niektb/sluisbrinkie-eurorack-published/Sluisbrinkie Toepler+/Hardware/toepler_plus_frontpanel/toepler_plus_frontpanel.png

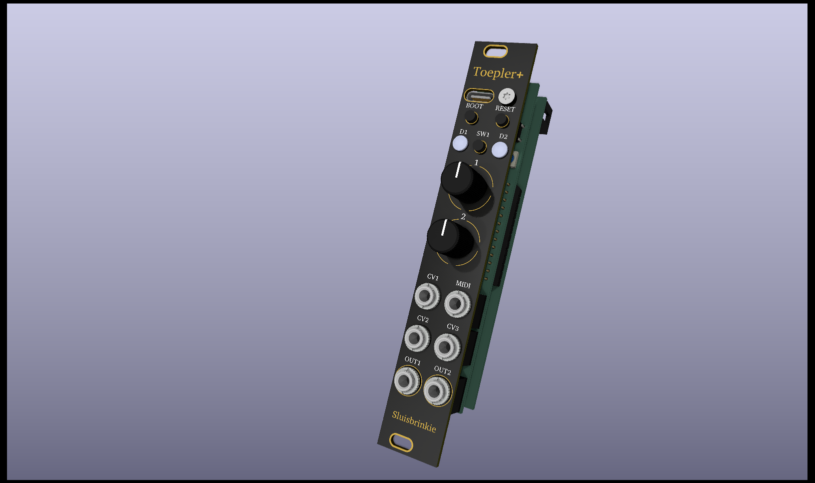
Sluisbrinkie Toepler+/Hardware/toepler_plus_frontpanel/toepler_plus_frontpanel.png
