niektb/sluisbrinkie-eurorack-published/Sluisbrinkie Toepler+/Hardware/toepler_plus_frontpanel/toepler_pro_frontpanel_backside.png

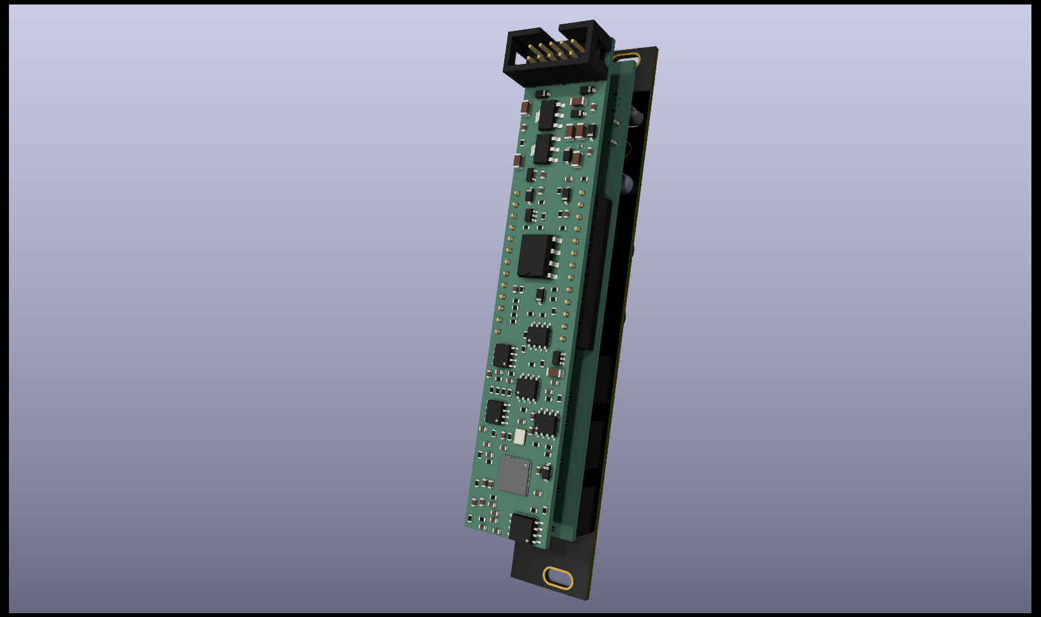
Sluisbrinkie Toepler+/Hardware/toepler_plus_frontpanel/toepler_pro_frontpanel_backside.png
