niektb/sluisbrinkie-eurorack-published/Mutable Meta Module/README.md

# Sluisbrinkie x Poetaster MMM (Mutable Meta Module)
This page (and module) is work-in-progress. Don't build it yet, it may contain mistakes :)




Hardware-platform to work in tandem with the software in this repository: https://github.com/poetaster/arduinoMI
