niektb/sluisbrinkie-eurorack-published/Sluisbrinkie Jacquard/README.md

# Jacquard
The Jacquard is a custom frontpanel for the Mutable Instruments Plaits. This directory contains the KiCad design.
