niektb/sluisbrinkie-eurorack-published/Sluisbrinkie Toepler+/README.md

# Sluisbrinkie Toepler+
The Toepler+ is the streamlined successor to the Toepler. It is one-third of the size (some features have been removed to make this possible) and has a much faster processor (RP2040 instead of Atmega32u4). The size is 4 HP. 
The upgraded processor allows for complex synthesis algorithms. MIDI support also allows the module to be truly polyphonic. The uni-color LEDs have been replaced by 2 Addressable RGB LEDs. It is compatible with both Arduino and CircuitPython, offering a friendly programming environment.
All the interfaces are located at the front of the module, meaning that nothing has to be unscrewed and removed from the rack when you want to do some programming. In fact, it can also be programmed when the rack is still powered (although pops and clicks are to be expected if the outputs are connected).
The USB connector can also be used for USB MIDI. The flash size is 128Mbit, meaning there is ample space for storing wavetables or short samples.







In case you bought a PCB (with assembled SMD components) and panel from me, there are a number of things you need to finish the build:
- 5x Thonkiconn mono jacks
- 1x Thonkiconn stereo jack
- 3x pushbuttons with at least 13mm shaft
- 2x 10kOhm Type B potentiometer (Bourns PVT09 series are used in my builds)
- 2x potentiometer knobs (see note below)
- 2x WS2812B RGB LEDs
- 1x USB-C UJ20-C-V-C-2-SMT-TR
- 1x 2x5 pinheader (for eurorack power supply)
- 2x 13p pinheader single row (for connecting back PCB to front PCB)
- 2x 13p pinsocket single row (for connecting back PCB to front PCB)
- M2.5 spacer and bolt to fixate frontpanel to front PCB (recommended to avoid stressing the PCB when plugging cables into the USB connector)

## Things that are useful to know
- To unleash the module's potential, it is recommended that you have some programming experience and enjoy programming :)
- The USB-C and ARGB LEDs need to be soldered with care. I would not recommend this project for the absolute beginners!
- This is the orientation for soldering the ARGBs:



- The jack MIDI port is receiving only, transmitting MIDI is not possible.
- The USB-C port is not capable of powering external devices.
- The voltage levels of the microcontroller are 0-3.3V. The Audio Output is DC-Coupled and ranges between 0V and 10V. The CV inputs are -5V to 5V and are mapped to the microcontroller range using attenuation and offset. 

## Software (CircuitPython)
### Flashing the firmware
Adafruit has an excellent guide on how to get started with CircuitPython and how to flash it to your board. But instead of downloading the firmware from the Adafruit website, use the firmware.uf2 from the CircuitPython\Firmware\Build folder. The config files are located in the other folder, in case you want to build from scratch (for example, to update to a newer CircuitPython version).

### Writing software
you can use the dir('board') commando to see which pins are available. Also refer to the schematic to get exact details of the implementation. I've created some examples in the CircuitPython, which are based on the synthio examples (see the Adafruit website for a good tutorial on synthio).

## Software (Arduino)
The board can be used with Arduino but needs a bit more work setting up as it's a custom board. Line 1114 - 1367 from boards.txt contain the information that you need to add to your own boards.txt file. pins_arduino.h is what you need to complete the definition of your custom board. Mozzi examples work straight out of the box. Refer to pins_arduino and the schematic to learn the pin mapping (and which pins are pre-mapped).
