niektb/sluisbrinkie-eurorack-published/Sluisbrinkie Kirchhoff/README.md

# Simple Bus Board Project
Published for Synthux Academy

58293091-4d07-4cf6-a1f3-881745db2266
Dimensions: 6cm x 10cm
