niektb/sluisbrinkie-eurorack-published/Sluisbrinkie Kepler/Schematic PDF/README.md

# Kepler Schematic
This folder contains my version of the Kastle Arp schematic. It's similar to the original schematic but made compatible with the Eurorack standard.
