niektb/sluisbrinkie-eurorack-published/Sluisbrinkie Kepler/Software/kastleSynth_1_5/README.md

This folder contains binaries for the Kastle Synth, as the official Arduino projects don't seem to work properly for the Synth. Should be flashed with AVRDUDE (or a GUI for AVRDUDE)
