niektb/sluisbrinkie-eurorack-published/Sluisbrinkie Kepler/Photo's/20240104_133646.jpg

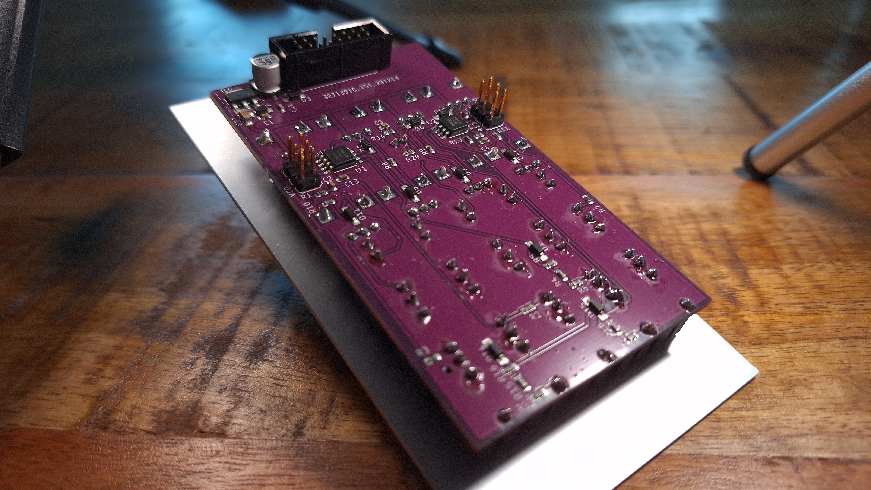
Sluisbrinkie Kepler/Photo's/20240104_133646.jpg
