niektb/sluisbrinkie-eurorack-published/Sluisbrinkie Kepler/Photo's/20240104_133847.jpg

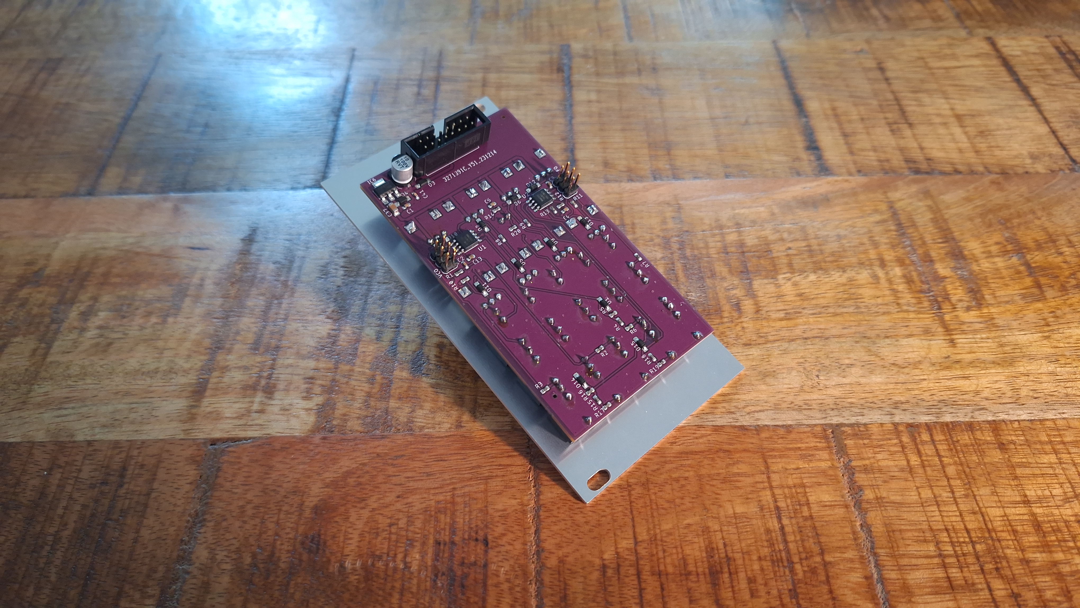
Sluisbrinkie Kepler/Photo's/20240104_133847.jpg
