niektb/sluisbrinkie-eurorack-published/Sluisbrinkie Shannon/kicad/fv1_front_module/production/bom.csv

Designator | Footprint | Quantity | Value | LCSC Part #
_26, _25, _24, _23, _22, _21, _20, _19, _18, _17, _16, _15, _14, _13, _12, _11, _10, _9, _8, _7, _6, _5, _4, _3, _2, |  | 26
