niektb/sluisbrinkie-eurorack-published/Mutable Meta Module/Hardware/kicad/mmm_frontpanel/production/bom.csv

Designator | Footprint | Quantity | Value | LCSC Part #
_18, _17, _16, _15, _14, _13, _12, _11, _10, _9, _8, _7, _6, _5, _4, _3, _2, |  | 18
