niektb/sluisbrinkie-eurorack-published/Andes/Hardware/andes_8hp/front_pcb/front_pcb.step

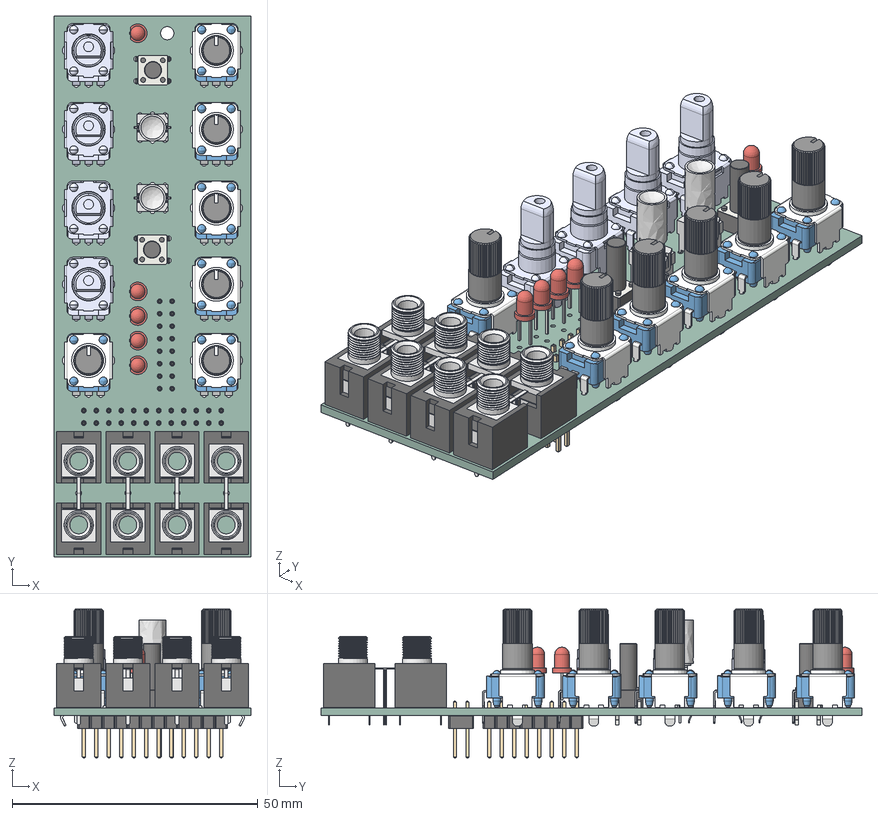
[picture p7: CAD file, 2024-09-19]
Andes/Hardware/andes_8hp/front_pcb/front_pcb.step
40.0 x 110.0 x 30.3 mm
RK09D1130-F20 x 4
P:\E-Switch Secure\3D_MODELS_STP_FORMAT\LP4xx1PBCxx.stp x 2
Thonkiconn - PJ398SM v10 x 8
SW_PUSH_6mm_h13mm x 2
R0904N-L-20KQ_Scket x 6
LED_D3.0mm x 5
PinHeader_2x12_P254mm_Vertical
PinHeader_2x08_P254mm_Vertical
_autosave-front_pcb_PCB
