niektb/sluisbrinkie-eurorack-published/Andes/Hardware/andes_8hp/frontpanel/frontpanel.step

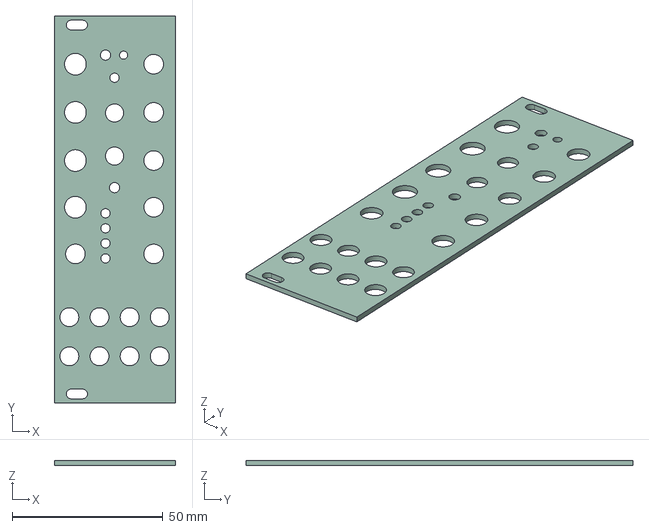
[picture p8: CAD file, 2024-09-18]
Andes/Hardware/andes_8hp/frontpanel/frontpanel.step
40.3 x 128.5 x 1.60 mm
