niektb/sluisbrinkie-eurorack-published/Eurorack Case/tiny-rack-2x44hp_locrius_mod.stl

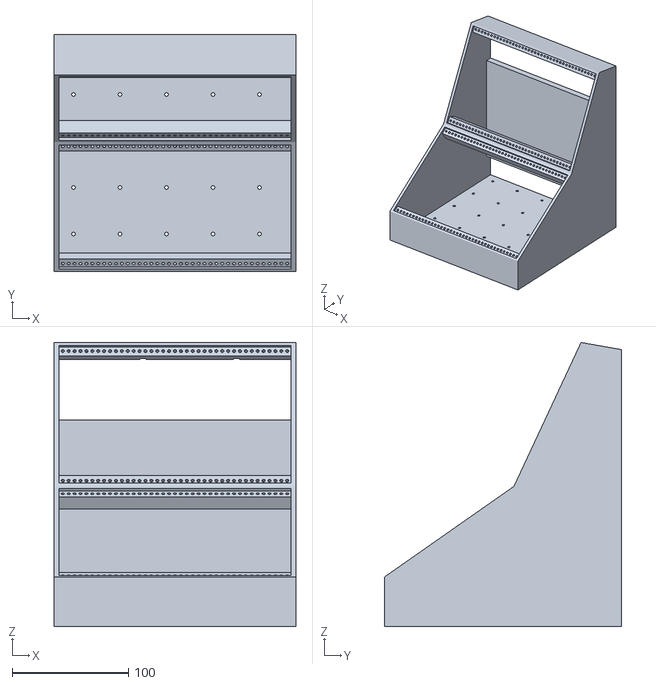
[picture p9: CAD file, 2024-06-02]
Eurorack Case/tiny-rack-2x44hp_locrius_mod.stl
207.9 x 204.0 x 244.3
