niektb/sluisbrinkie-eurorack-published/Sluisbrinkie Braun/Hardware/PI_SCOPE/TFT_320x240_touch_r0.step

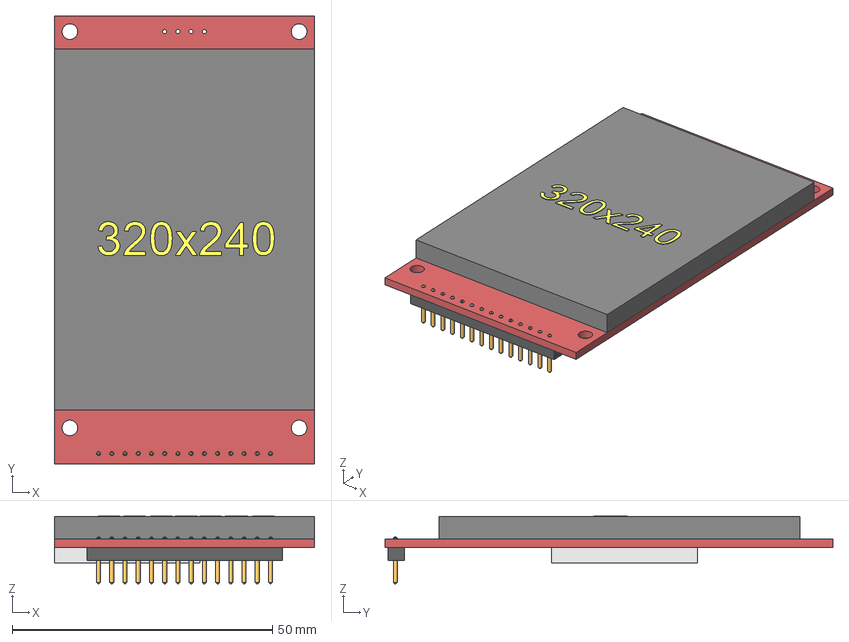
[picture p10: CAD file, 2025-04-17]
Sluisbrinkie Braun/Hardware/PI_SCOPE/TFT_320x240_touch_r0.step
50.0 x 86.0 x 13.1 mm
Body-header
Body-pins
Body-display
Body-sdcard
Body-board
