niektb/sluisbrinkie-eurorack-published/Sluisbrinkie Herford/kicad/herford/herford.step

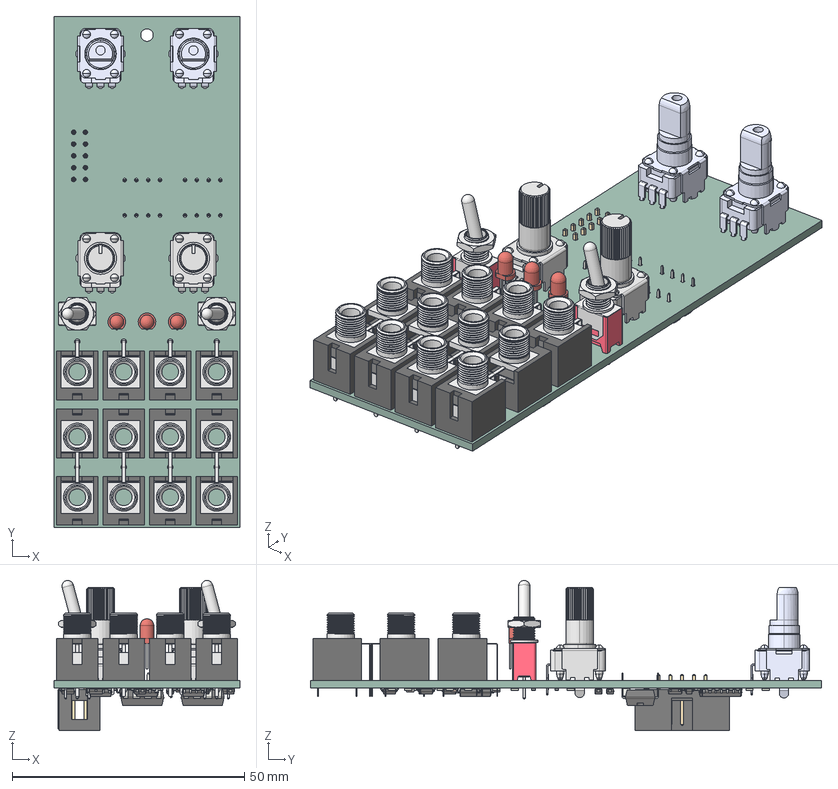
[picture p11: CAD file, 2025-04-24]
Sluisbrinkie Herford/kicad/herford/herford.step
40.0 x 110.0 x 32.3 mm
Thonkiconn - PJ398SM v10 x 12
RK09D1130-F20 x 2
Taiway sub miniature switch spdt v3 x 2
LED_D3.0mm x 3
RK09K1130-20 x 2
SOT_23 x 4
D_SOD_123 x 10
C_0603_1608Metric x 7
DIP-8_W7.62mm x 2
R_0603_1608Metric x 55
SOIC_8_39x49mm_P127mm x 3
SOIC_14_39x87mm_P127mm x 2
C_1206_3216Metric x 2
IDC_Header_2x05_P254mm_Vertical
ssg_PCB
