niektb/sluisbrinkie-eurorack-published/Sluisbrinkie Shannon/kicad/fv1_module/STEP/Thonkicon.obj

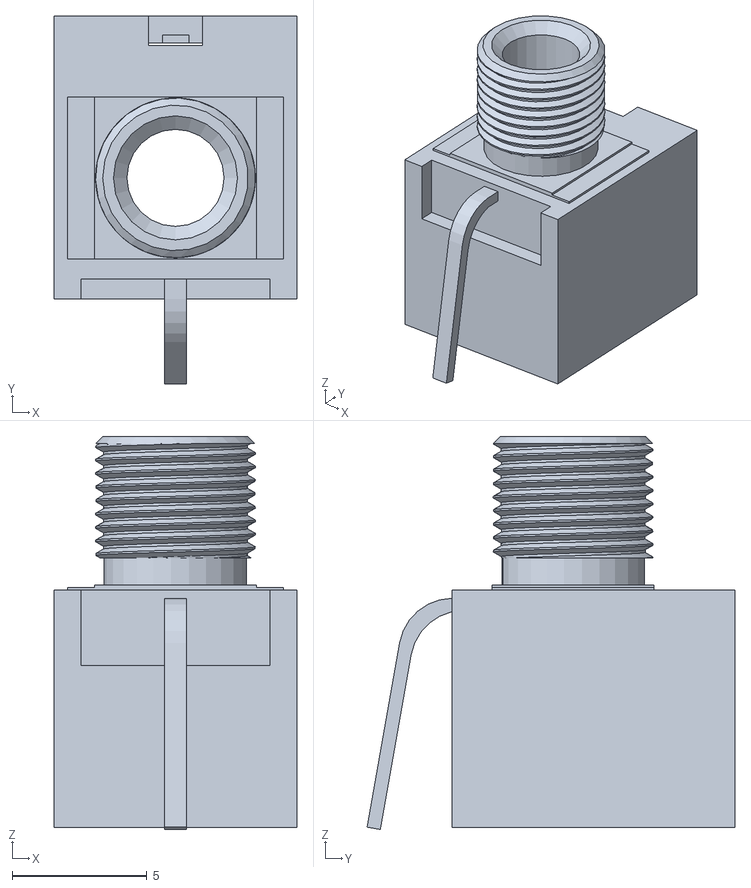
[picture p12: CAD file, 2025-11-06]
Sluisbrinkie Shannon/kicad/fv1_module/STEP/Thonkicon.obj
9.00 x 13.6 x 14.6
