niektb/sluisbrinkie-eurorack-published/Sluisbrinkie Toepler+/Hardware/toepler_plus/toepler_plus.step

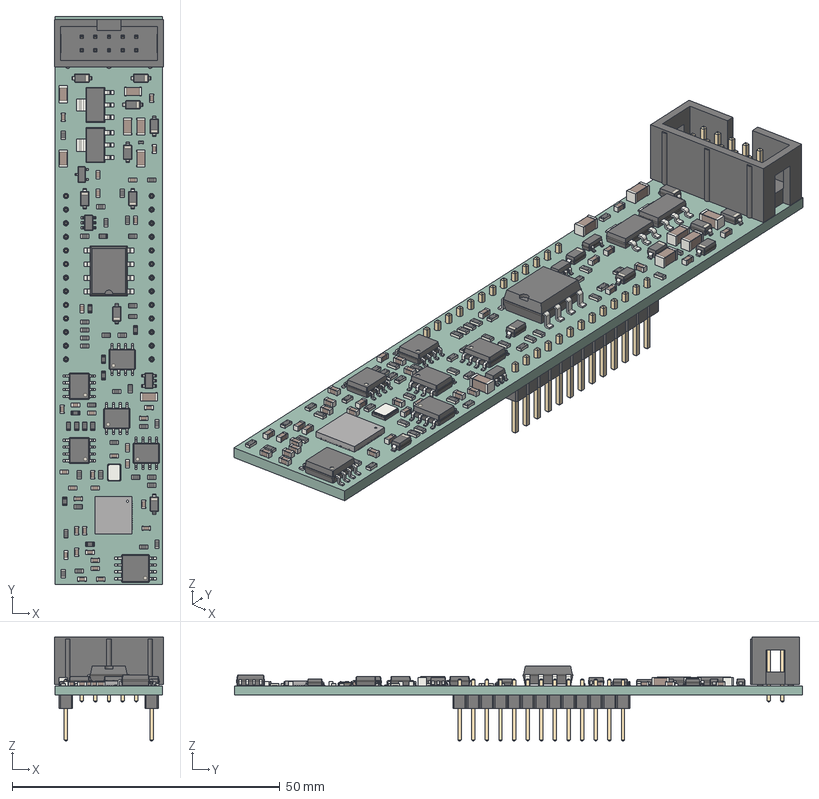
[picture p13: CAD file, 2025-04-03]
Sluisbrinkie Toepler+/Hardware/toepler_plus/toepler_plus.step
20.4 x 106.0 x 19.3 mm
R_0603_1608Metric x 45
C_0603_1608Metric x 32
D_SOD_123 x 9
C_1206_3216Metric x 7
SOT_223 x 2
SOIC_8_39x49mm_P127mm x 5
SOT_23_6
SOIC_8_5275x5275mm_P127mm
SMDIP_8_W953mm
QFN_56_1EP_7x7mm_P04mm_EP32x32mm
SOT_23_5
SOT_23
L_0402_1005Metric
IDC_Header_2x05_P254mm_Vertical
Crystal_SMD_3225-4Pin_3.2x2.5mm
PinHeader_1x13_P254mm_Vertical x 2
toepler_pro_PCB
