niektb/sluisbrinkie-eurorack-published/Sluisbrinkie Toepler+/Hardware/toepler_plus_frontpanel/files_SMC.STEP

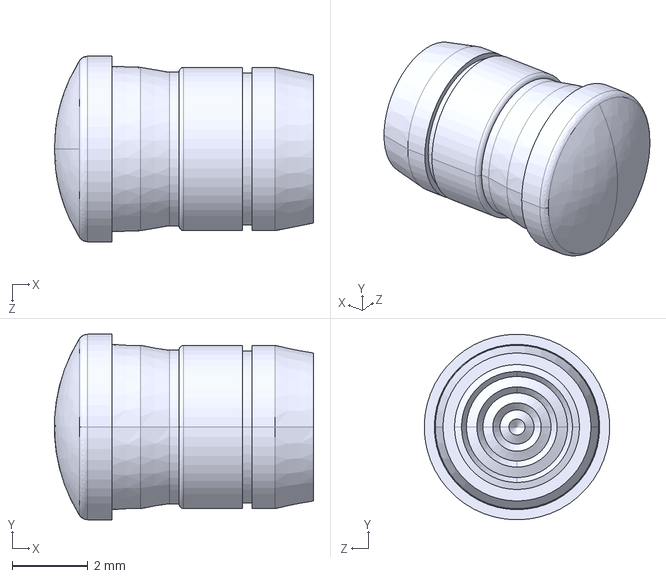
[picture p14: CAD file, 2025-04-03]
Sluisbrinkie Toepler+/Hardware/toepler_plus_frontpanel/files_SMC.STEP
6.84 x 4.90 x 4.90 mm
