niektb/sluisbrinkie-eurorack-published/Sluisbrinkie Shannon/kicad/fv1_module/STEP/cross_recessed_phillips_pan_head_M2.5x08.step

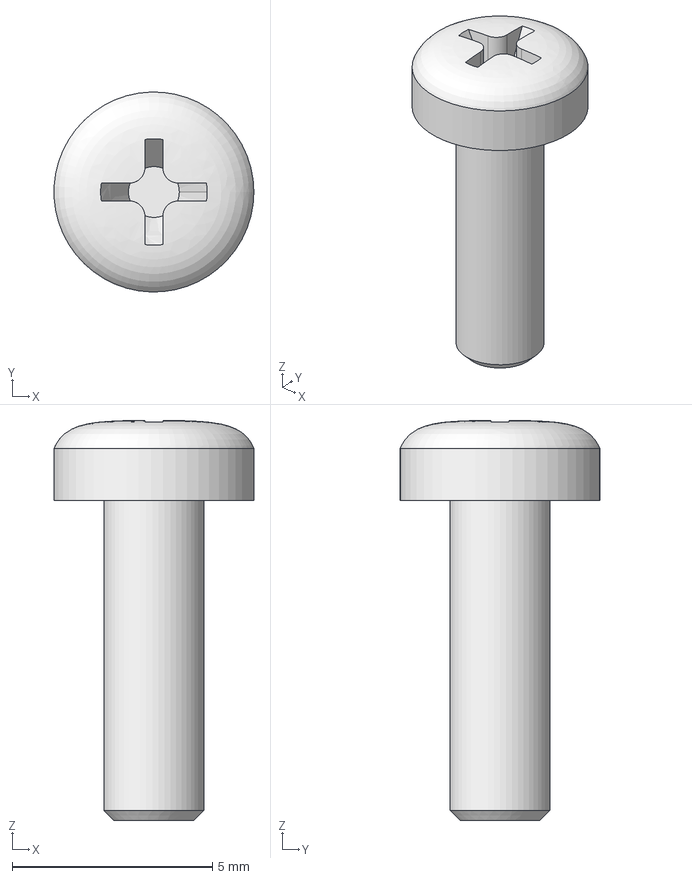
[picture p16: CAD file, 2025-11-06]
Sluisbrinkie Shannon/kicad/fv1_module/STEP/cross_recessed_phillips_pan_head_M2.5x08.step
5.00 x 5.00 x 10.00 mm
