niektb/sluisbrinkie-eurorack-published/Sluisbrinkie Shannon/kicad/fv1_module/STEP/200-MSP-1-T3-B1-M2-PE-rev2.step

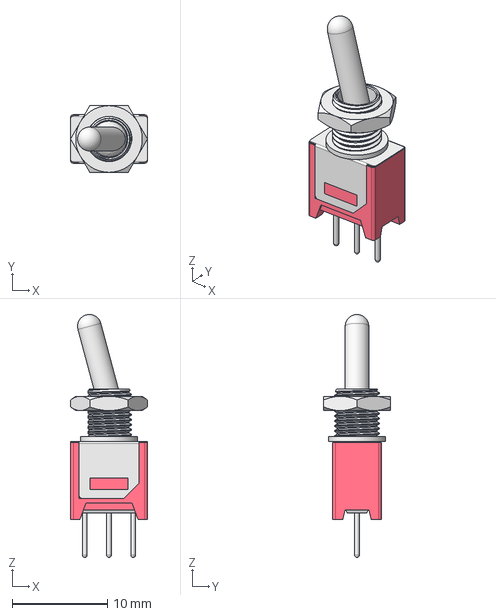
[picture p19: CAD file, 2025-04-24]
Sluisbrinkie Shannon/kicad/fv1_module/STEP/200-MSP-1-T3-B1-M2-PE-rev2.step
8.10 x 7.00 x 25.5 mm
