niektb/sluisbrinkie-eurorack-published/Sluisbrinkie Braun/Hardware/PI_SCOPE/STEP/SW-PEC11L-4220F-S0015.stp

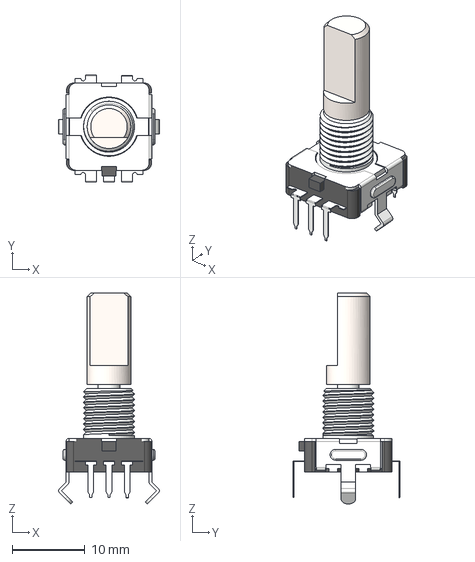
[picture p20: CAD file, 2025-04-17]
Sluisbrinkie Braun/Hardware/PI_SCOPE/STEP/SW-PEC11L-4220F-S0015.stp
13.8 x 14.7 x 29.0 mm
