niektb/sluisbrinkie-eurorack-published/Sluisbrinkie Shannon/kicad/fv1_module/STEP/Black - With Line (D-Shaft).stp

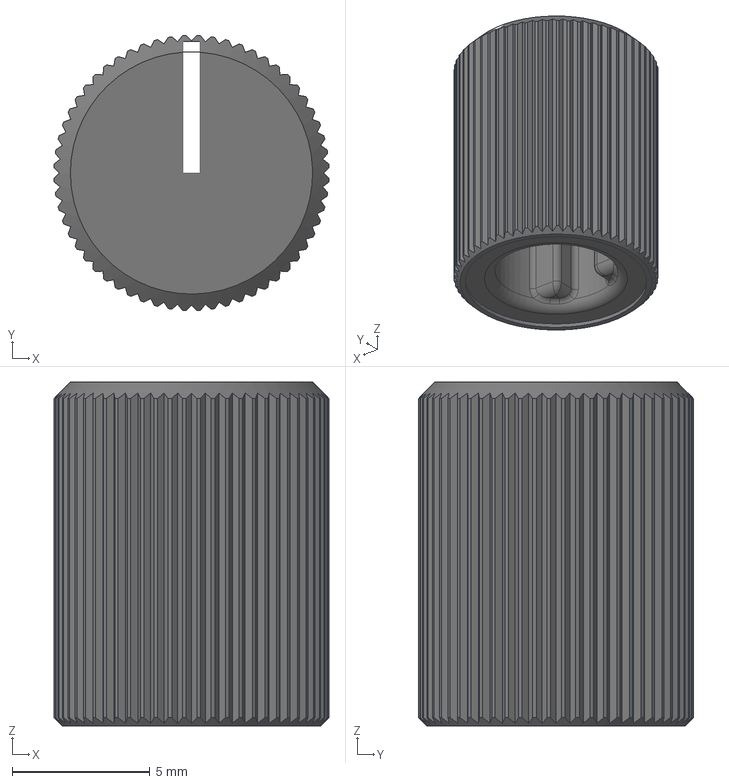
[picture p21: CAD file, 2025-04-17]
Sluisbrinkie Shannon/kicad/fv1_module/STEP/Black - With Line (D-Shaft).stp
9.99 x 9.99 x 12.5 mm
