niektb/sluisbrinkie-eurorack-published/Sluisbrinkie Braun/Hardware/PI_SCOPE/STEP/SW-PEC11R-4215F-N0024.stp

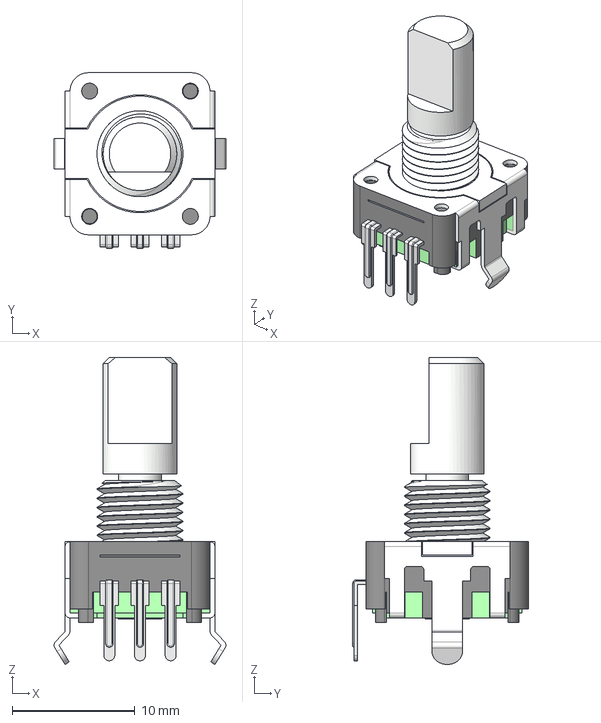
[picture p22: CAD file, 2025-04-17]
Sluisbrinkie Braun/Hardware/PI_SCOPE/STEP/SW-PEC11R-4215F-N0024.stp
14.0 x 14.3 x 25.0 mm
