niektb/sluisbrinkie-eurorack-published/Sluisbrinkie Shannon/kicad/fv1_module/STEP/RK09D1130-F20.STEP

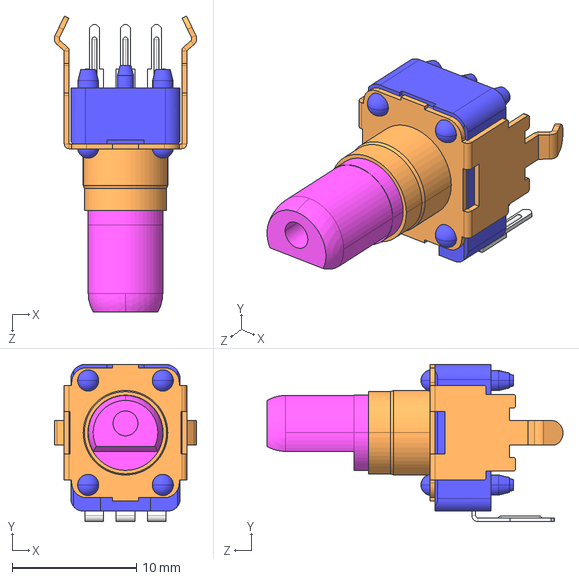
[picture p23: CAD file, 2025-04-17]
Sluisbrinkie Shannon/kicad/fv1_module/STEP/RK09D1130-F20.STEP
11.4 x 12.7 x 23.8 mm
