niektb/sluisbrinkie-eurorack-published/Sluisbrinkie Braun/Hardware/PI_SCOPE/STEP/GMT020-02 TFT SPI 240x320.STEP

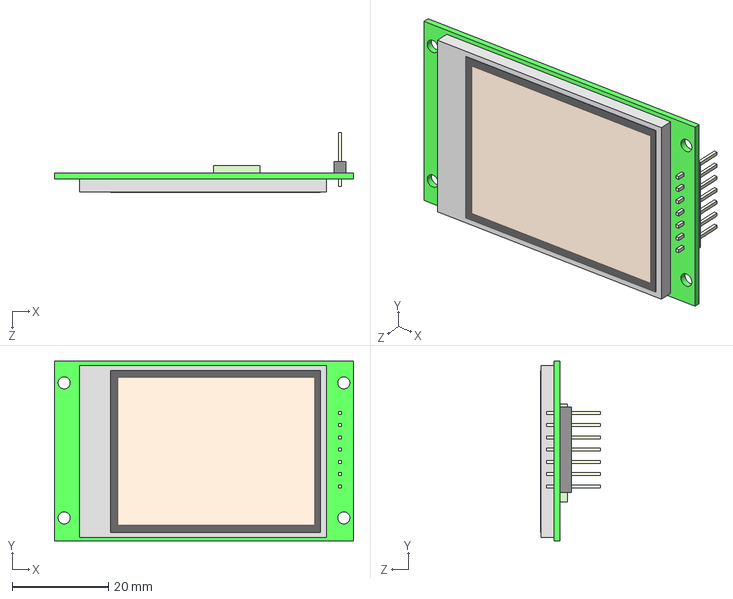
[picture p24: CAD file, 2025-04-17]
Sluisbrinkie Braun/Hardware/PI_SCOPE/STEP/GMT020-02 TFT SPI 240x320.STEP
62.0 x 37.3 x 12.4 mm
