niektb/sluisbrinkie-eurorack-published/Sluisbrinkie Shannon/kicad/fv1_module/STEP/1900h-bk-T-D.stp

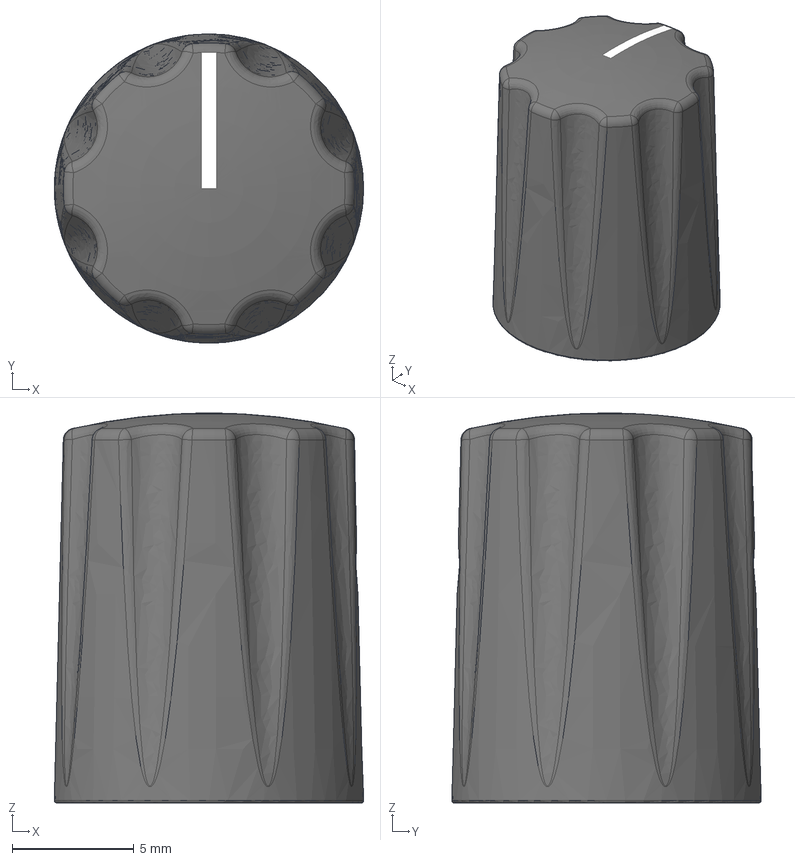
[picture p25: CAD file, 2025-04-17]
Sluisbrinkie Shannon/kicad/fv1_module/STEP/1900h-bk-T-D.stp
12.7 x 12.7 x 16.0 mm
