niektb/sluisbrinkie-eurorack-published/Sluisbrinkie Shannon/kicad/fv1_module/STEP/LP4xx1PxCxx.stp

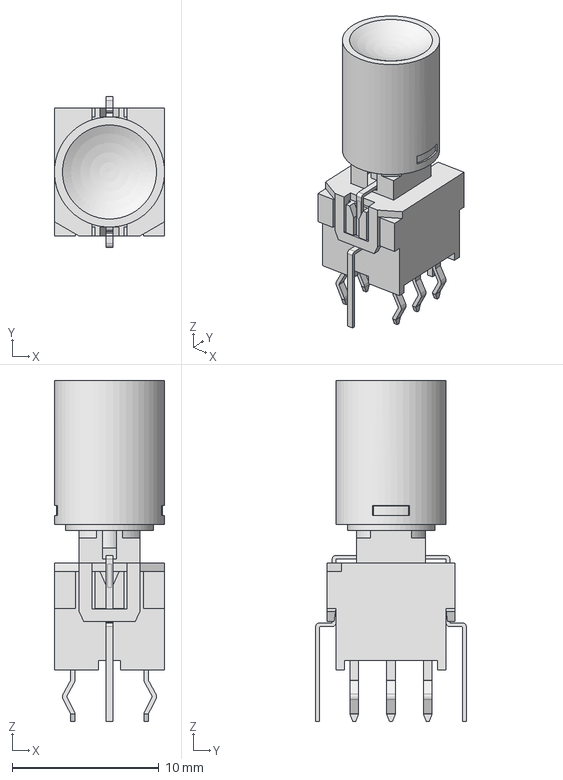
[picture p27: CAD file, 2025-04-17]
Sluisbrinkie Shannon/kicad/fv1_module/STEP/LP4xx1PxCxx.stp
7.50 x 10.2 x 23.2 mm
