niektb/sluisbrinkie-eurorack-published/Sluisbrinkie Shannon/kicad/fv1_module/STEP/R0904N-L-20KQ.stp

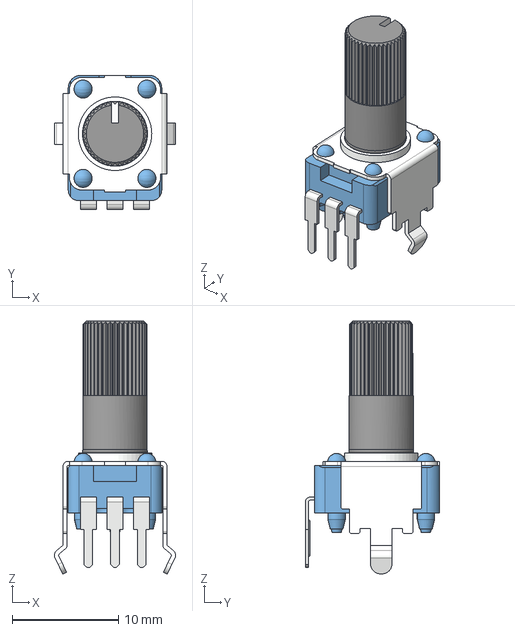
[picture p29: CAD file, 2025-04-17]
Sluisbrinkie Shannon/kicad/fv1_module/STEP/R0904N-L-20KQ.stp
11.4 x 12.7 x 23.8 mm
