niektb/sluisbrinkie-eurorack-published/Sluisbrinkie Braun/Hardware/PI_SCOPE/STEP/USB-C PCB vertical.stp

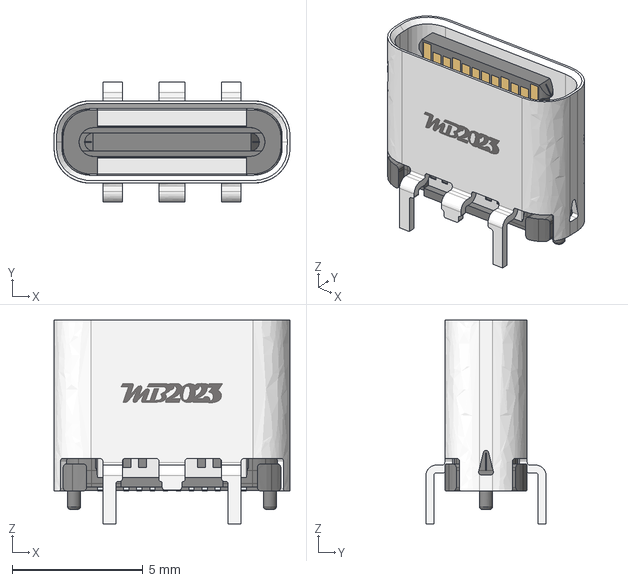
[picture p30: CAD file, 2025-04-03]
Sluisbrinkie Braun/Hardware/PI_SCOPE/STEP/USB-C PCB vertical.stp
9.04 x 4.60 x 7.80 mm
