niektb/sluisbrinkie-eurorack-published/Sluisbrinkie Shannon/kicad/fv1_module/STEP/KNUT-PJ398SM.stp

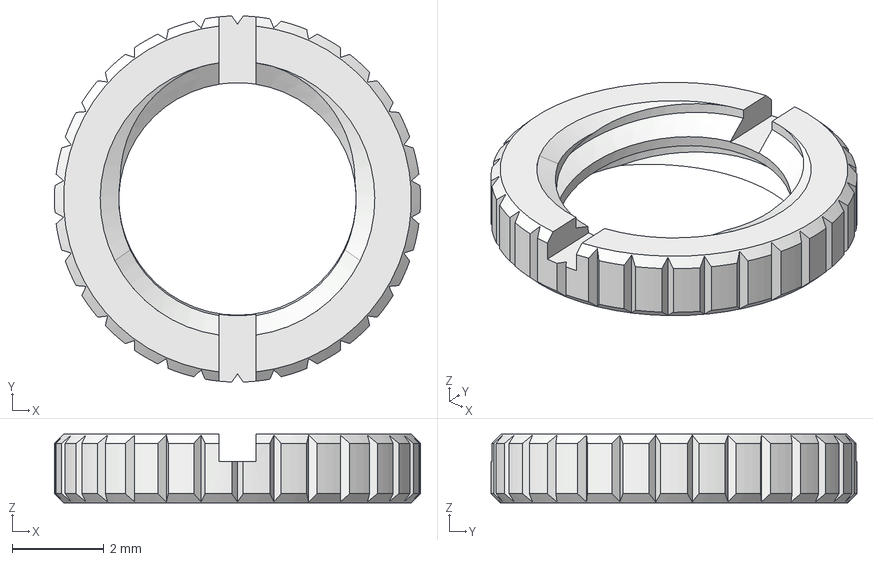
[picture p32: CAD file, 2025-04-17]
Sluisbrinkie Shannon/kicad/fv1_module/STEP/KNUT-PJ398SM.stp
8.00 x 8.00 x 1.50 mm
