niektb/sluisbrinkie-eurorack-published/Sluisbrinkie Shannon/kicad/fv1_module/STEP/torx_socket_countersunk_flat_head_M2.5x06.step

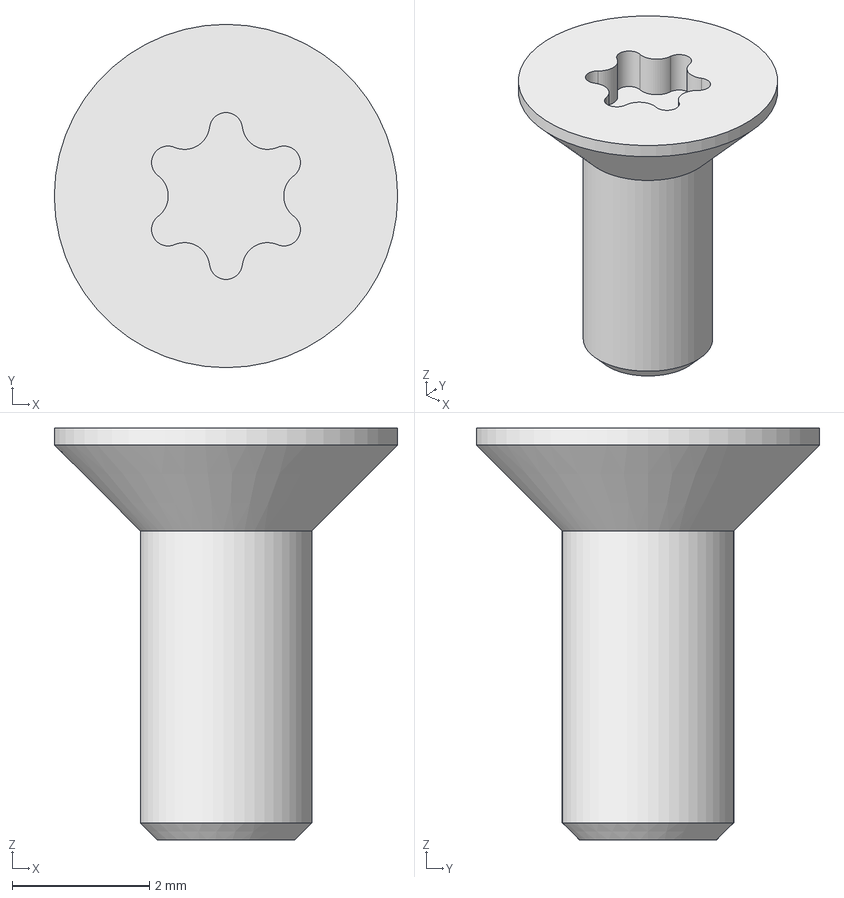
[picture p33: CAD file, 2025-04-17]
Sluisbrinkie Shannon/kicad/fv1_module/STEP/torx_socket_countersunk_flat_head_M2.5x06.step
5.00 x 5.00 x 6.00 mm
