niektb/sluisbrinkie-eurorack-published/Sluisbrinkie Shannon/kicad/fv1_module/STEP/RK09K1130-20.STEP

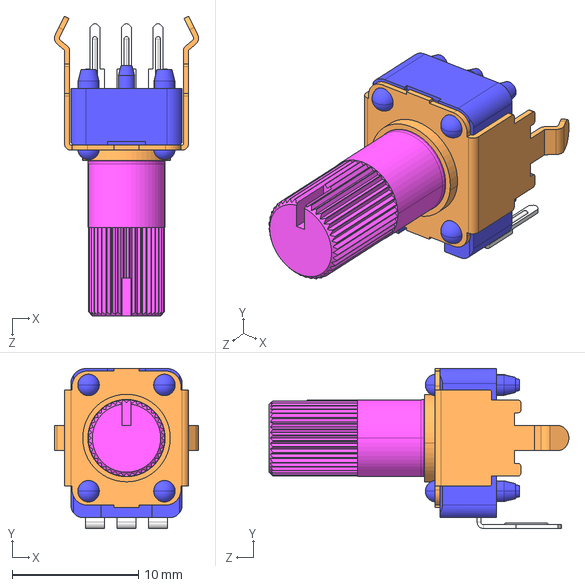
[picture p34: CAD file, 2025-04-17]
Sluisbrinkie Shannon/kicad/fv1_module/STEP/RK09K1130-20.STEP
11.4 x 12.7 x 23.7 mm
