niektb/sluisbrinkie-eurorack-published/Sluisbrinkie Shannon/kicad/fv1_module/STEP/Thonkiconn - PJ398SM.step

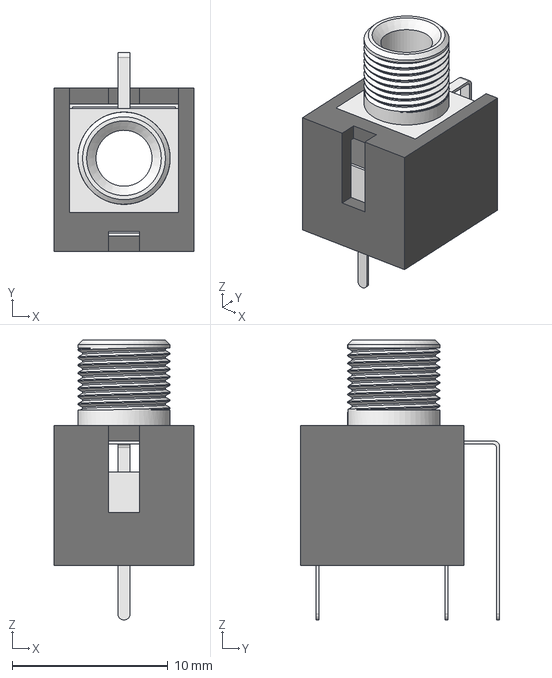
[picture p35: CAD file, 2024-09-14]
Sluisbrinkie Shannon/kicad/fv1_module/STEP/Thonkiconn - PJ398SM.step
9.00 x 12.8 x 18.0 mm
