niektb/sluisbrinkie-eurorack-published/(list of files, cad)

Other CAD files:
Andes/Hardware/andes_12hp/STEP/LP4xx1PxCxx.stp
Andes/Hardware/andes_12hp/STEP/RK09D1130-F20.STEP
Andes/Hardware/andes_12hp/STEP/RK09K1130-20.STEP
Andes/Hardware/andes_12hp/STEP/STM32F103C8T6_Blue_Pill v6.step
Andes/Hardware/andes_12hp/STEP/Thonkicon.obj
Andes/Hardware/andes_8hp/STEP/1900h-bk-T-D.stp
Andes/Hardware/andes_8hp/STEP/Black - With Line (D-Shaft).stp
Andes/Hardware/andes_8hp/STEP/KNUT-PJ398SM.stp
Andes/Hardware/andes_8hp/STEP/LP4xx1PxCxx.stp
Andes/Hardware/andes_8hp/STEP/R0904N-L-20KQ.stp
Andes/Hardware/andes_8hp/STEP/RK09D1130-F20.STEP
Andes/Hardware/andes_8hp/STEP/RK09K1130-20.STEP
Andes/Hardware/andes_8hp/STEP/STM32F103C8T6_Blue_Pill v6.step
Andes/Hardware/andes_8hp/STEP/Thonkicon.obj
Andes/Hardware/andes_8hp/STEP/torx_socket_countersunk_flat_head_M2.5x06.step
Andes/Hardware/andes_8hp/front_pcb/STEP/LP4xx1PxCxx.stp
Andes/Hardware/andes_8hp/front_pcb/STEP/RK09D1130-F20.STEP
Andes/Hardware/andes_8hp/front_pcb/STEP/RK09K1130-20.STEP
Andes/Hardware/andes_8hp/front_pcb/STEP/STM32F103C8T6_Blue_Pill v6.step
Andes/Hardware/andes_8hp/front_pcb/STEP/Thonkicon.obj
Sluisbrinkie Braun/Hardware/PI_SCOPE/STEP/Nut M7x075.stp
Sluisbrinkie Braun/Hardware/PI_SCOPE/STEP/Washer 11x7x0.5.stp
