niektb/sluisbrinkie-eurorack-published/(threads)

Thread 1 (2024-04-16):

Just some links for more tried and tested bytebeats ..

poetaster, 2024-04-16:
Hi, I just saw your module on tindie and started looking at it more carefully. It looks really well designed! I have a number of projects and have gathered a lot of formulas, running on 328p like devices:

https://github.com/poetaster/rampart/tree/master/rampart3-bytebeats

some of them are from Zack Schollz nyblycore, some from the glitchstorm and some my own ... and of course, from the boards :)  The ones referenced in bytebeats.h are all usable. The last 15 or so I haven't adjusted values for input C/3 yet. Maybe they're of interest to you :)

I hope to find some money to buy a kit from you. Or maybe we can do a trade?

niektb, 2024-04-20:
Hi poetaster! Thank you for your interest and compliment! Is there any way I can contact you directly? Kind regards, Niek

poetaster, 2024-04-20:
> Hi poetaster! Thank you for your interest and compliment! Is there any way I can contact you directly? Kind regards, Niek

I can be reached via email blueprint at poetaster.de ...
