niektb/sluisbrinkie-eurorack-published/Andes/Schematic PDF/andes.pdf

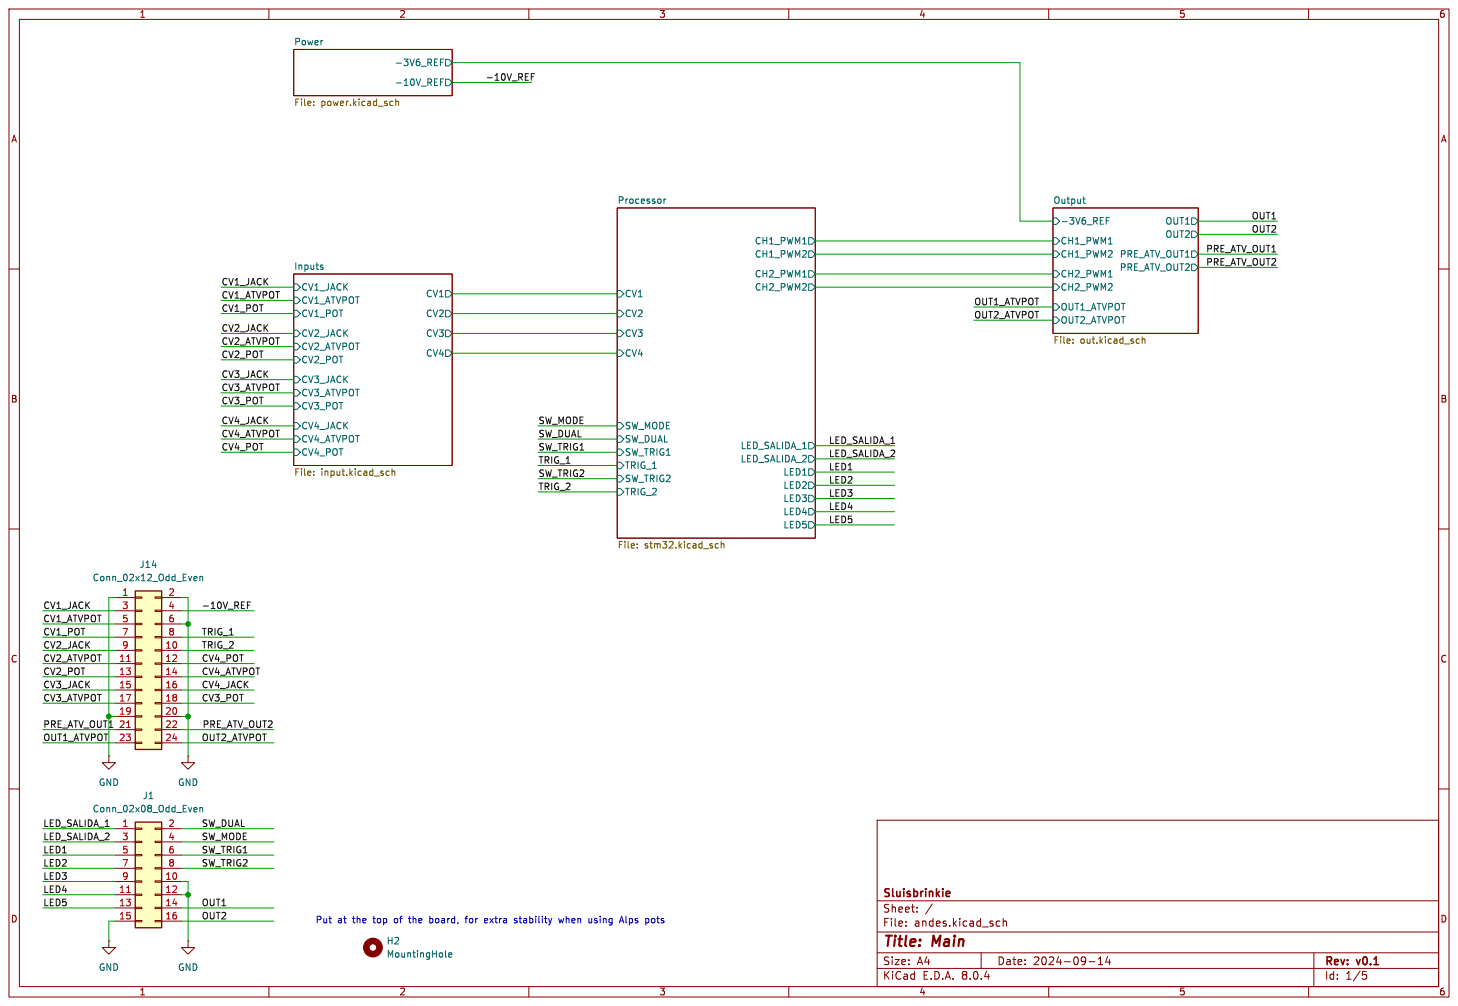
[picture p36: page 1]

File: andes.kicad_sch Sheet: / Sluisbrinkie

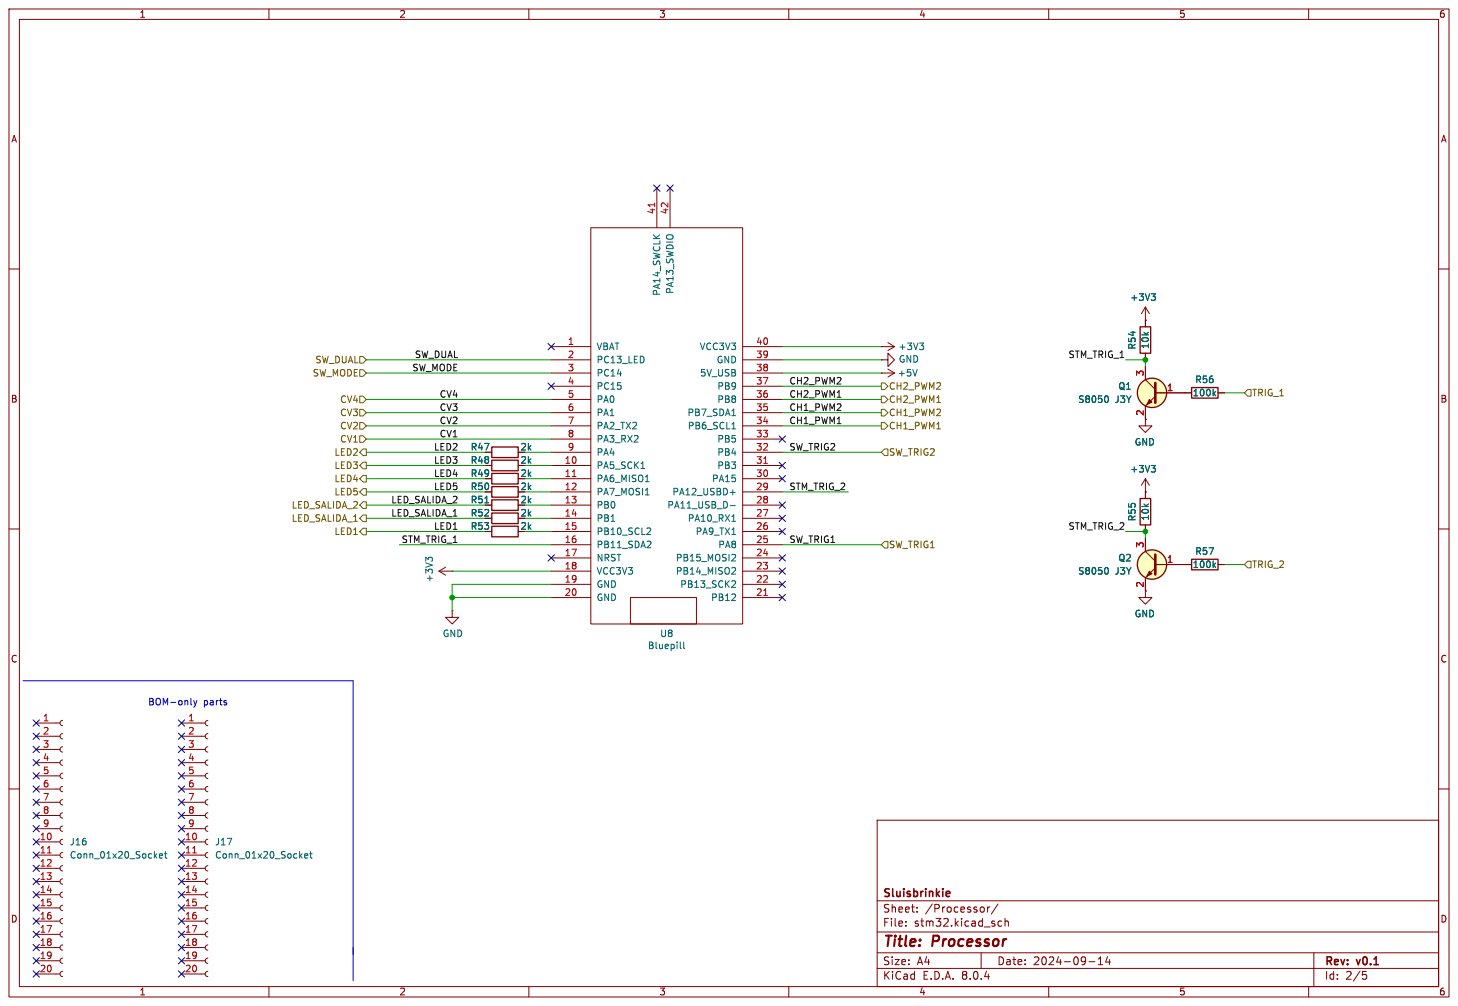
[picture p37: page 2]

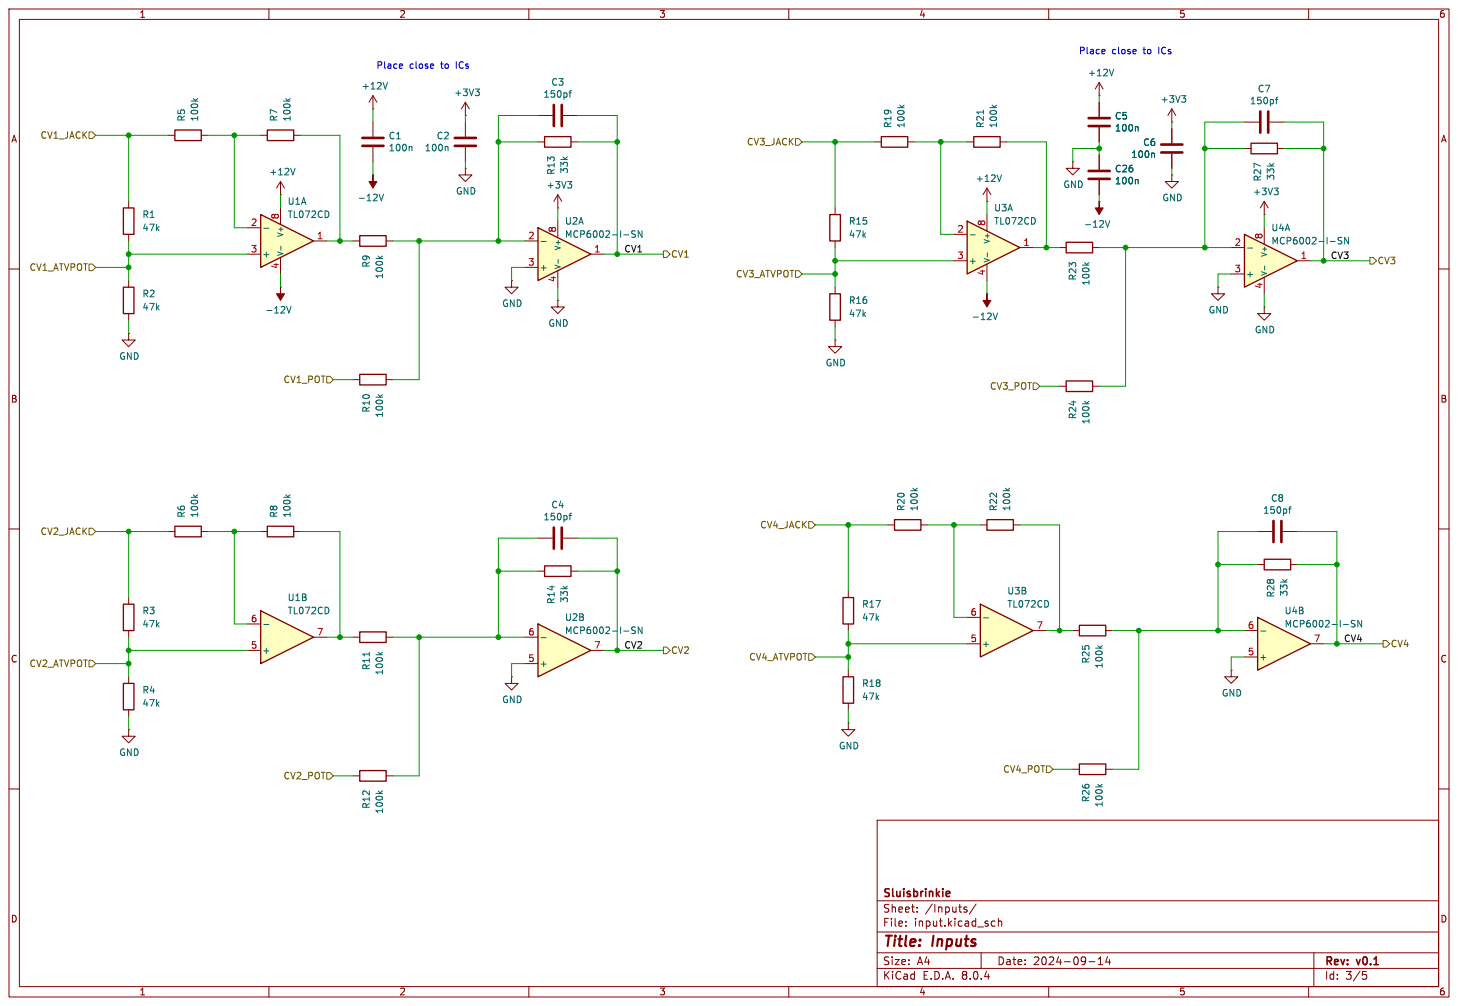
[picture p38: page 3]

File: input.kicad_sch Sheet: /Inputs/ Sluisbrinkie

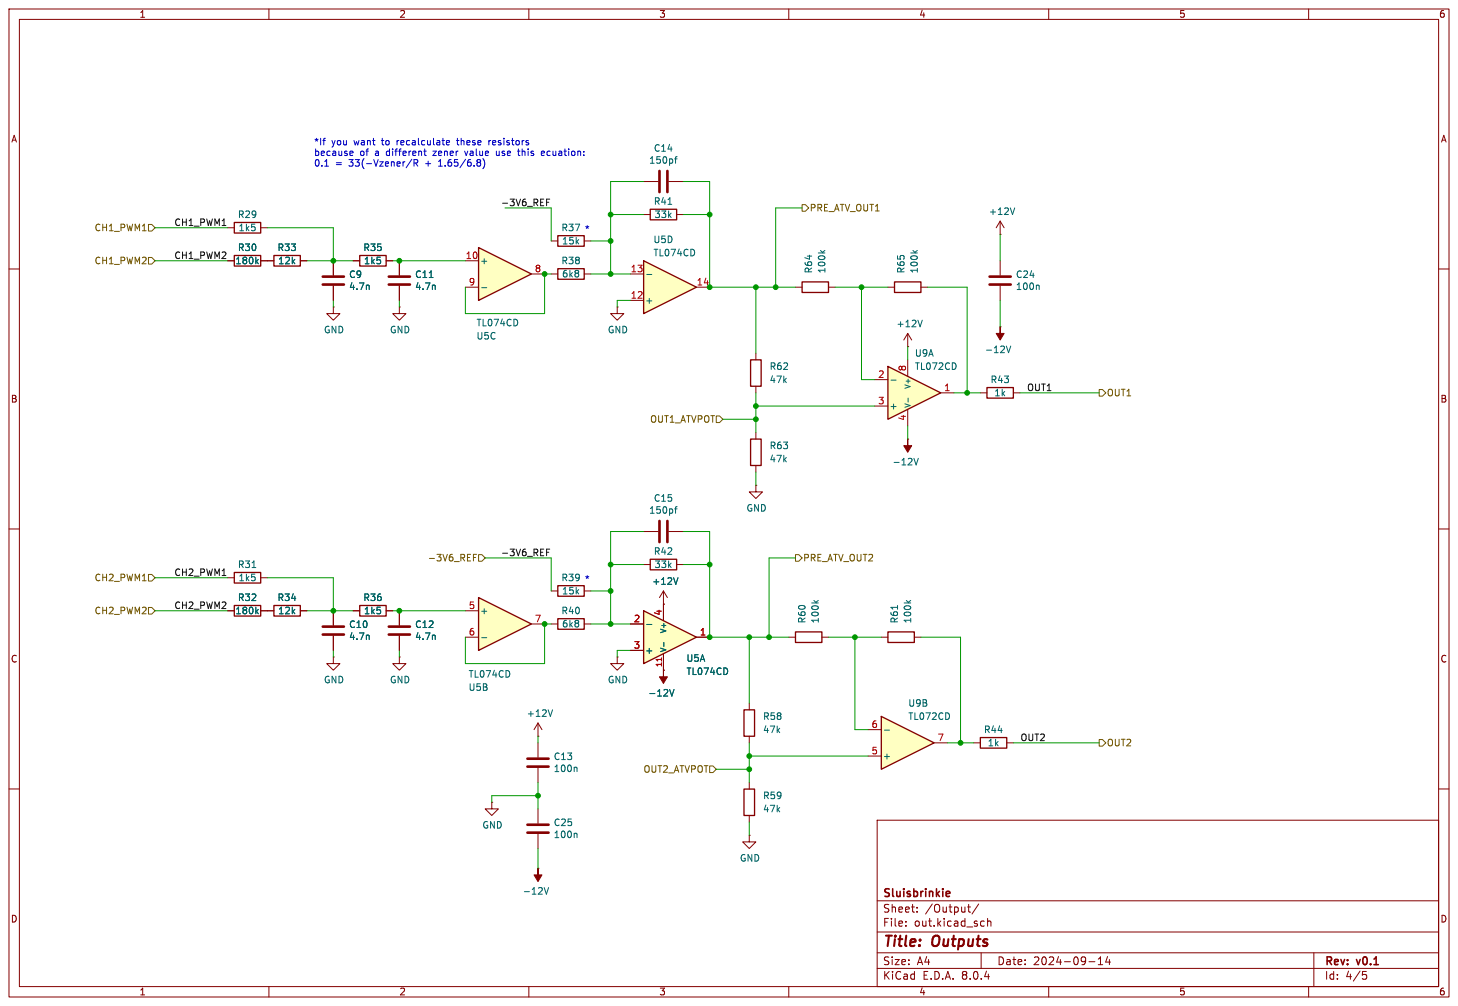
[picture p39: page 4]

File: out.kicad_sch Sheet: /Output/ Sluisbrinkie GND

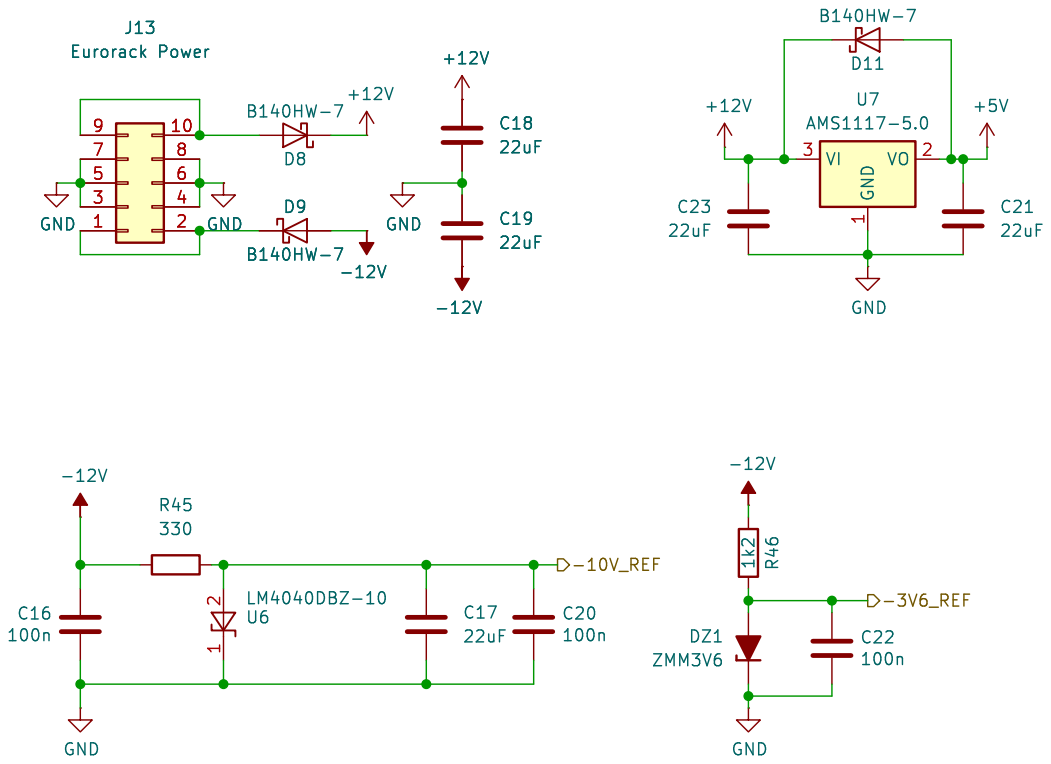
[picture p40: page 5]

Id: 5/5 Title: Power File: power.kicad_sch Sheet: /Power/ Sluisbrinkie
