niektb/sluisbrinkie-eurorack-published/Andes/Schematic PDF/8hp_back_pcb.pdf

File: andes.kicad_sch Sheet: / Sluisbrinkie



File: input.kicad_sch Sheet: /Inputs/ Sluisbrinkie


File: out.kicad_sch Sheet: /Output/ Sluisbrinkie GND

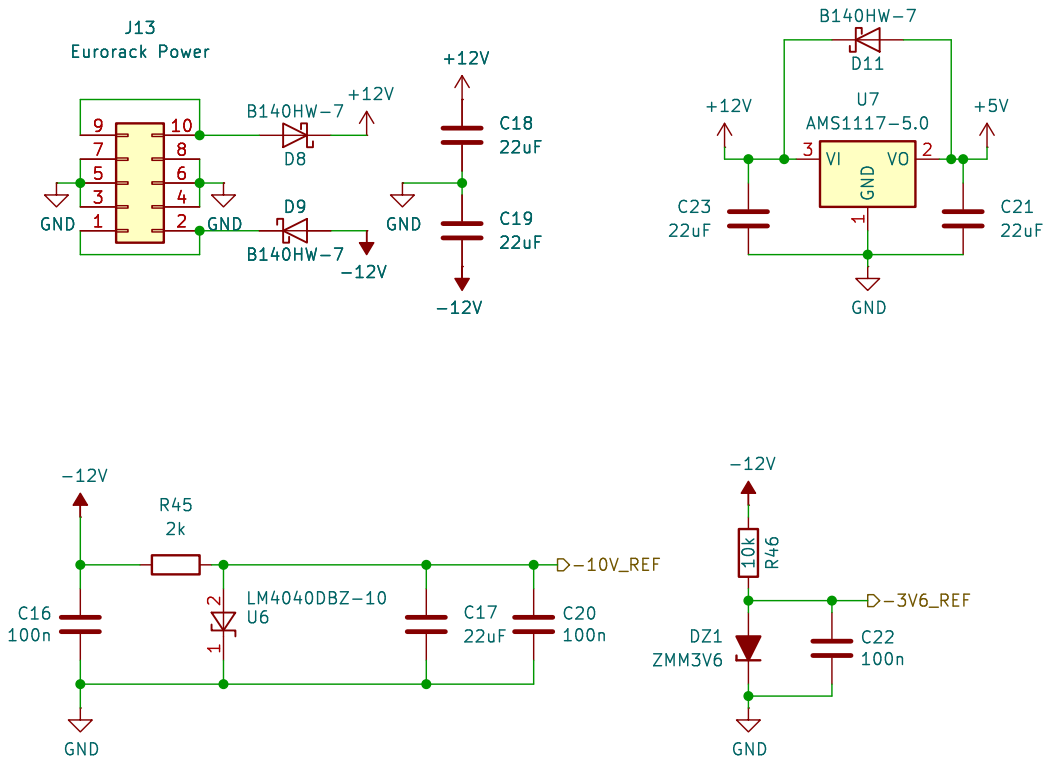
[picture p41: page 5]

Id: 5/5 Title: Power File: power.kicad_sch Sheet: /Power/ Sluisbrinkie
