niektb/sluisbrinkie-eurorack-published/Andes/Schematic PDF/8hp_front_pcb.pdf

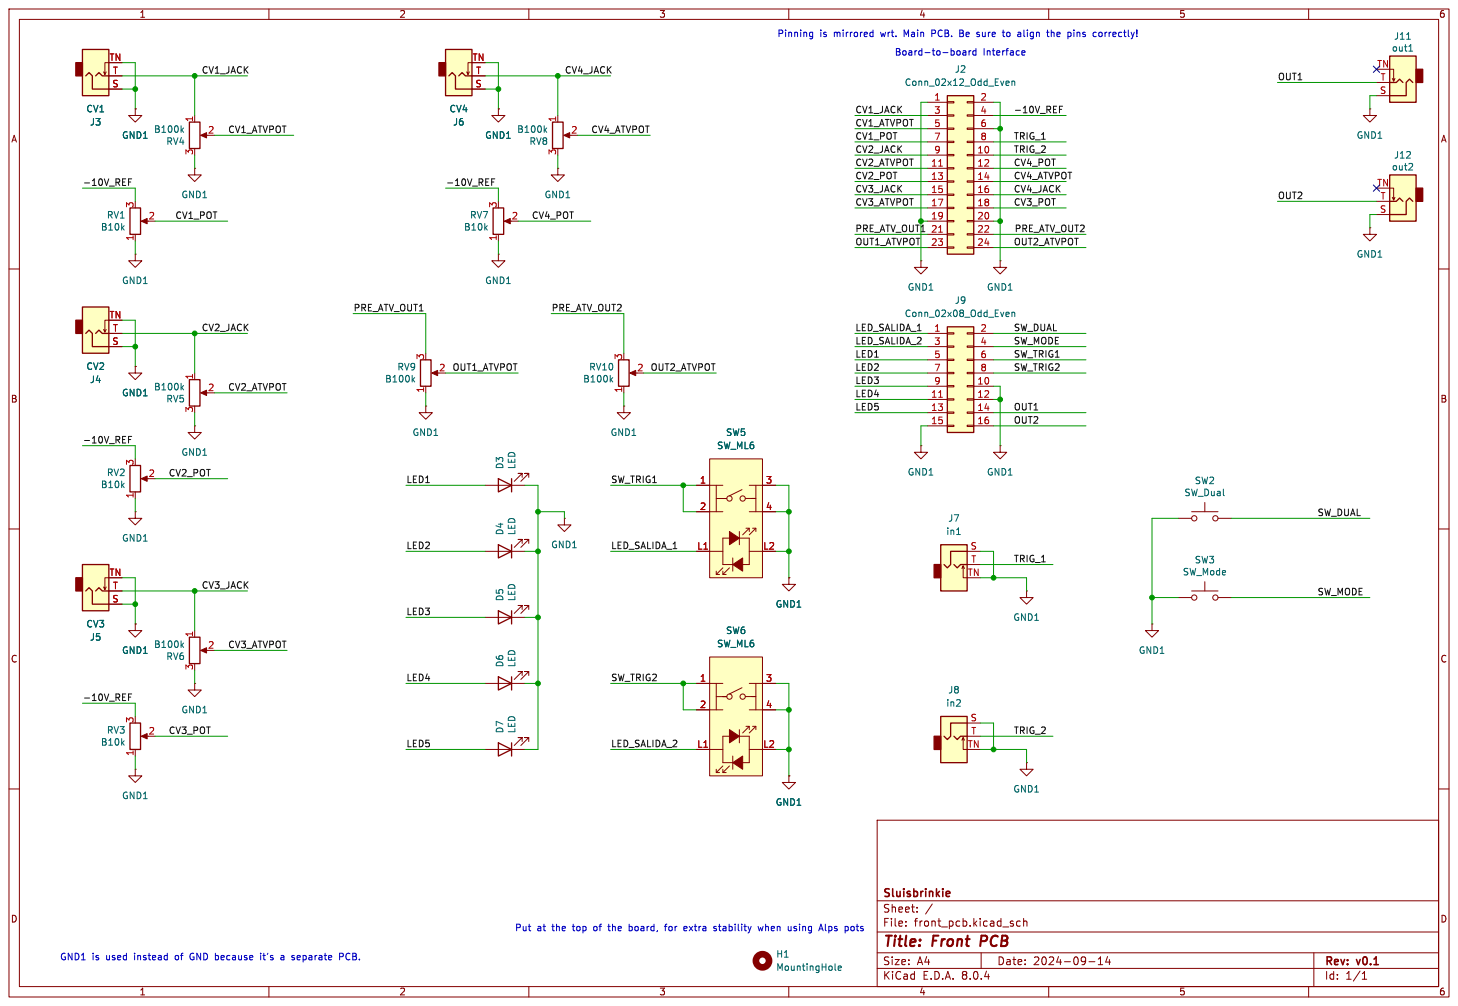
[picture p42: page 1]

3 RV1 B10k D5 LED D4 LED GND1 D3 LED D6 LED D7 LED

Id: 1/1 Title: Front PCB

GND1 is used instead of GND because it's a separate PCB.
