niektb/sluisbrinkie-eurorack-published/Sluisbrinkie Gauss/Schematic PDF/Gauss.pdf

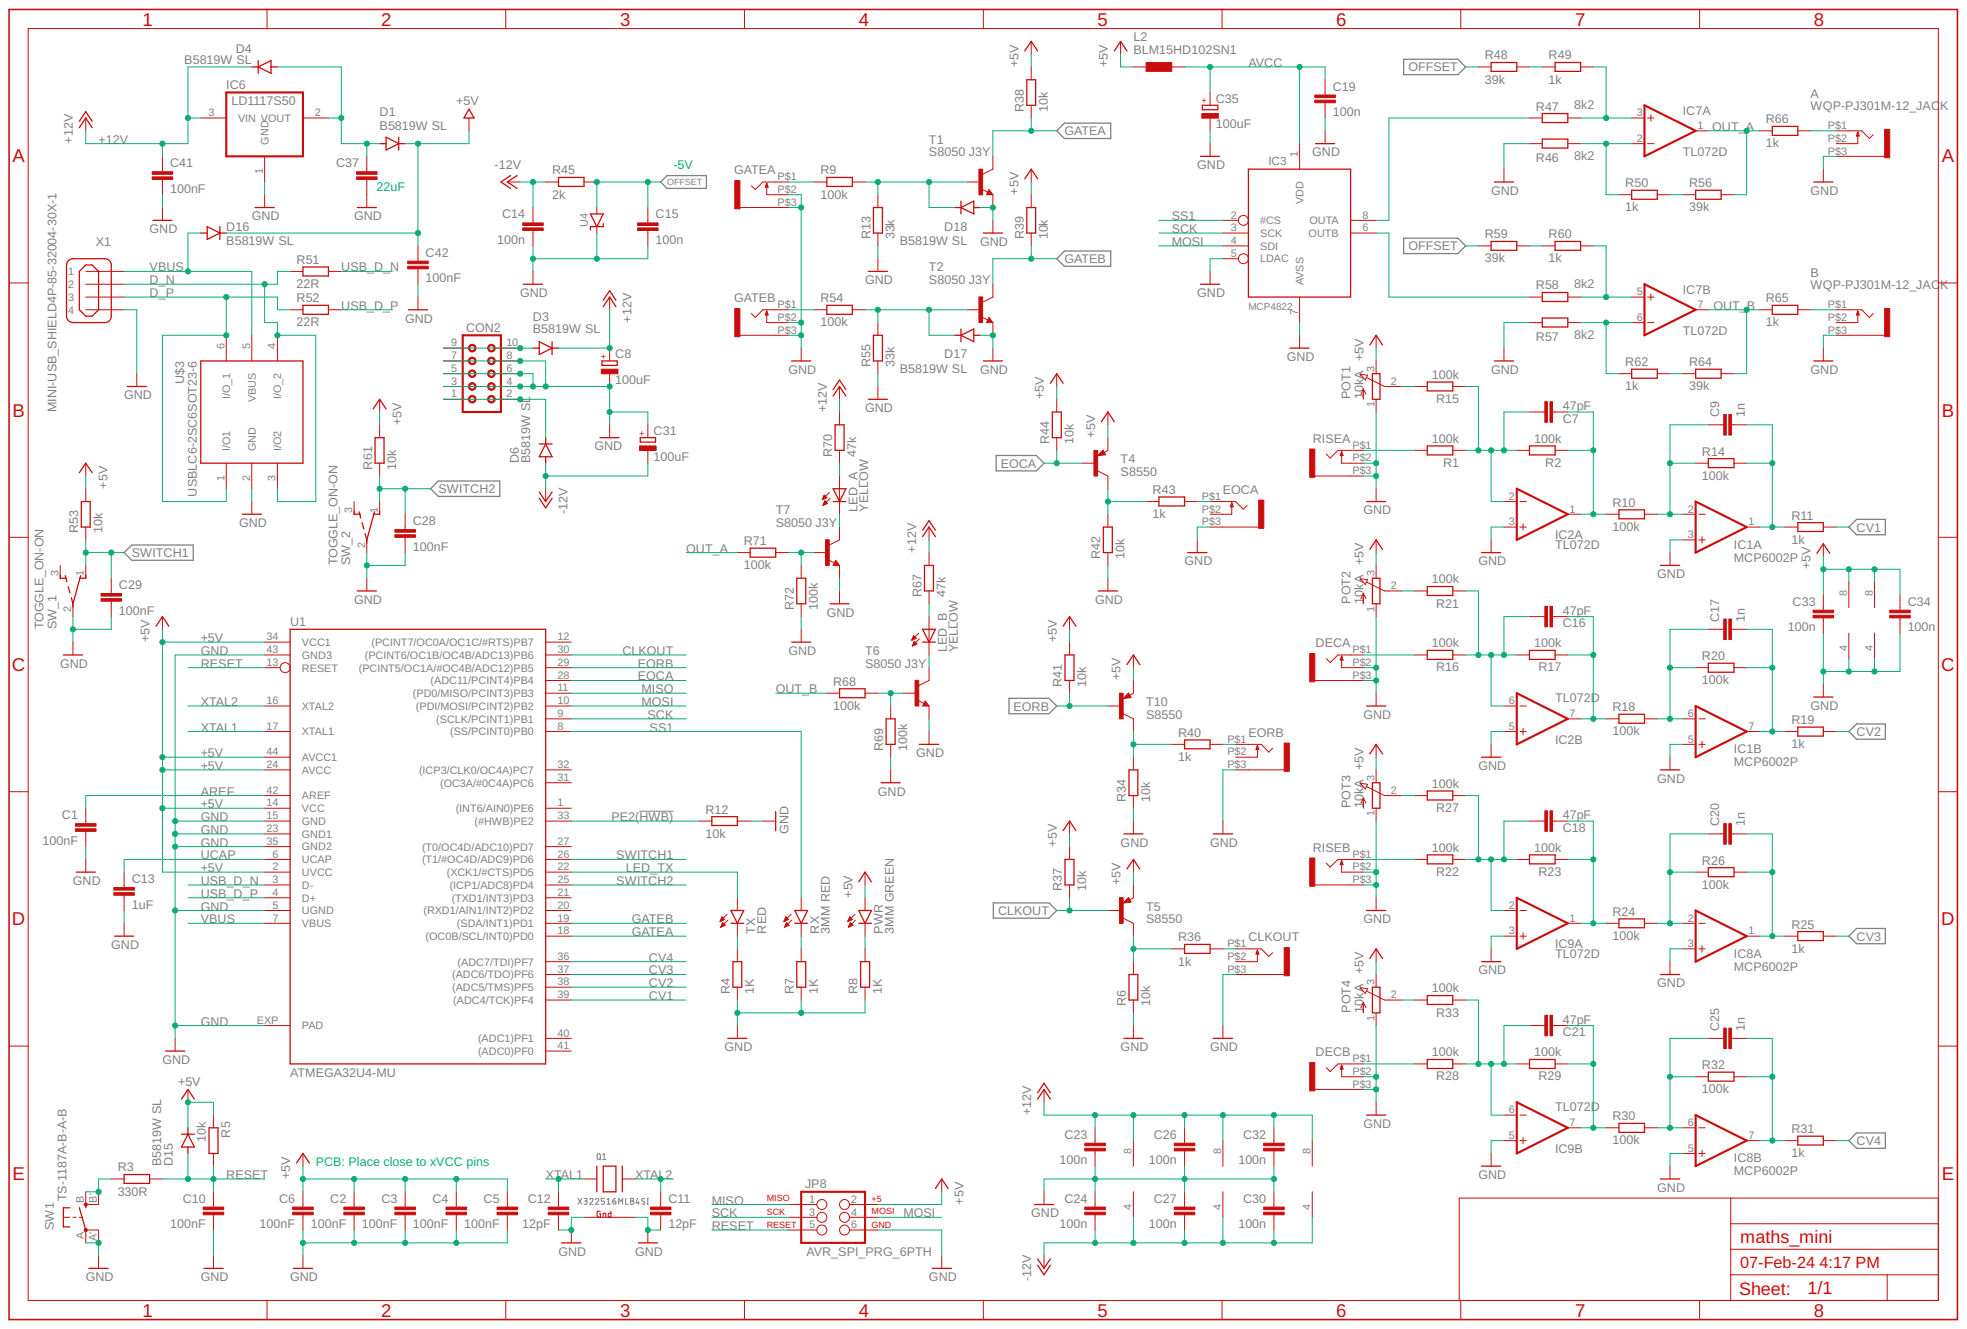
[picture p43: page 1]

+5V
AREF | 31

GND GND

USB_D_N | 25 21

PCB: Place close to xVCC pins
