niektb/sluisbrinkie-eurorack-published/Sluisbrinkie Toepler/Schematic PDF/toepler_v3.pdf

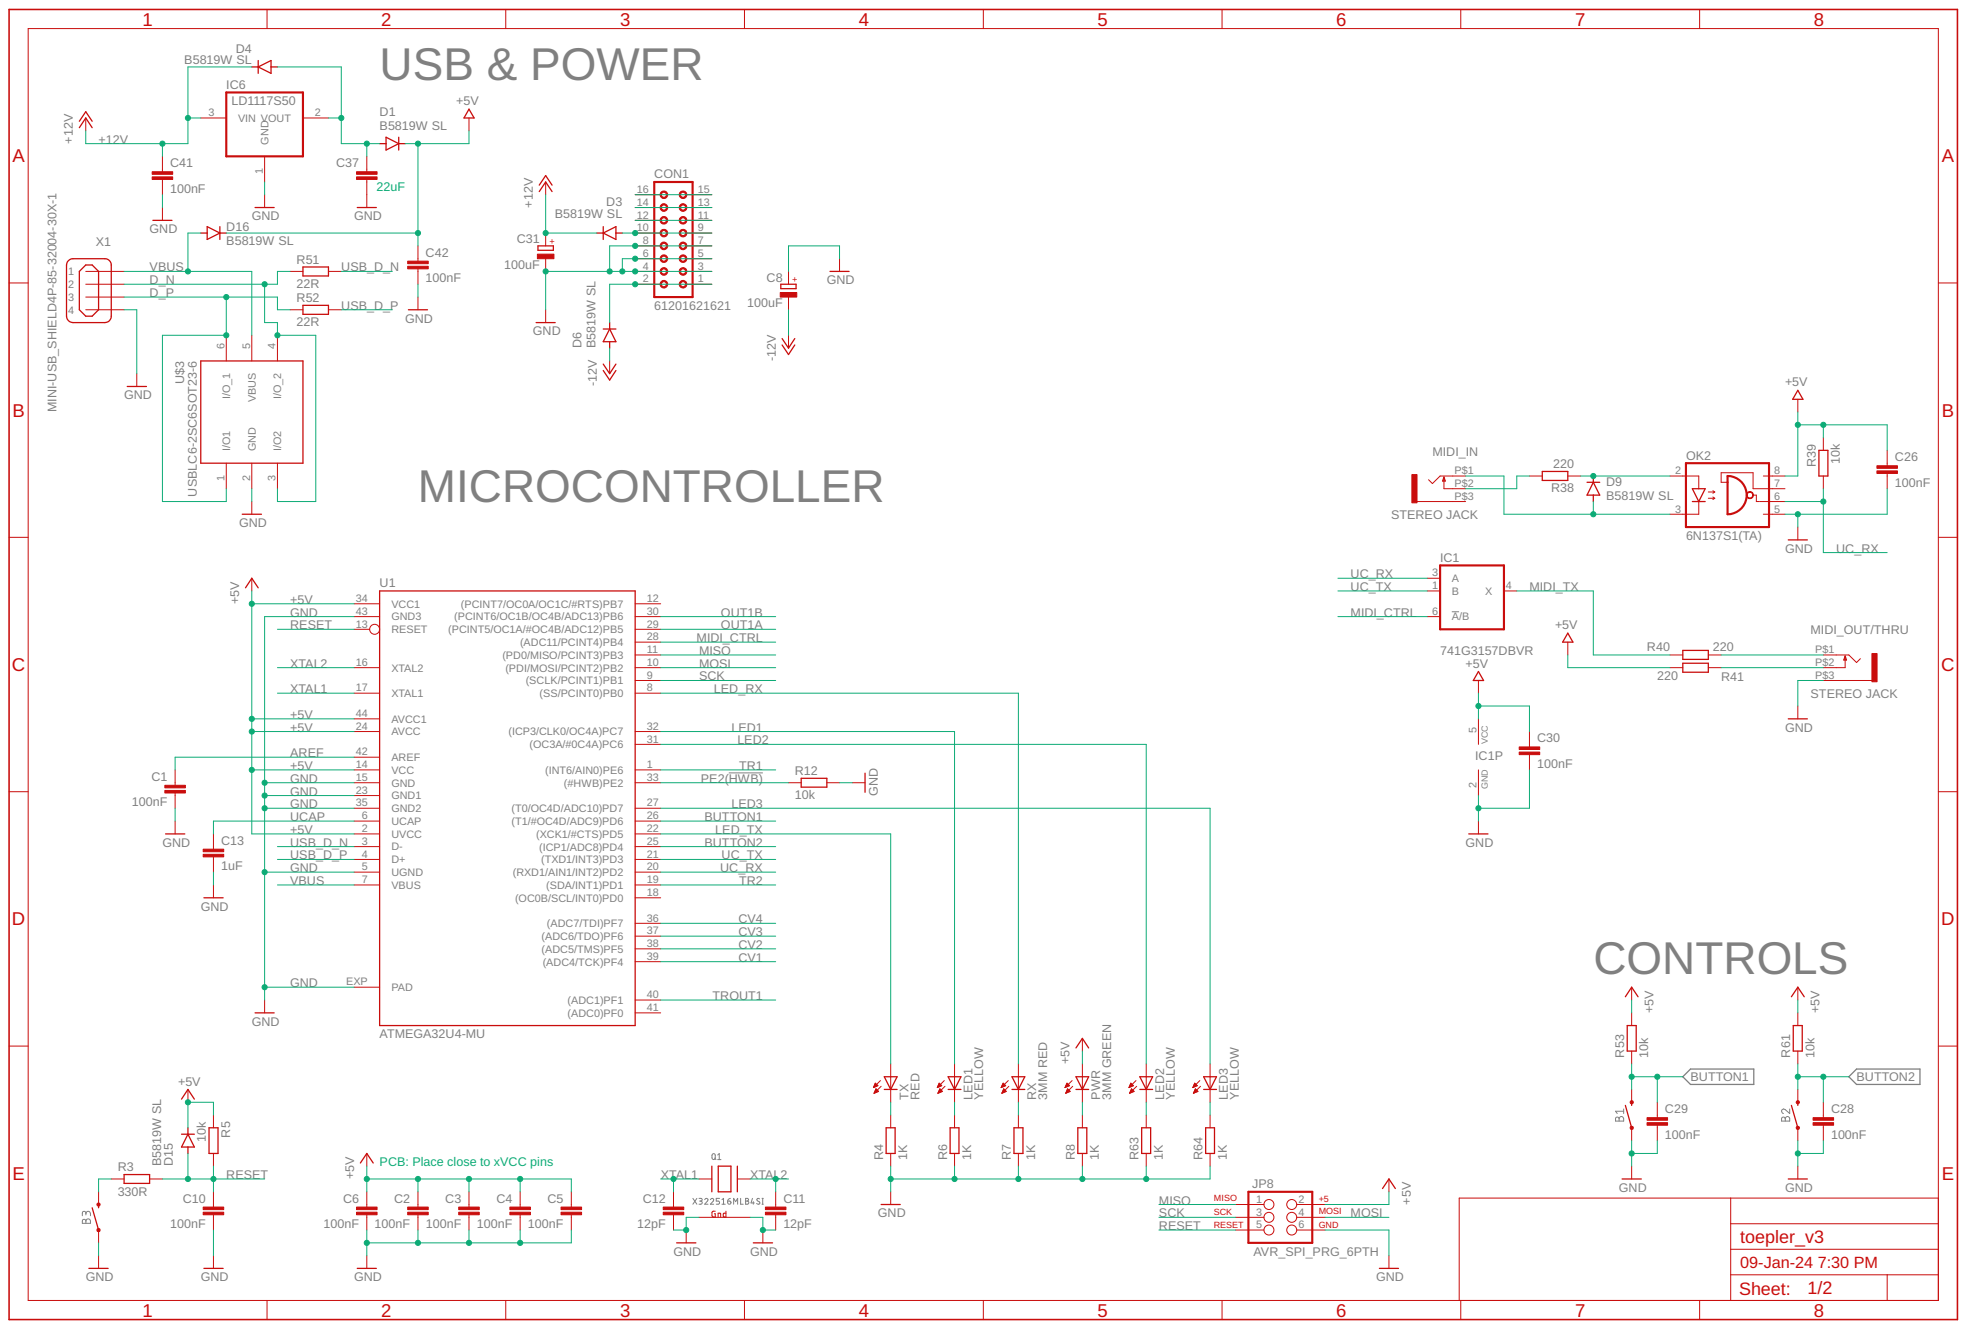
[picture p44: page 1]

GND 43 | 30
RESET 13 | 29

+5V
AREF | 31 LED2

GND GND

26 BUTTON1

+5V | 22 LED_TX
USB_D_N | 25 BUTTON2

PCB: Place close to xVCC pins

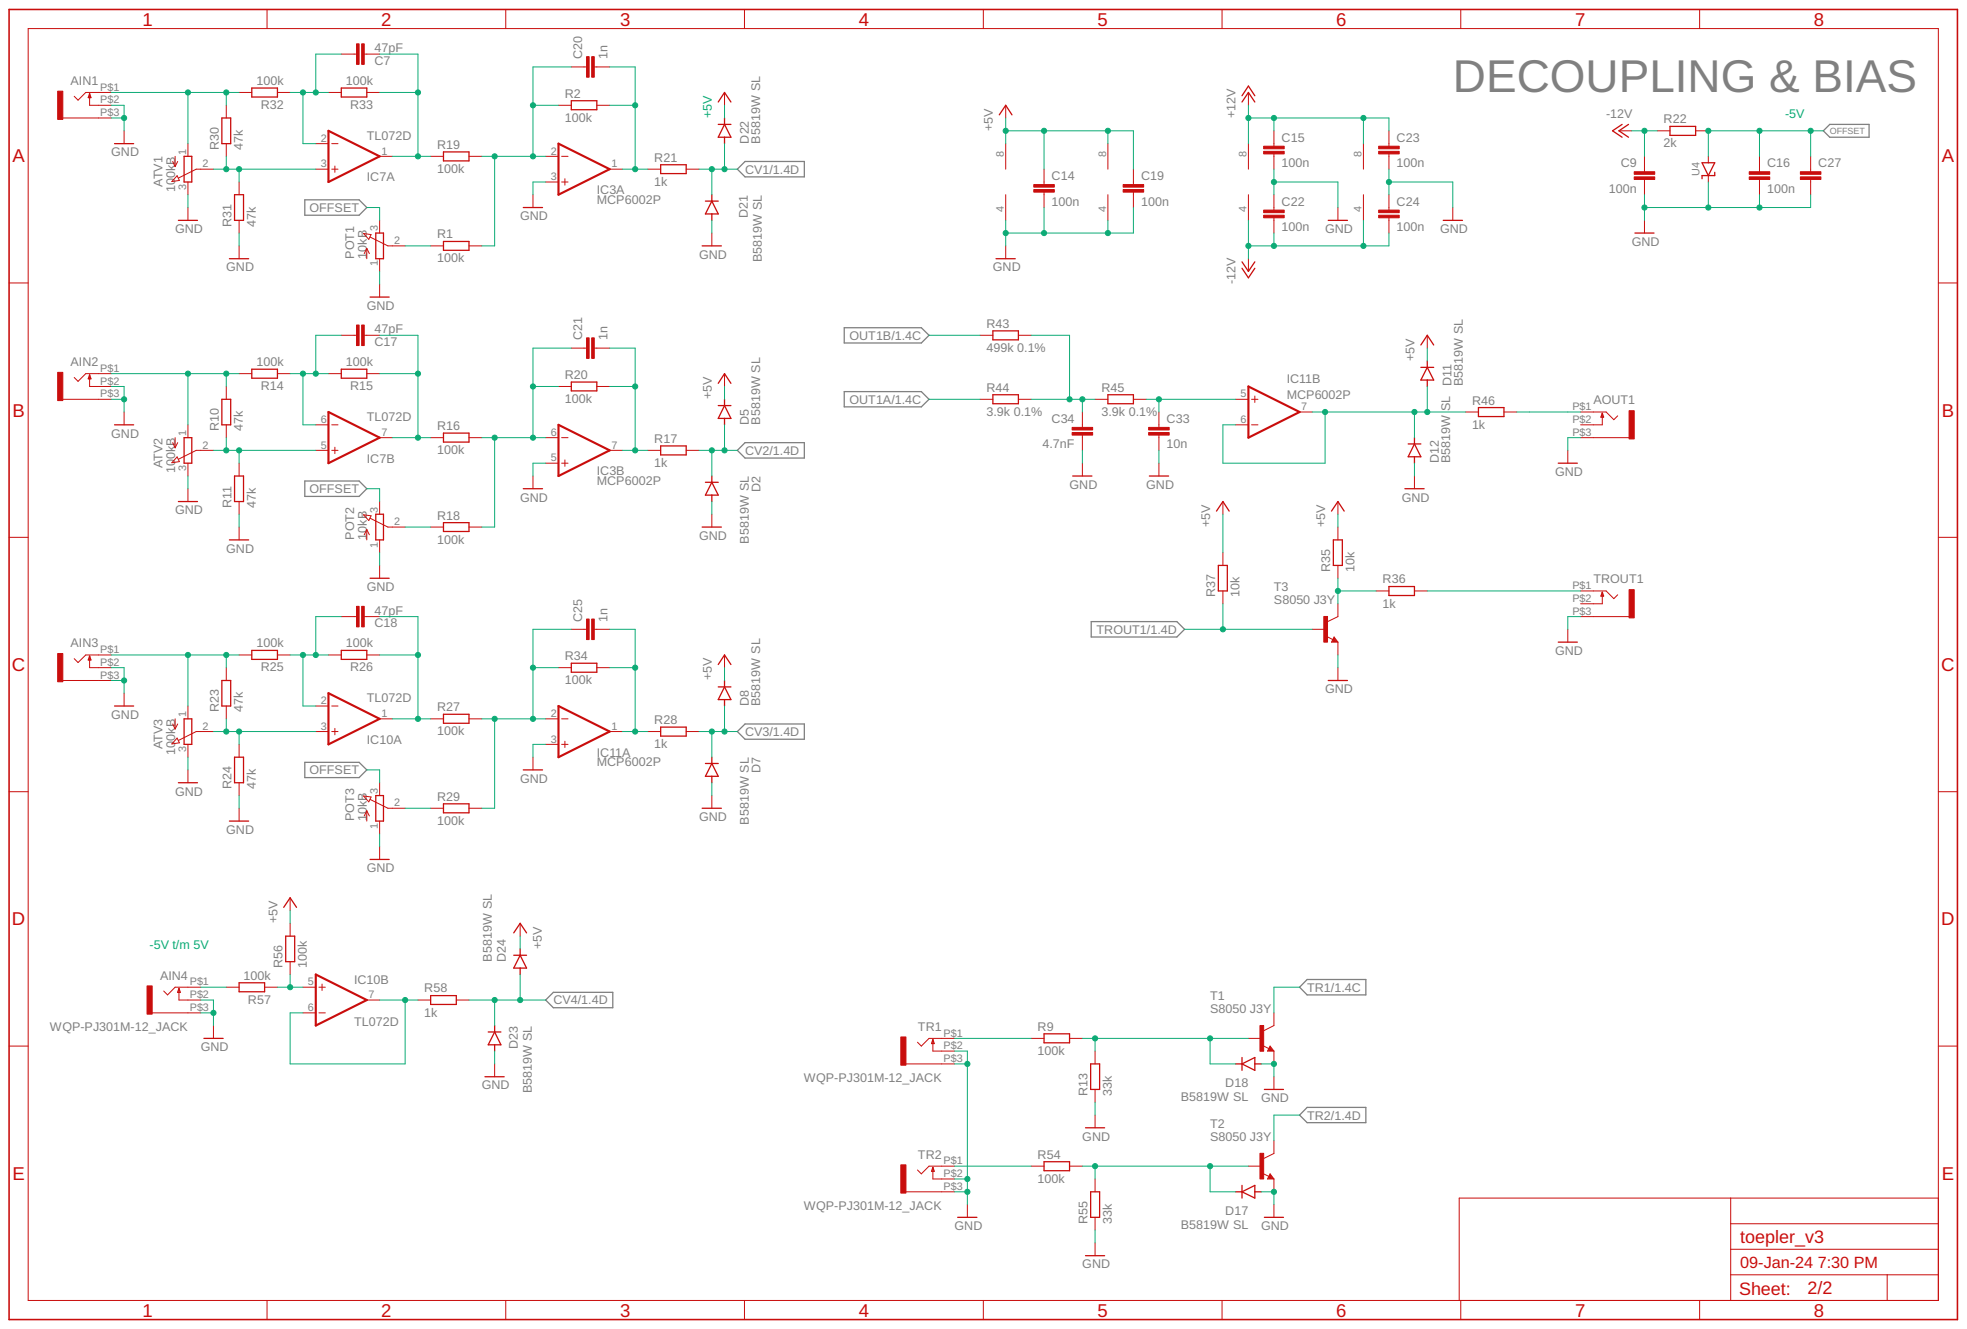
[picture p45: page 2]
