niektb/sluisbrinkie-eurorack-published/Sluisbrinkie DIVN/divn/divn.pdf

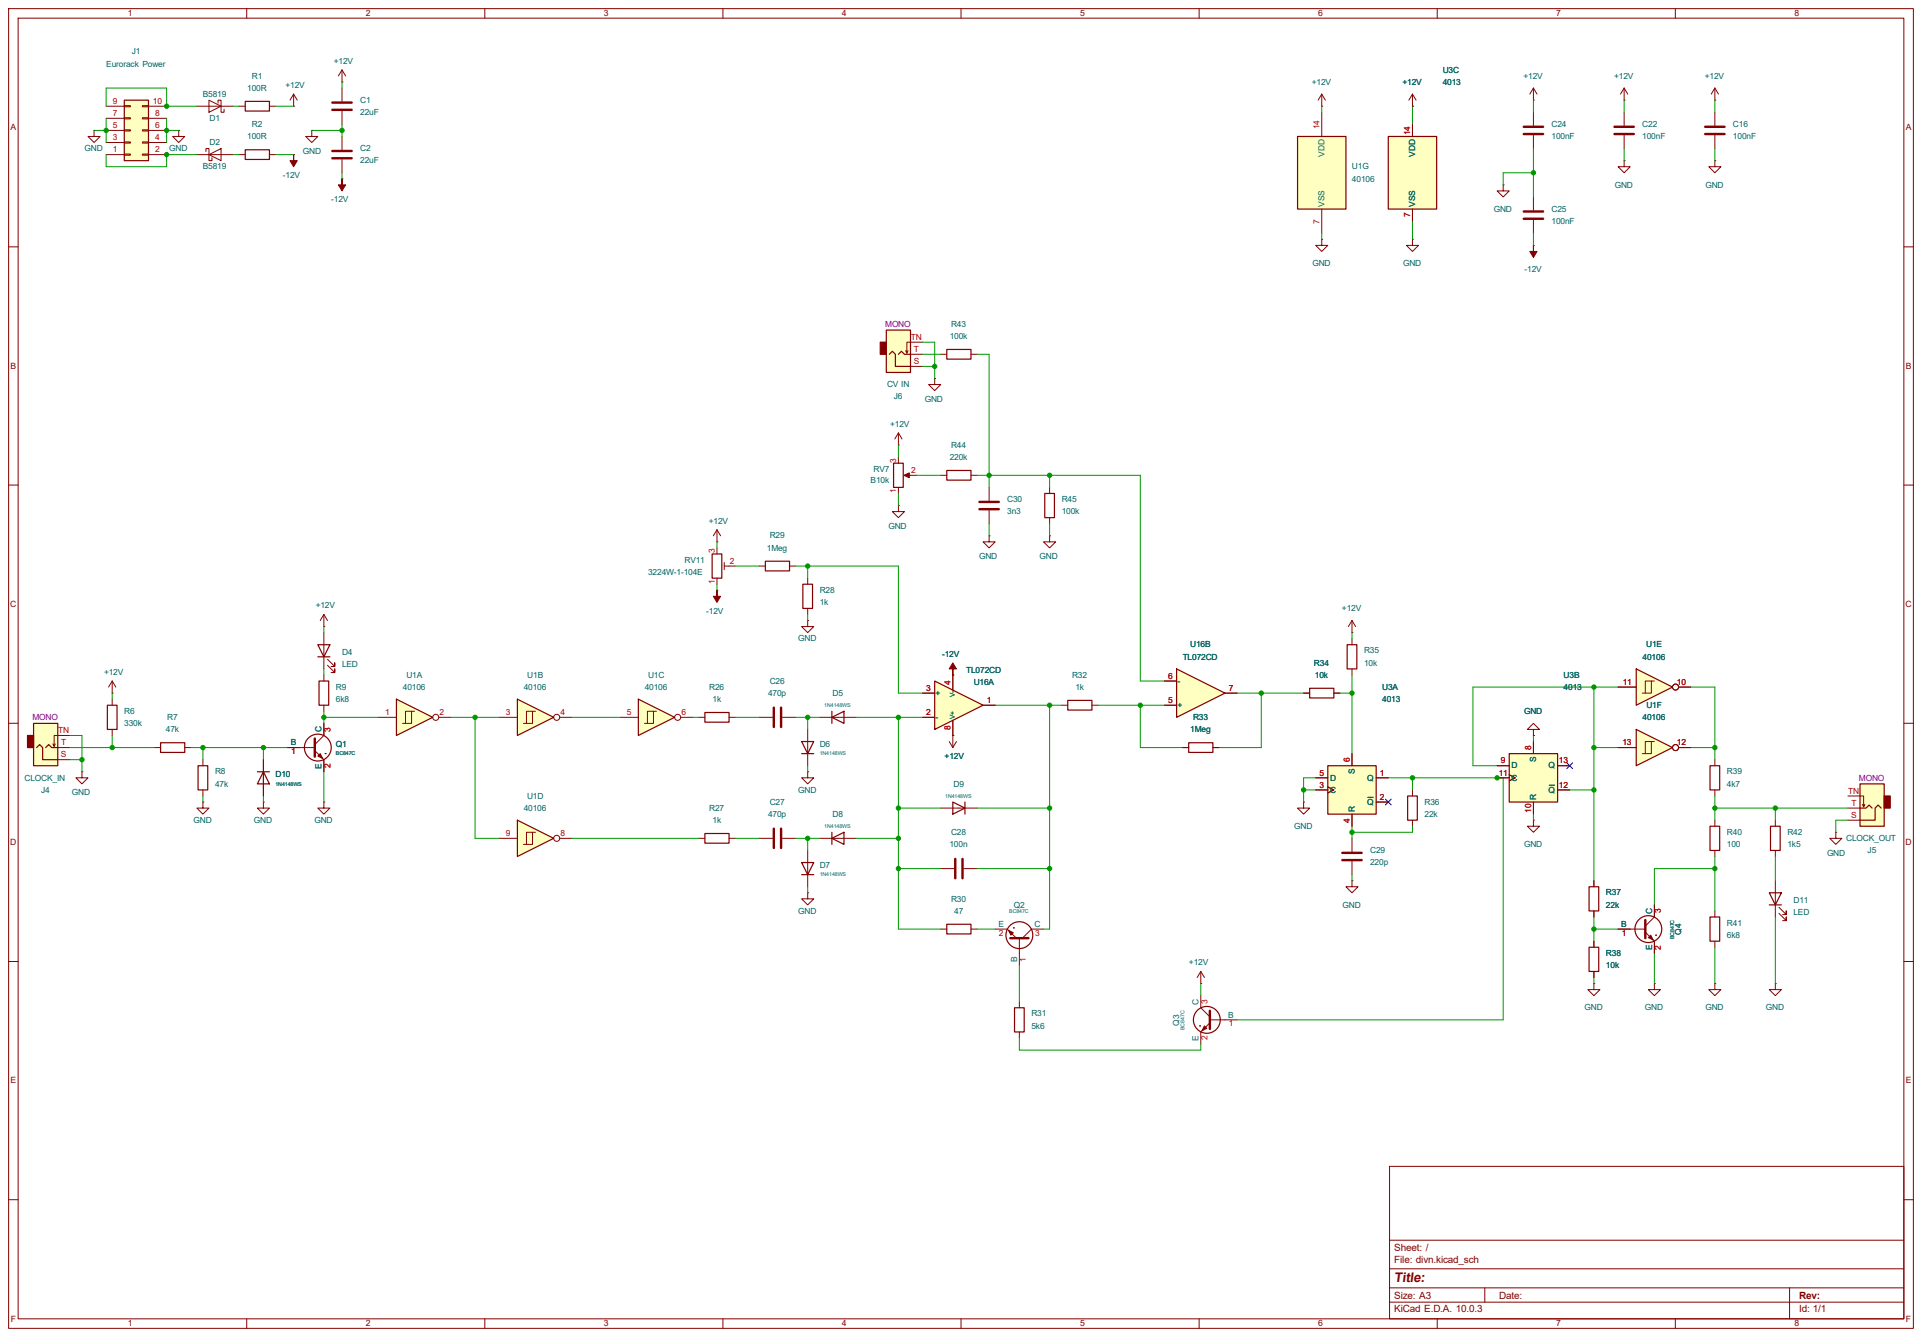
[picture p46: page 1]

Id: 1/1 Title: File: divn.kicad_sch Sheet: /
