niektb/sluisbrinkie-eurorack-published/Sluisbrinkie Müller/kicad/muller/muller.pdf

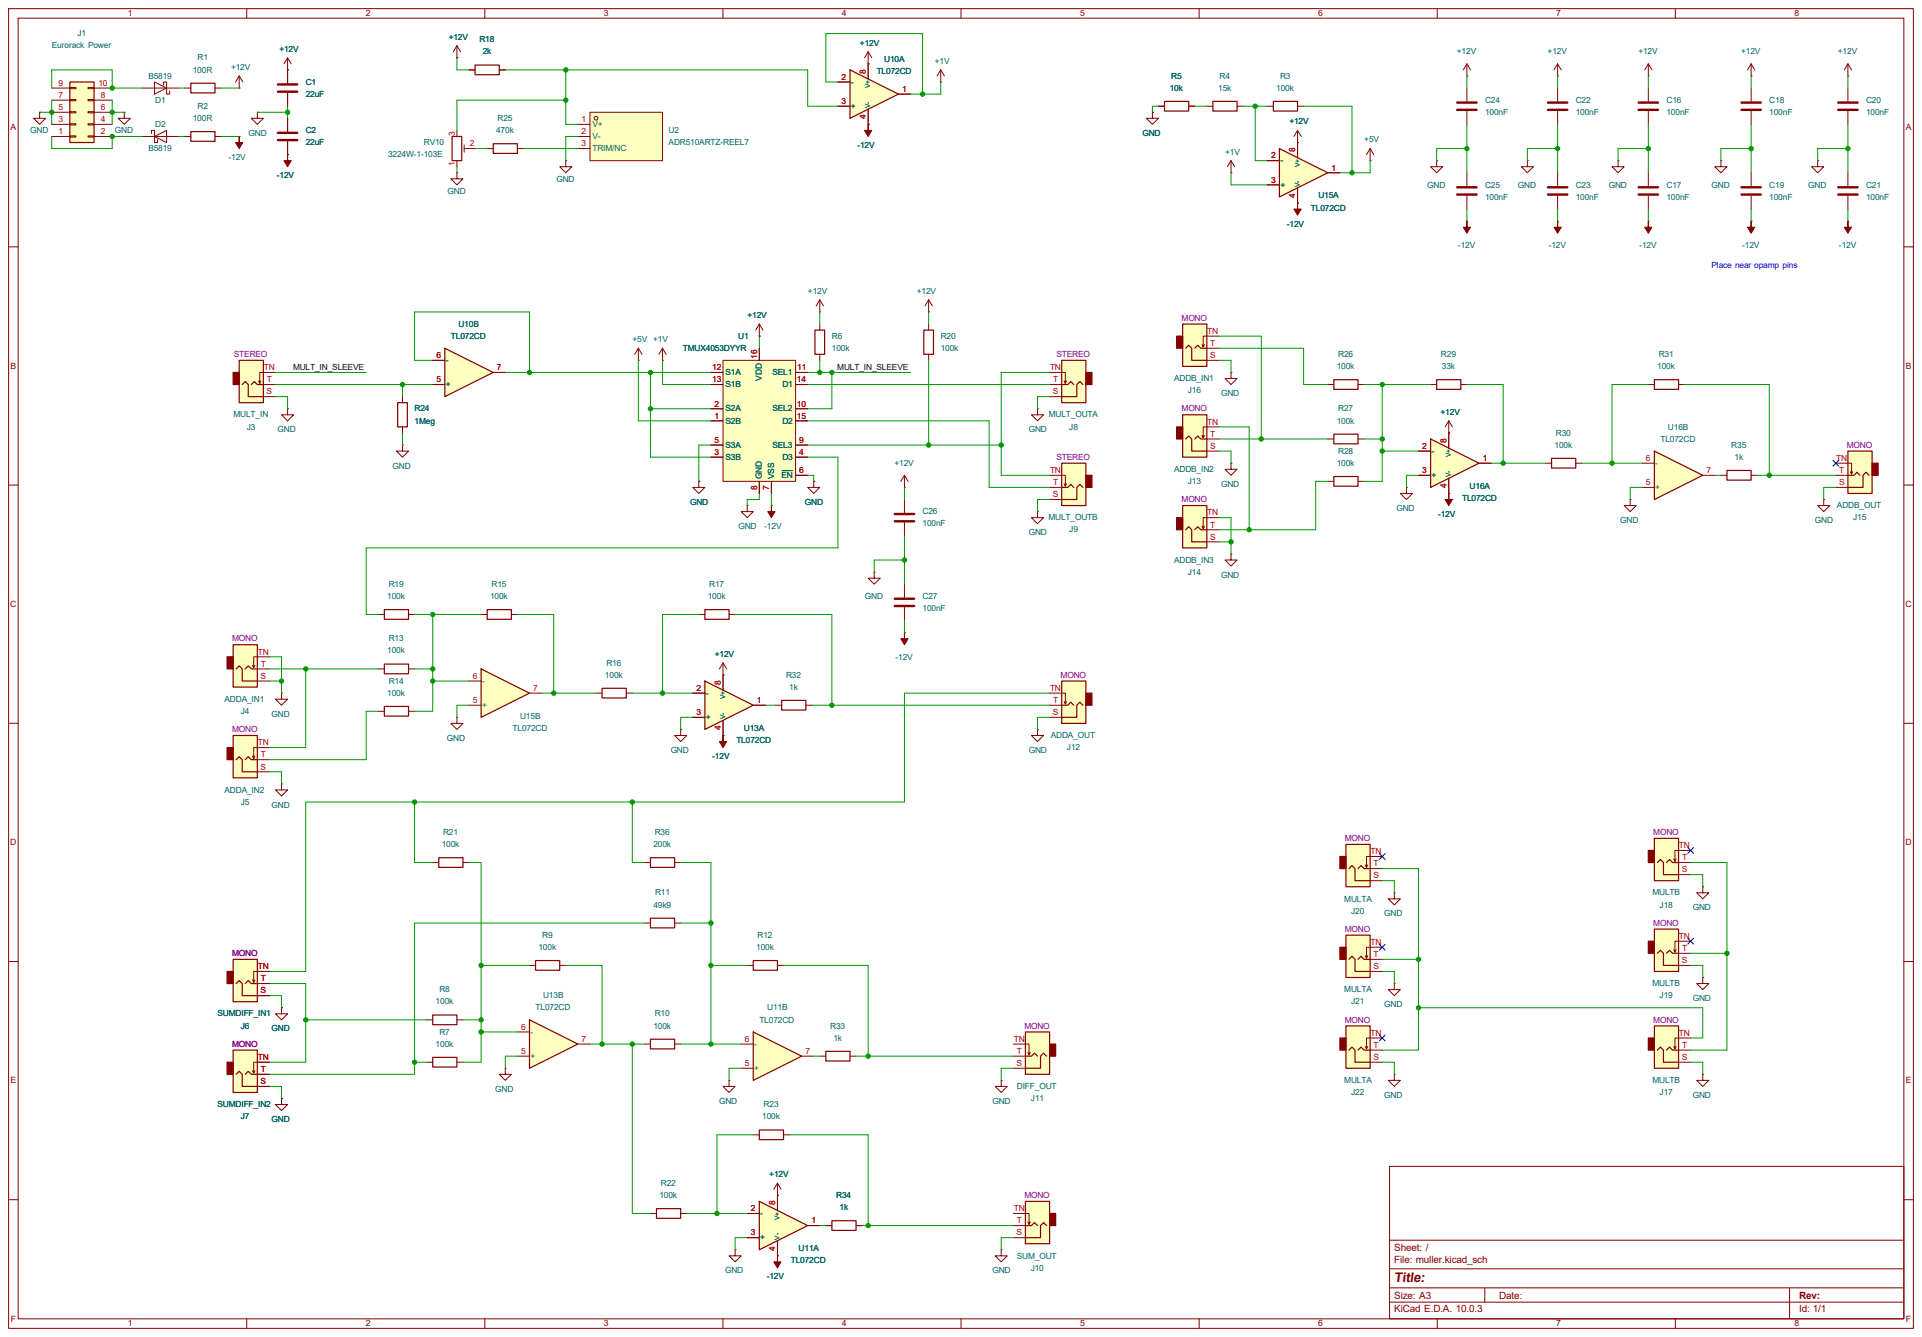
[picture p47: page 1]

Id: 1/1 Title: File: muller.kicad_sch Sheet: /
