niektb/sluisbrinkie-eurorack-published/Eurorack USB-C PD PSU/schematic.pdf

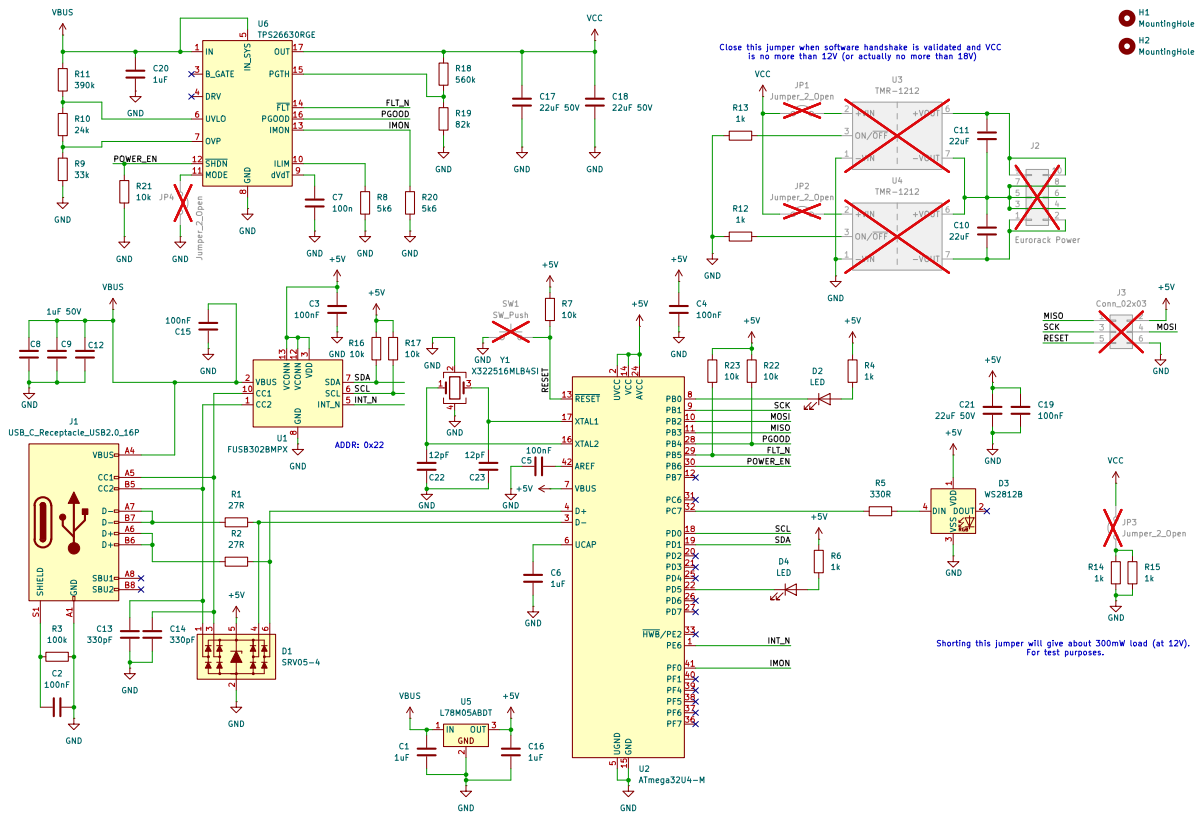
[picture p48: page 1]
