niektb/sluisbrinkie-eurorack-published/Sluisbrinkie Herford/Schematic PDF/herford.pdf

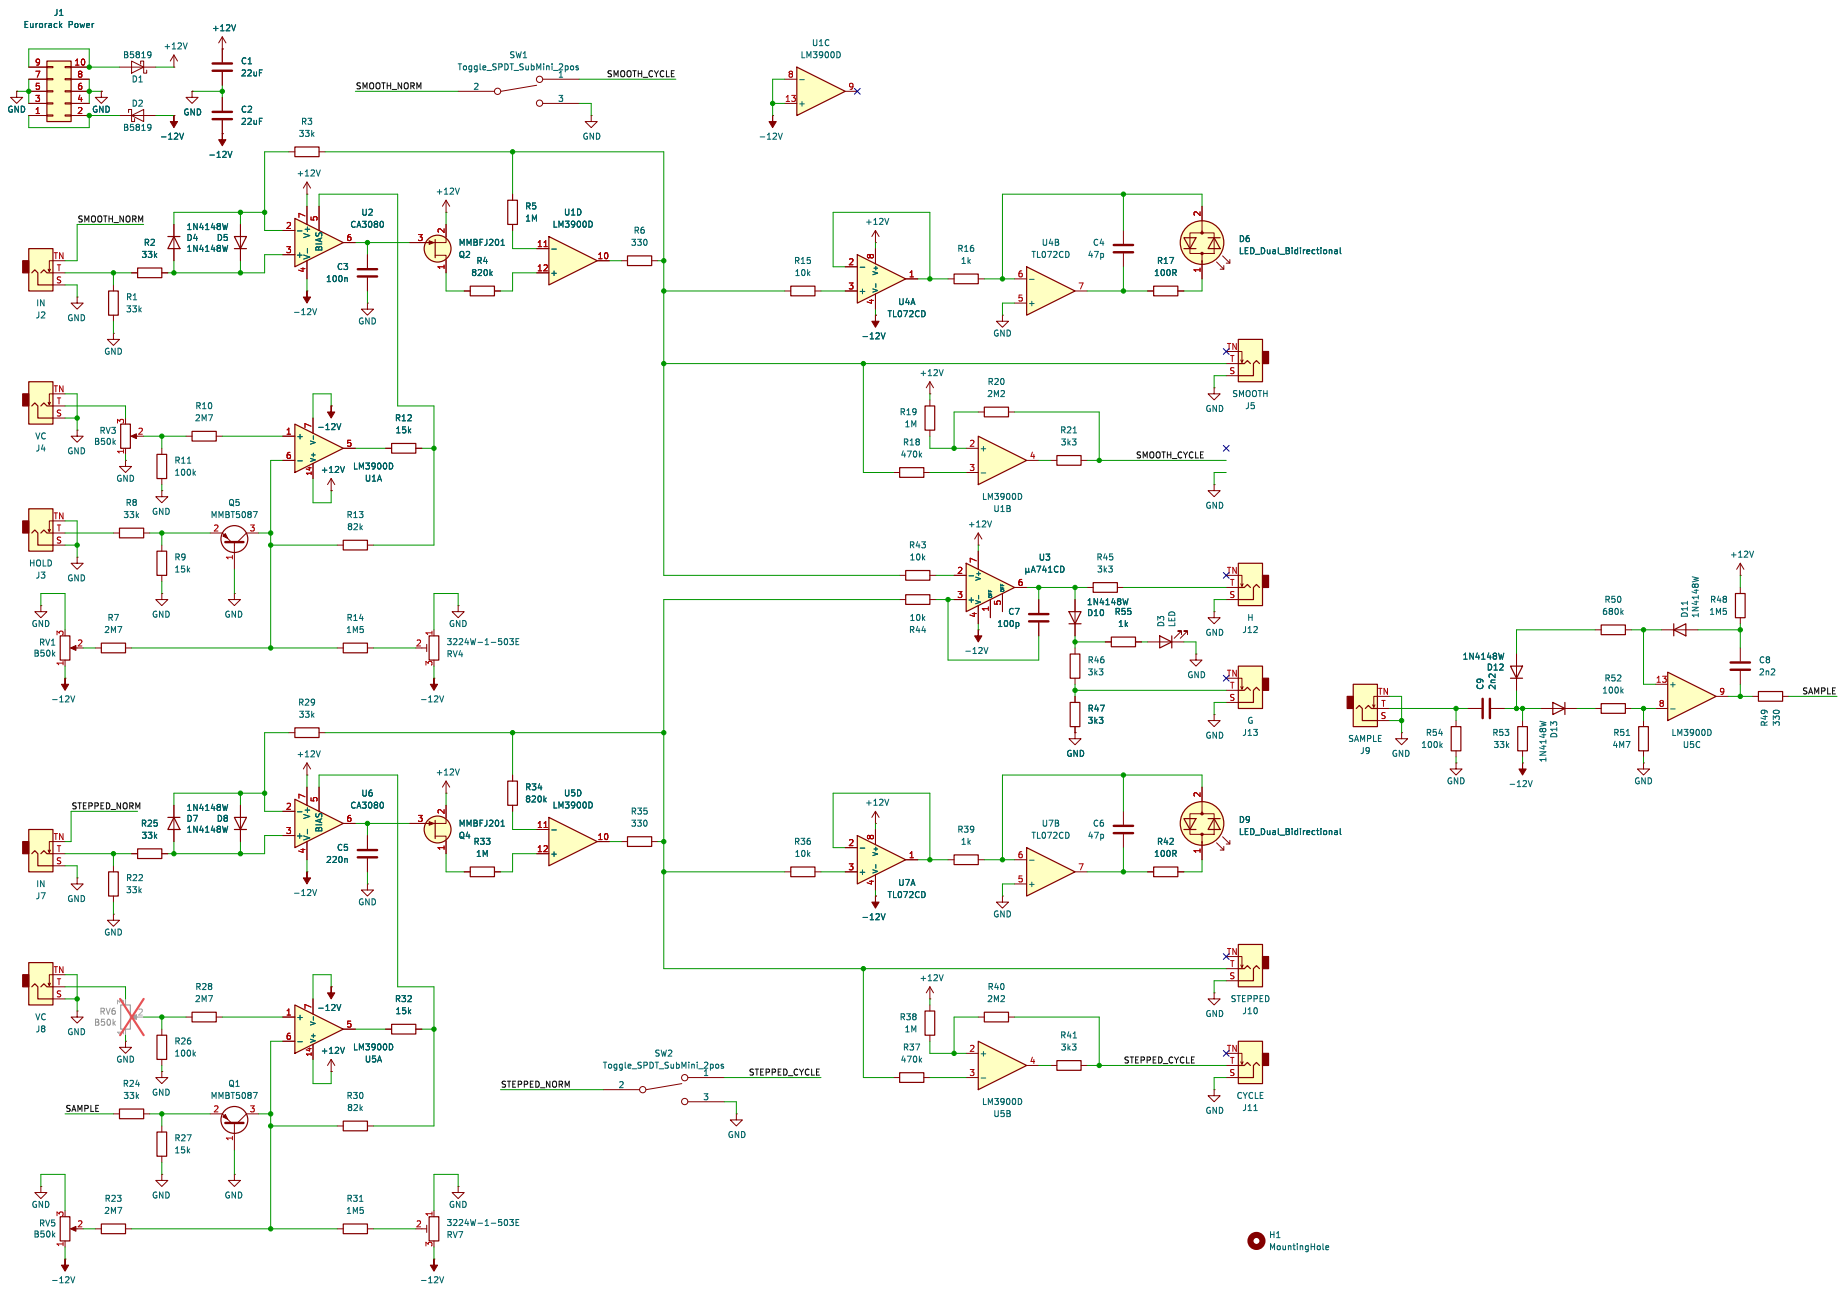
[picture p49: page 1]
