niektb/sluisbrinkie-eurorack-published/Sluisbrinkie Toepler+/Schematic PDF/toepler_plus.pdf

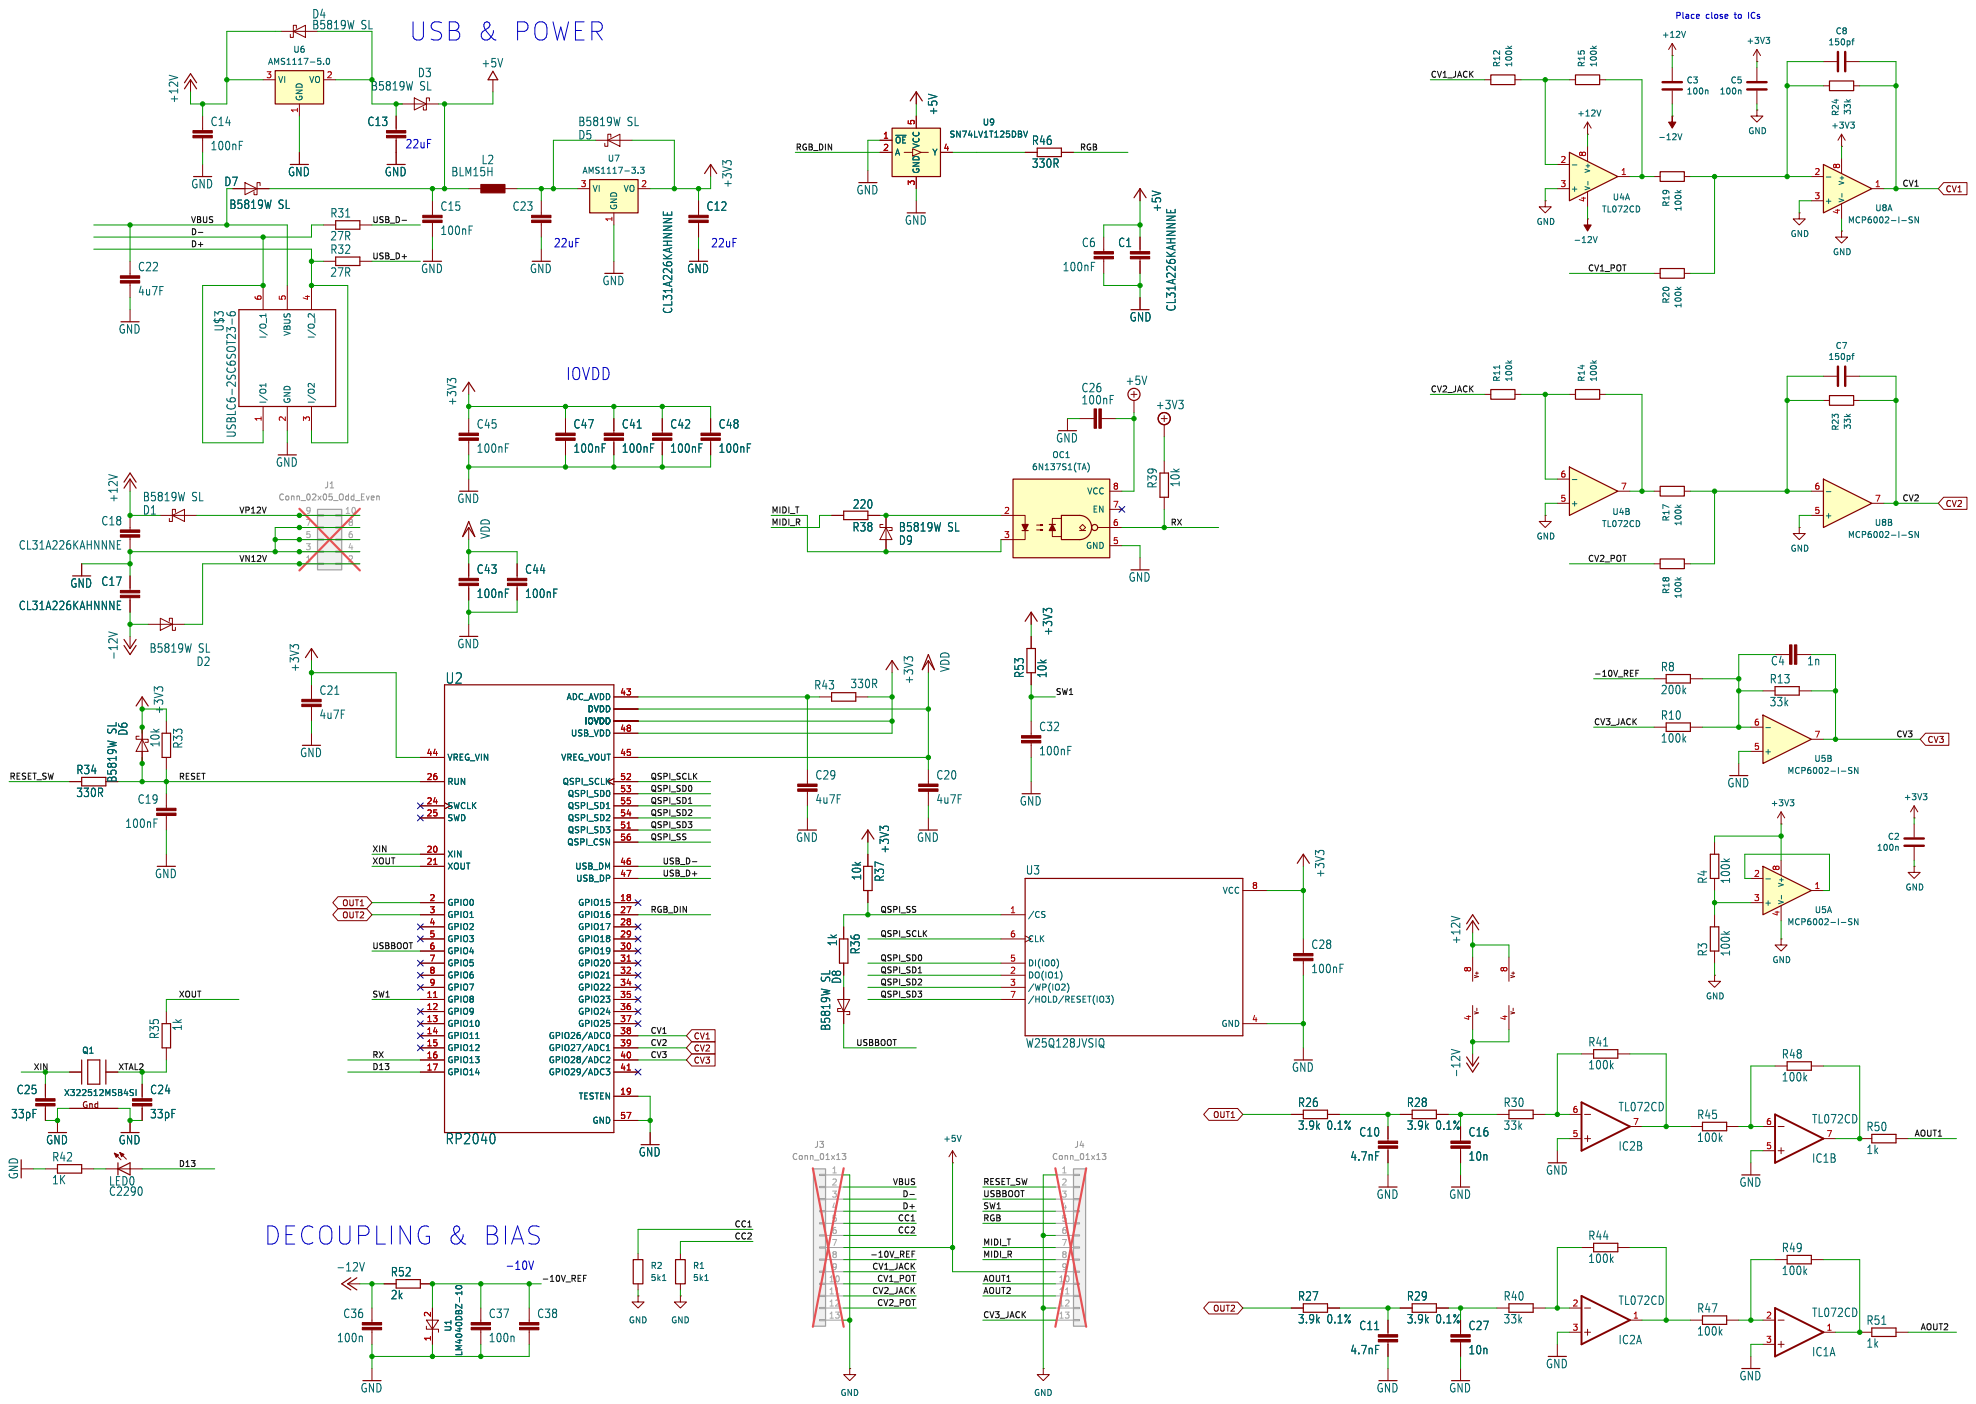
[picture p50: page 1]

Place close to ICs 22uF
