niektb/sluisbrinkie-eurorack-published/Sluisbrinkie Toepler+/Schematic PDF/toepler_plus_frontpcb.pdf

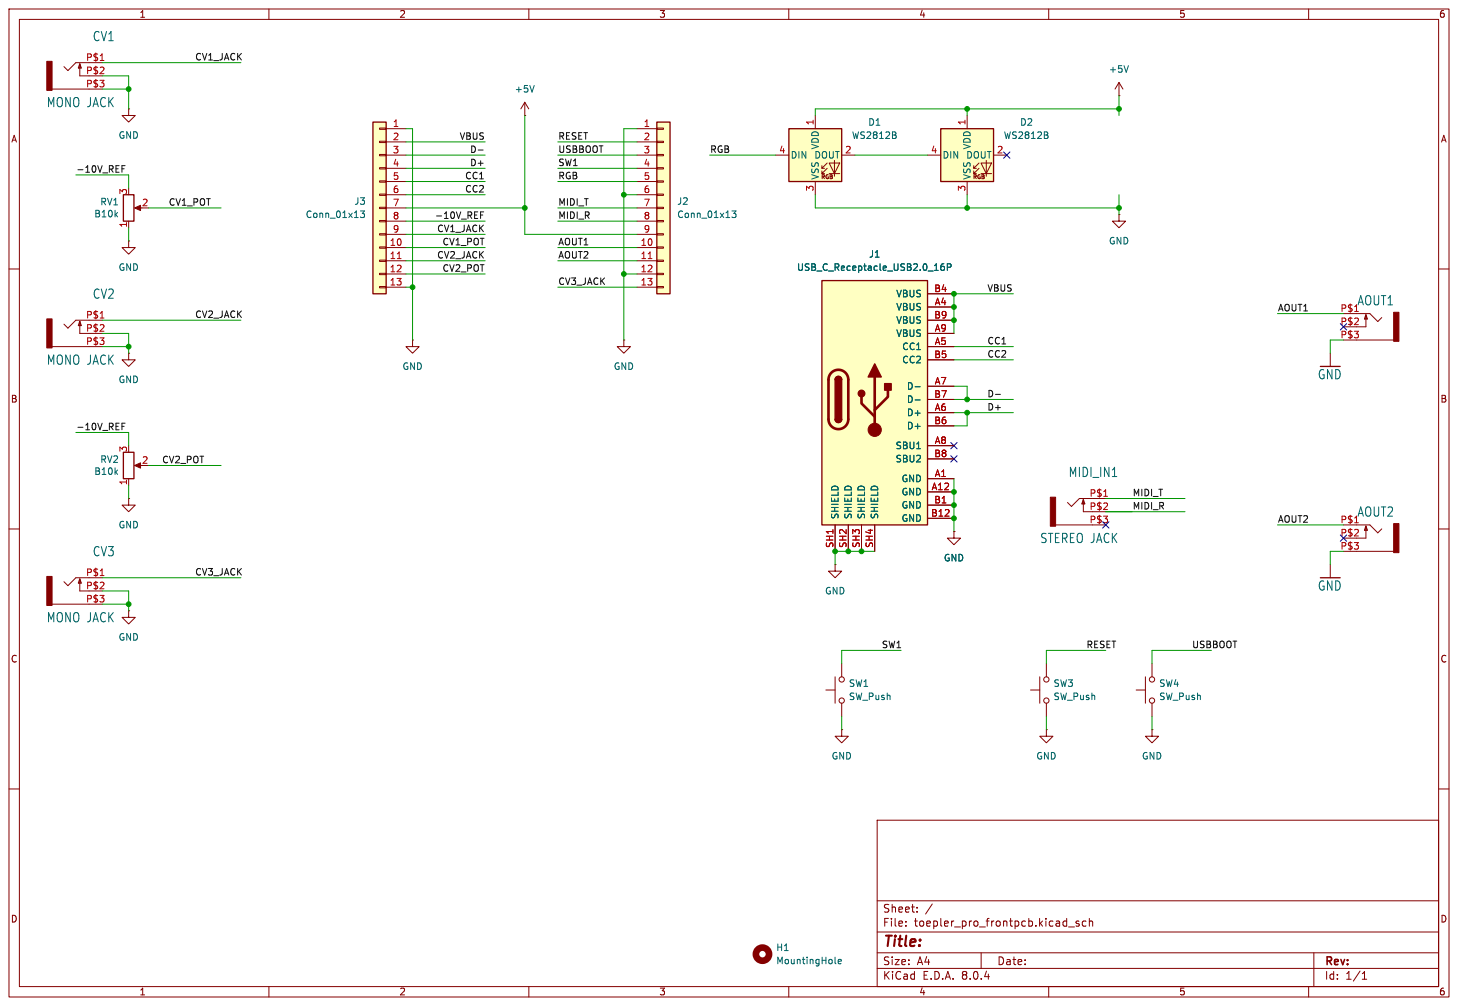
[picture p51: page 1]
