niektb/sluisbrinkie-eurorack-published/Sluisbrinkie Edison/Schematic PDF/edison.pdf

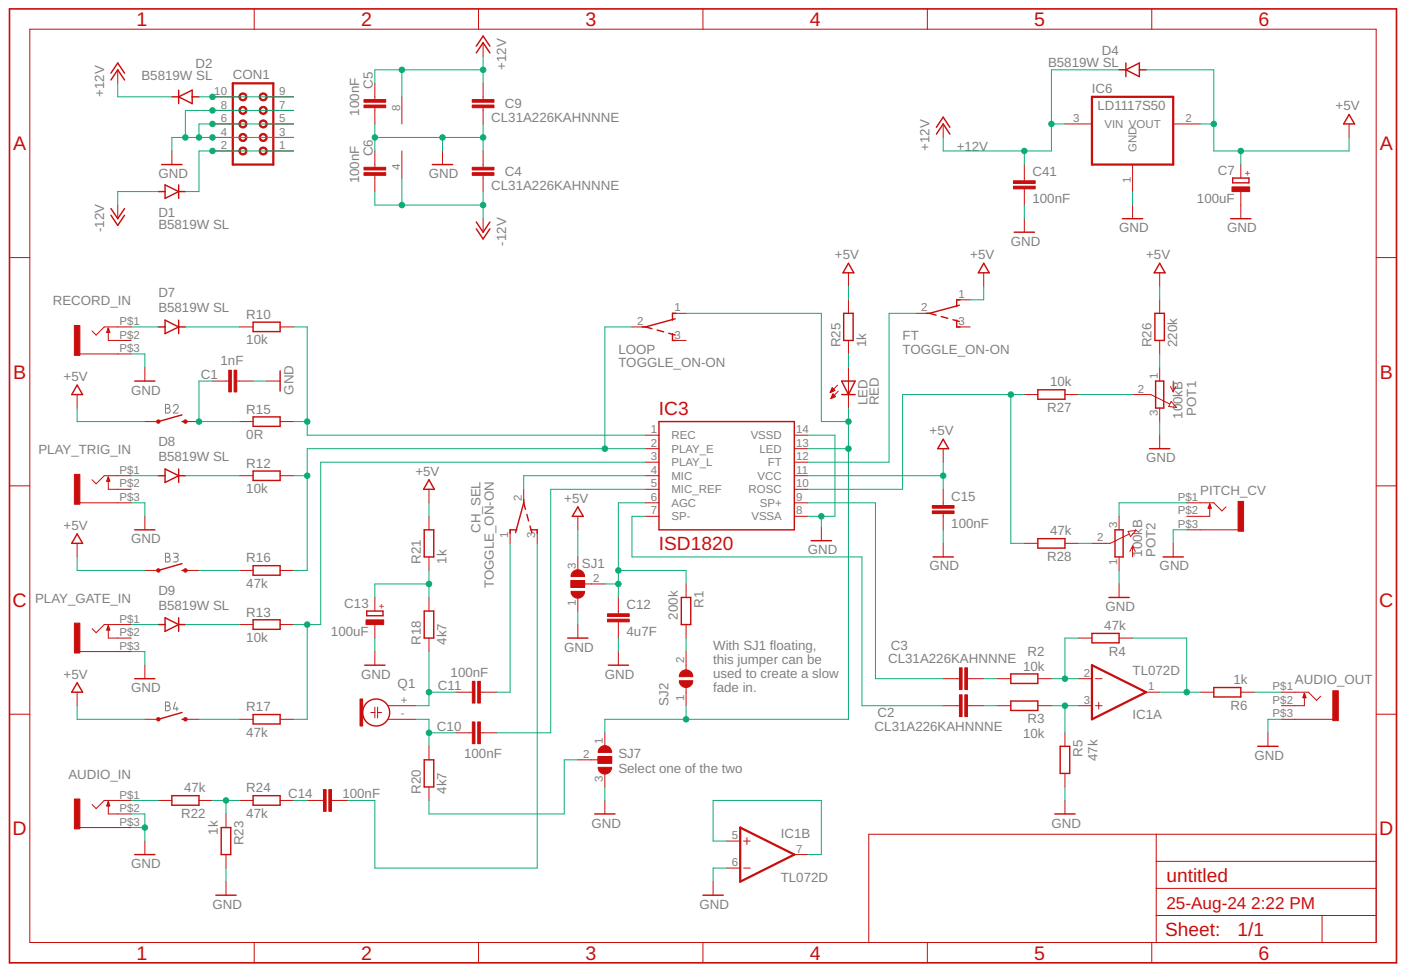
[picture p52: page 1]

With SJ1 floating,
this jumper can be
used to create a slow
fade in.

Select one of the two
