niektb/sluisbrinkie-eurorack-published/Sluisbrinkie Faraday/Schematic PDF/faraday.pdf

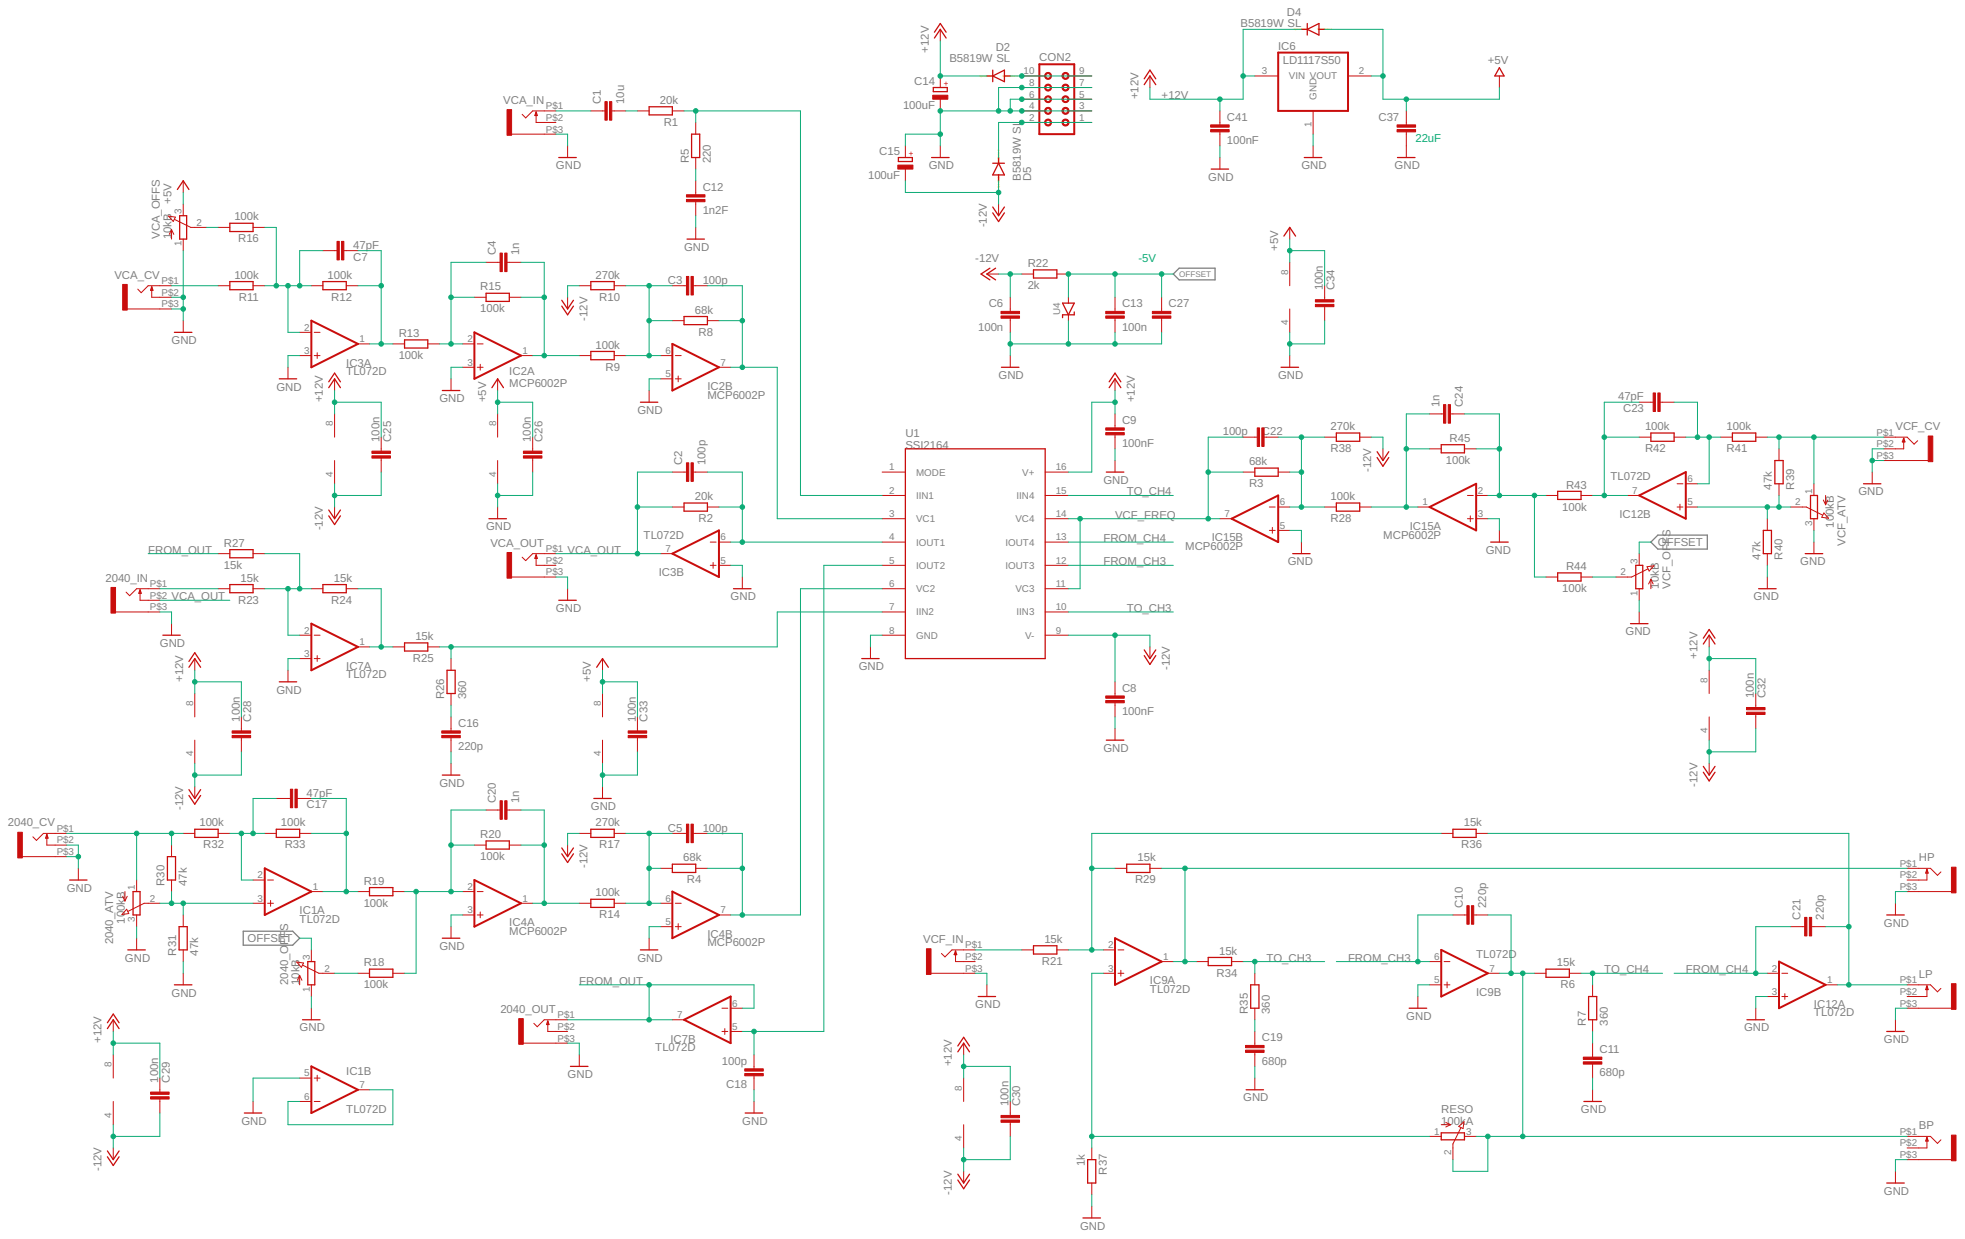
[picture p53: page 1]
