niektb/sluisbrinkie-eurorack-published/Sluisbrinkie Oppitz/Schematic PDF/oppitz.pdf

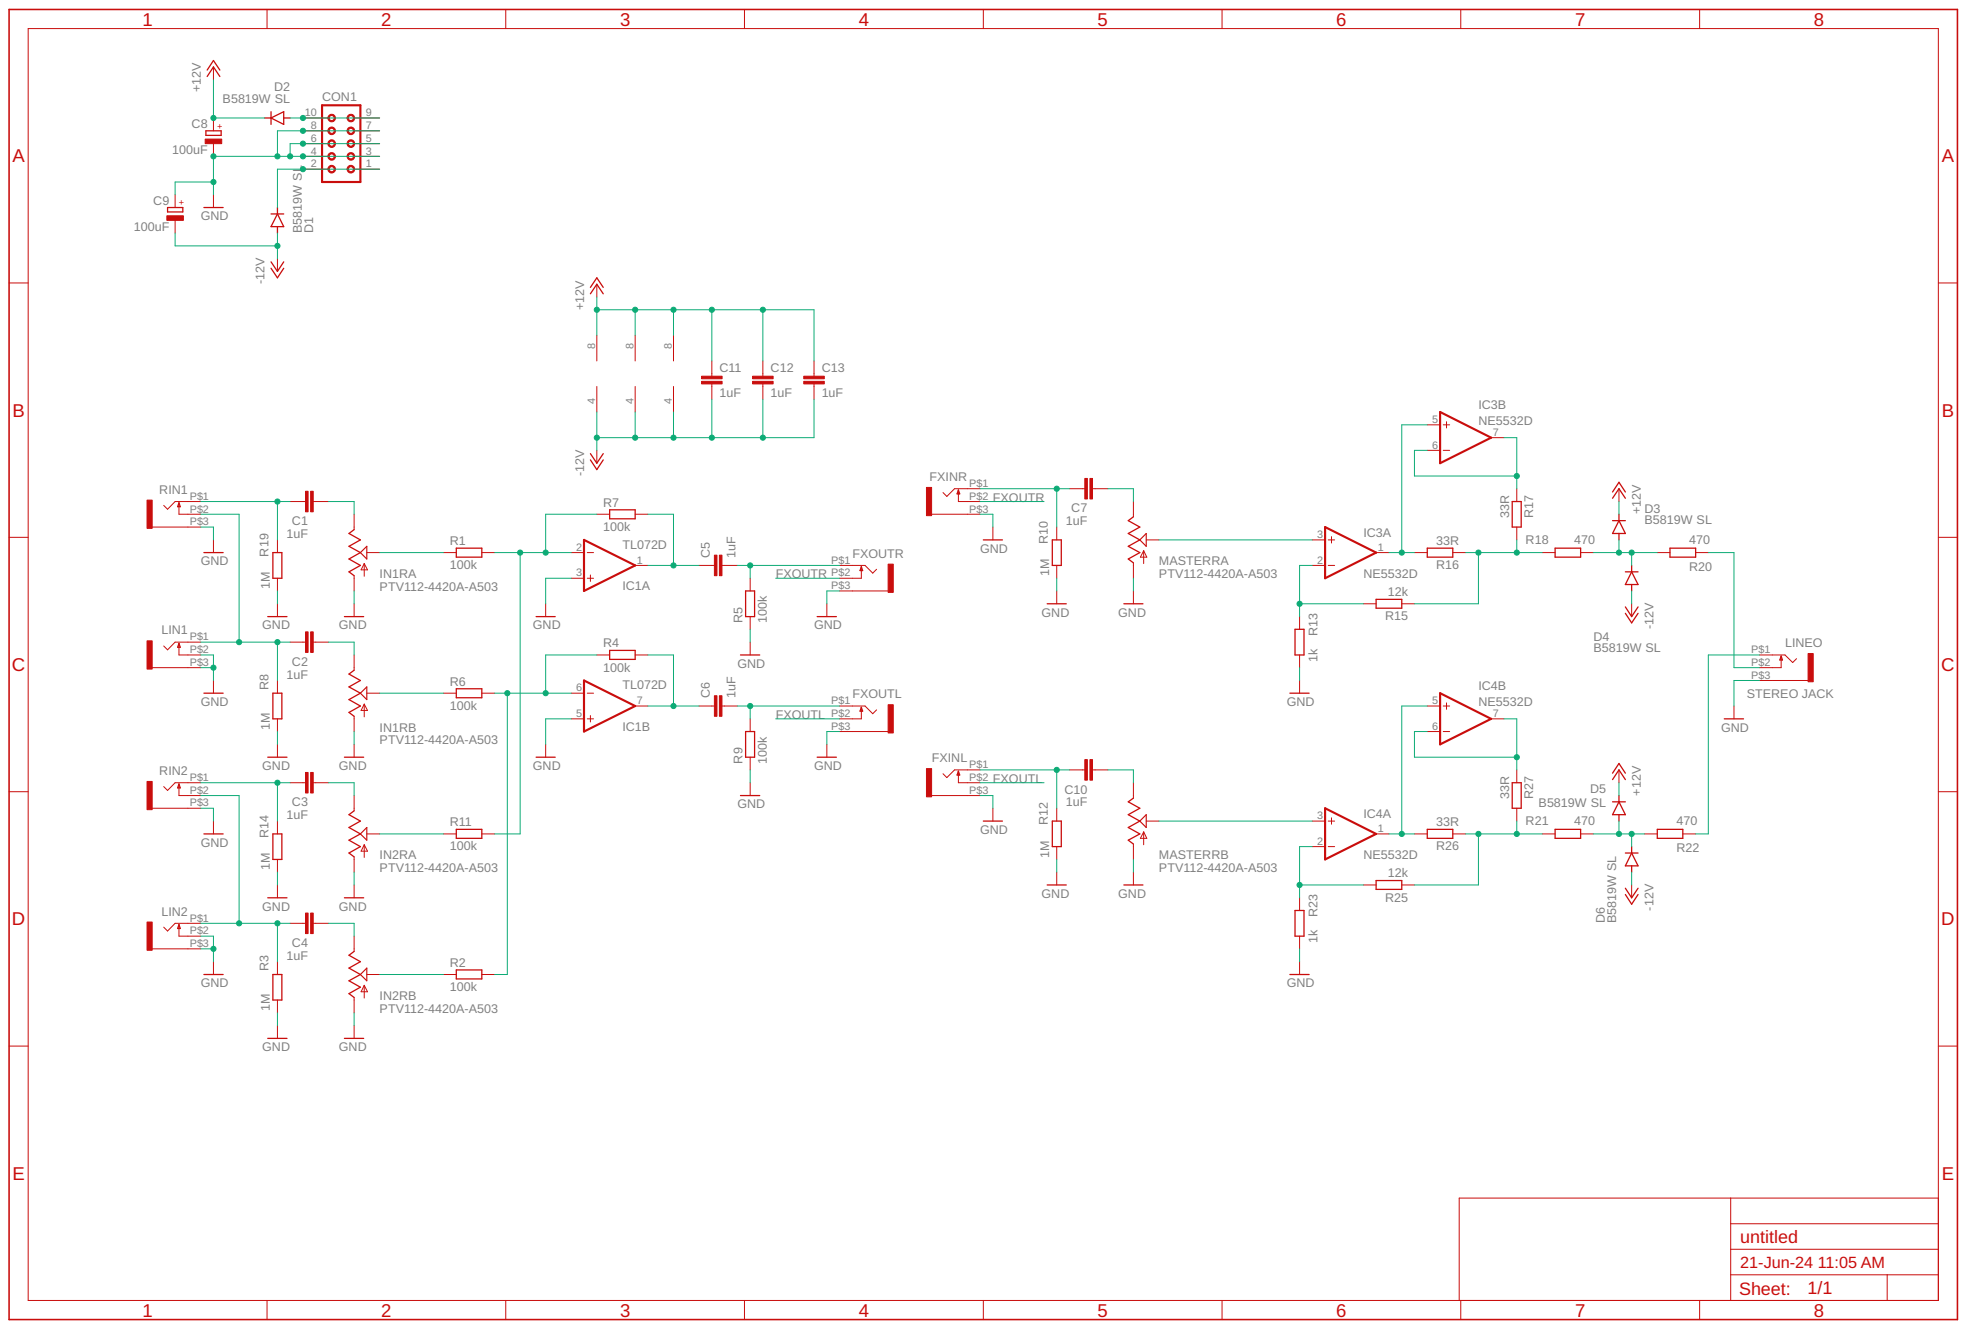
[picture p54: page 1]
