niektb/sluisbrinkie-eurorack-published/Sluisbrinkie Oppitz Mini/Schematic PDF/oppitz_mini.pdf

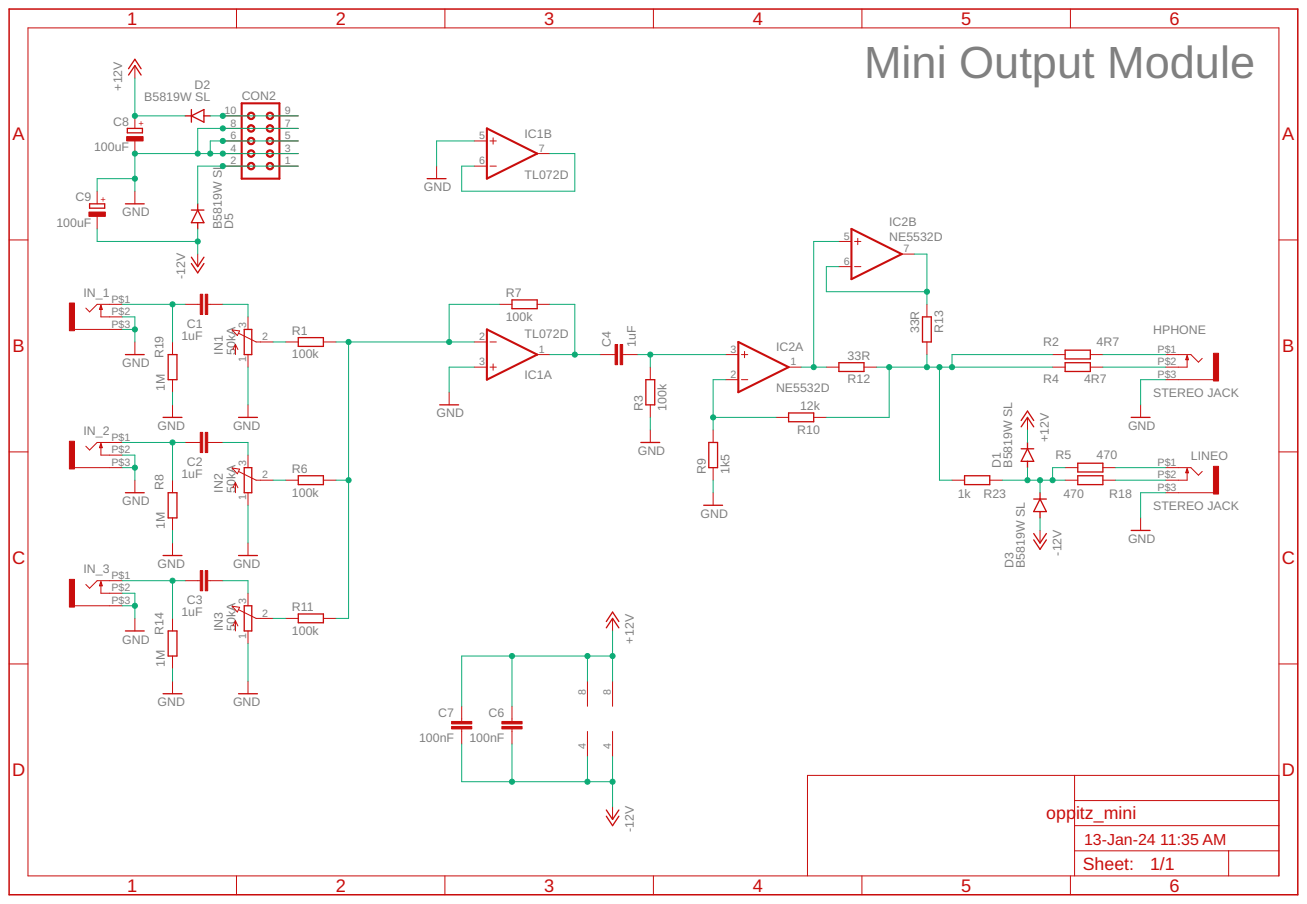
[picture p55: page 1]
