niektb/sluisbrinkie-eurorack-published/Sluisbrinkie Kepler/Schematic PDF/kastle.pdf

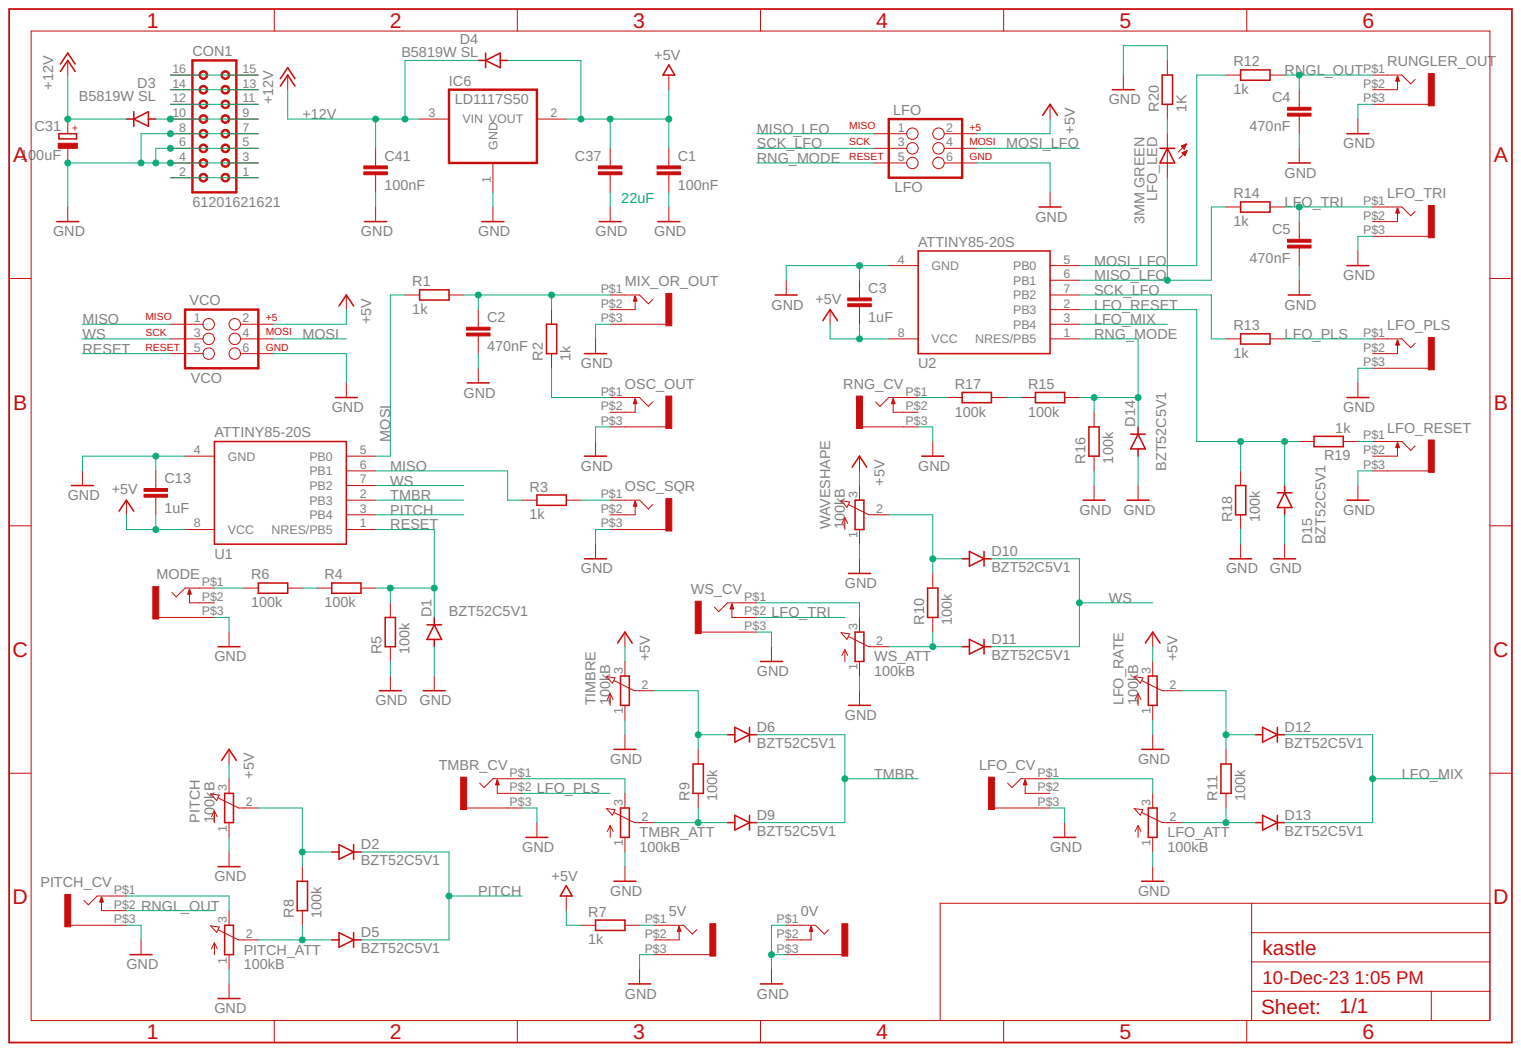
[picture p56: page 1]
