niektb/sluisbrinkie-eurorack-published/Mutable Meta Module/Hardware/Schematic PDF/MMM_main.pdf

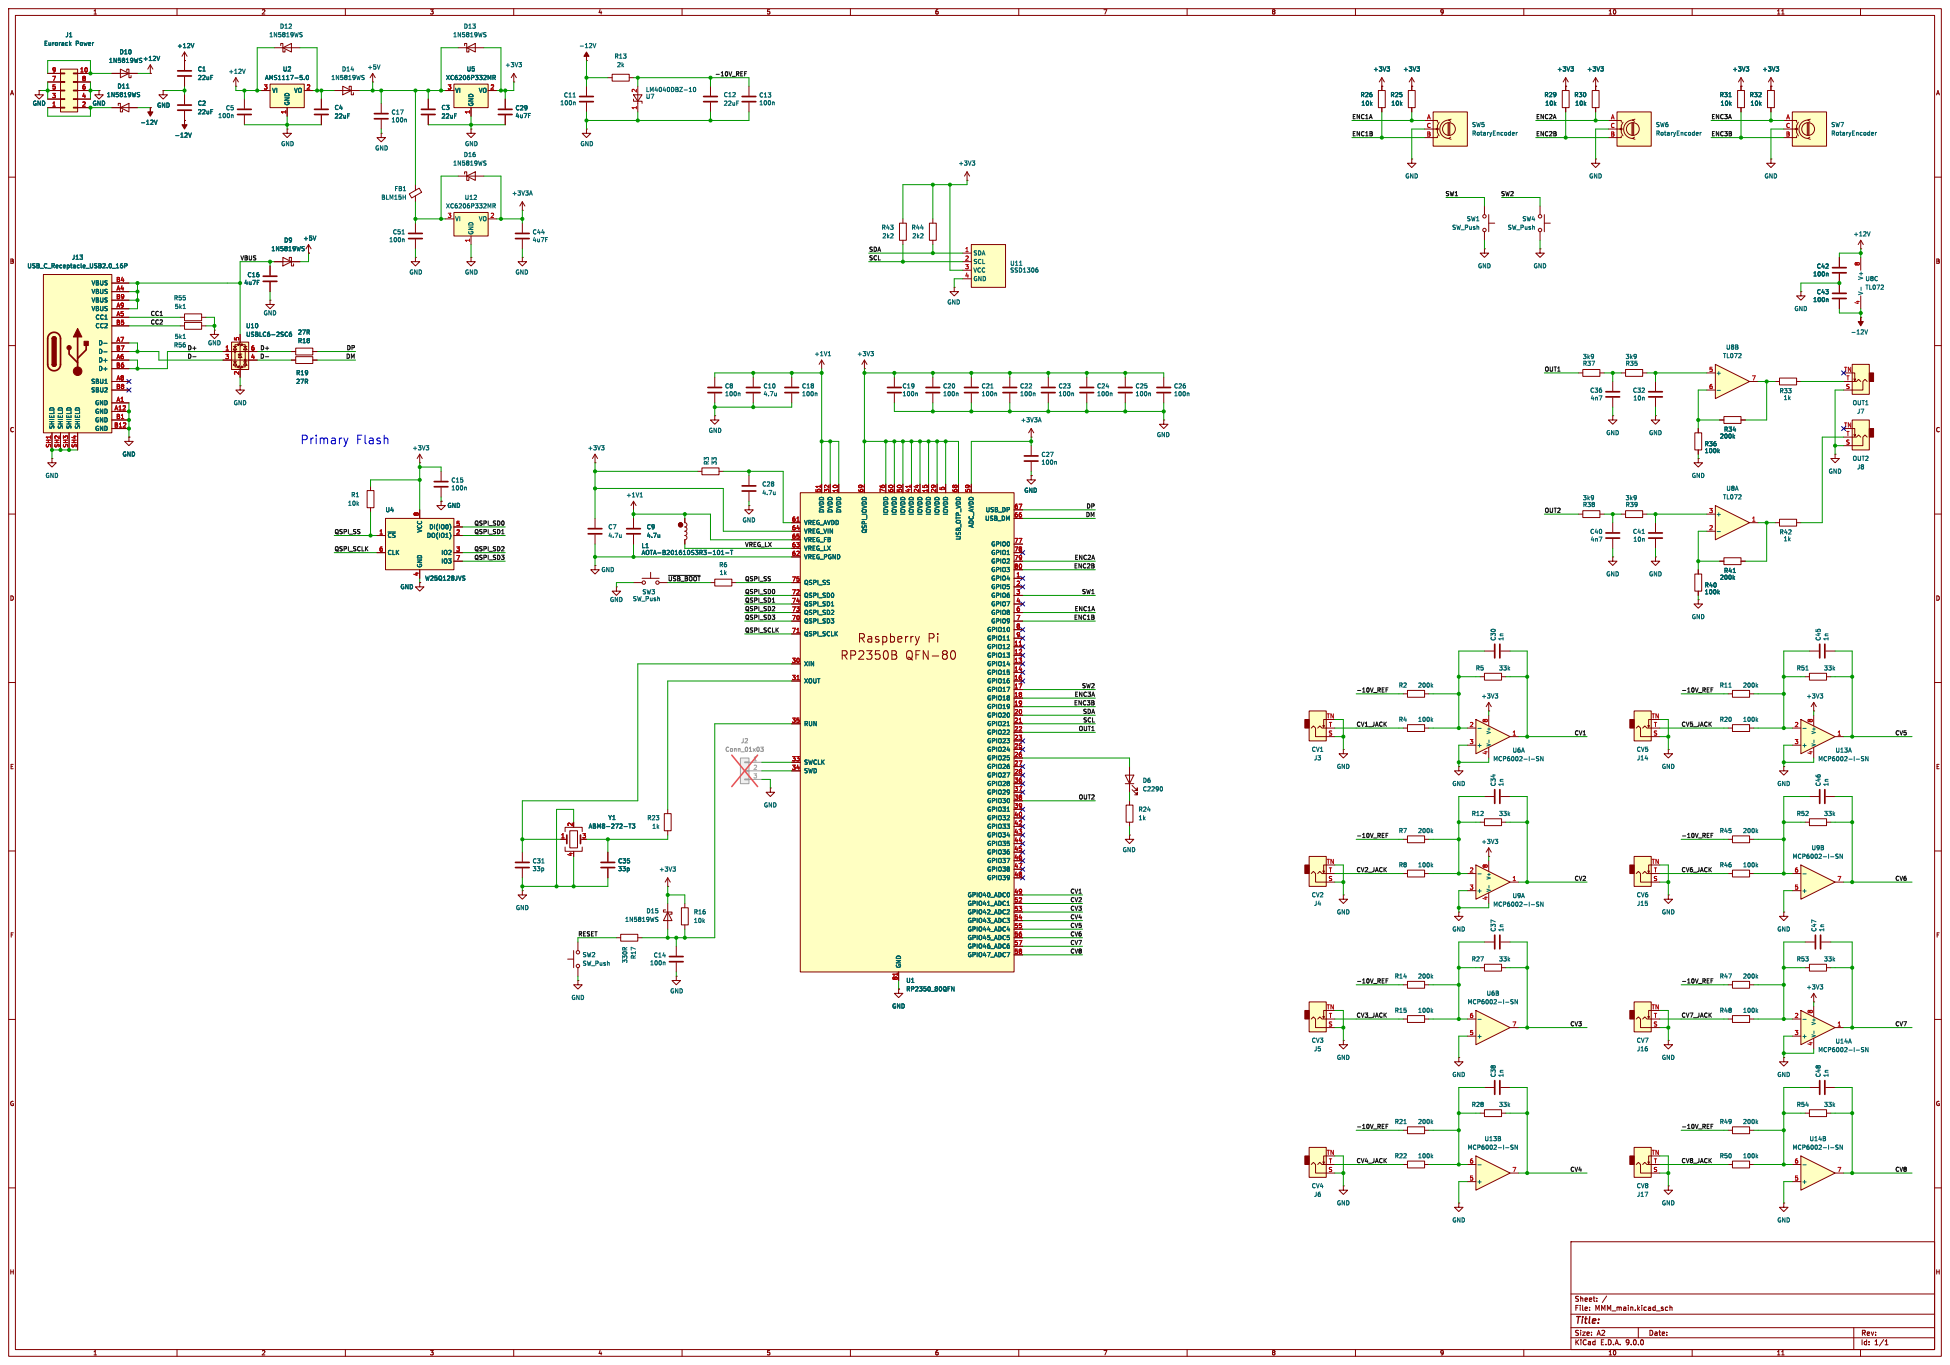
[picture p57: page 1]
