niektb/sluisbrinkie-eurorack-published/Sluisbrinkie Toepler+/Software/CircuitPython/Firmware/Config/mpconfigboard.h

// This file is part of the CircuitPython project: https://circuitpython.org
//
// SPDX-FileCopyrightText: Copyright (c) 2021 Scott Shawcroft for Adafruit Industries
//
// SPDX-License-Identifier: MIT

#pragma once

#define MICROPY_HW_BOARD_NAME "Toepler Plus"
#define MICROPY_HW_MCU_NAME "rp2040"

#define MICROPY_HW_LED_STATUS (&pin_GPIO14)
#define MICROPY_HW_NEOPIXEL (&pin_GPIO16)

#define DEFAULT_UART_BUS_RX (&pin_GPIO13)
#define DEFAULT_UART_BUS_TX (&pin_GPIO12)
