niektb/sluisbrinkie-eurorack-published/Sluisbrinkie Toepler/Software/ports_of_grains/jgb-wavegrains/jgb-wavegrains.ino

// Wavegrains V2.0
//
// based on the Auduino code by Peter Knight, revised and finetuned by Ginkosynthese for use with cv inputs.
// Change to a wavetable oscillator by Janne G:son Berg (jgb @ muffwiggler)
// Version for PCB V2
//
// inputs
// Analog in 0: Pitch CV 0-5 V
// Analog in 1: Wavetable select 0-5 V
// Analog in 2: Sweep between two wavetables 0-5 V
// output
// Digital 11: Audio out (PWM)


#include <avr/io.h>
#include <avr/interrupt.h>
#include <avr/pgmspace.h>

uint16_t syncPhaseAcc;
uint16_t syncPhaseInc;
uint8_t wavetableStep;
uint8_t wavetableA;
uint8_t wavetableB;
uint16_t sweepPosition;

#define PC7 13
#define CV4_PIN PF7
#define CV3_PIN PF6
#define CV2_PIN PF5
#define CV1_PIN PF4
#define PF7 A0
#define PF6 A1
#define PF5 A2
#define PF4 A3
#define PF1 A4
#define PF0 A5

// Define wavetable parameters
#define WT_LENGTH 16
#define WT_NO_OF 32
#define WT_POT_SCALING 5

// Map Analogue channels
#define FREQUENCY CV4_PIN
#define WAVETABLE_SELECT CV2_PIN
#define SWEEP CV3_PIN
#define FREQUENCY_OFFSET CV1_PIN

// Changing these will also requires rewriting audioOn()
#define PWM_PIN 9
#define PWM_VALUE OCR4B
#define LED_PIN PC7
#define LED_PORT PORTC
#define LED_BIT 7
#define PWM_INTERRUPT TIMER4_OVF_vect

// For converting incoming CV to pitch
const uint16_t freqTable[] PROGMEM = {
  549, 550, 552, 554, 556, 557, 559, 561, 563, 565, 566, 568, 570, 572, 574, 575, 577, 579, 581, 583, 585, 586, 588, 590, 592, 594, 596, 598, 600, 601, 603, 605, 607, 609, 611, 613, 615, 617, 619, 621, 623, 625, 627, 629, 631, 633, 635, 637, 639, 641, 643, 645, 647, 649, 651, 653, 655, 657, 659, 661, 663, 666, 668, 670, 672, 674, 676, 678, 680, 683, 685, 687, 689, 691, 693, 696, 698, 700, 702, 705, 707, 709, 711, 714, 716, 718, 720, 723, 725, 727, 729, 732, 734, 736, 739, 741, 743, 746, 748, 751, 753, 755, 758, 760, 763, 765, 767, 770, 772, 775, 777, 780, 782, 785, 787, 790, 792, 795, 797, 800, 802, 805, 807, 810, 812, 815, 818, 820, 823, 825, 828, 831, 833, 836, 838, 841, 844, 846, 849, 852, 855, 857, 860, 863, 865, 868, 871, 874, 876, 879, 882, 885, 888, 890, 893, 896, 899, 902, 905, 908, 910, 913, 916, 919, 922, 925, 928, 931, 934, 937, 940, 943, 946, 949, 952, 955, 958, 961, 964, 967, 970, 973, 976, 979, 982, 985, 989, 992, 995, 998, 1001, 1004, 1007, 1011, 1014, 1017, 1020, 1024, 1027, 1030, 1033, 1037, 1040, 1043, 1046, 1050, 1053, 1056, 1060, 1063, 1067, 1070, 1073, 1077, 1080, 1084, 1087, 1090, 1094, 1097, 1101, 1104, 1108, 1111, 1115, 1118, 1122, 1125, 1129, 1133, 1136, 1140, 1143, 1147, 1151, 1154, 1158, 1162, 1165, 1169, 1173, 1176, 1180, 1184, 1188, 1191, 1195, 1199, 1203, 1207, 1210, 1214, 1218, 1222, 1226, 1230, 1234, 1238, 1242, 1245, 1249, 1253, 1257, 1261, 1265, 1269, 1273, 1277, 1281, 1285, 1290, 1294, 1298, 1302, 1306, 1310, 1314, 1318, 1323, 1327, 1331, 13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
3630, 13673, 13717, 13760, 13804, 13847, 13891, 13935, 13979
};

// Wavetables, to be filled in by randomization and some precalculated waveforms
uint16_t wavetable[WT_NO_OF][WT_LENGTH];

uint16_t mapFreq(uint16_t input) {
  return (pgm_read_word_near(freqTable + input));
}

void audioOn() {
  TCCR4A = _BV(COM4B0) | _BV(PWM4B);
  TCCR4B = _BV(CS40);
  TCCR4C = _BV(COM4B0S);
  TCCR4D = _BV(WGM40);
  TIMSK4 = _BV(TOIE4);
}


void setup() {
  pinMode(PWM_PIN, OUTPUT);
  audioOn();
  pinMode(LED_PIN, OUTPUT);
  // Change random seed value to change the randomized wavetables
  randomSeed(123717284);
  int tmpTable[WT_LENGTH];
  uint16_t maxVal;

  for (int j = 0; j < WT_NO_OF; j++) {
    maxVal = 0;
    for (int i = 0; i < WT_LENGTH; i++) {
      tmpTable[i] = random(-32768, 32767);
      maxVal = abs(tmpTable[i]) > maxVal ? abs(tmpTable[i]) : maxVal;
    }
    // Normalize wavetables
    for (int i = 0; i < WT_LENGTH; i++) {
      wavetable[j][i] = (32768 * tmpTable[i]) / maxVal + 32768;
    }

    // Use up some more random values... totally unnecessary
    for (int i = 0; i < random(4); i++) {
      i == i;
    }
  }

  // Hardcoded wavetables sprinkled among the randomized ones

  // Square one octave up
  wavetable[0][0] = 65535;
  wavetable[0][1] = 65535;
  wavetable[0][2] = 65535;
  wavetable[0][3] = 65535;
  wavetable[0][4] = 0;
  wavetable[0][5] = 0;
  wavetable[0][6] = 0;
  wavetable[0][7] = 0;
  wavetable[0][8] = 65535;
  wavetable[0][9] = 65535;
  wavetable[0][10] = 65535;
  wavetable[0][11] = 65535;
  wavetable[0][12] = 0;
  wavetable[0][13] = 0;
  wavetable[0][14] = 0;
  wavetable[0][15] = 0;

  // Lowest square possible
  wavetable[4][0] = 65535;
  wavetable[4][1] = 65535;
  wavetable[4][2] = 65535;
  wavetable[4][3] = 65535;
  wavetable[4][4] = 65535;
  wavetable[4][5] = 65535;
  wavetable[4][6] = 65535;
  wavetable[4][7] = 65535;
  wavetable[4][8] = 0;
  wavetable[4][9] = 0;
  wavetable[4][10] = 0;
  wavetable[4][11] = 0;
  wavetable[4][12] = 0;
  wavetable[4][13] = 0;
  wavetable[4][14] = 0;
  wavetable[4][15] = 0;

  // Square with two extra peaks
  wavetable[8][0] = 65535;
  wavetable[8][1] = 65535;
  wavetable[8][2] = 65535;
  wavetable[8][3] = 65535;
  wavetable[8][4] = 65535;
  wavetable[8][5] = 65535;
  wavetable[8][6] = 65535;
  wavetable[8][7] = 65535;
  wavetable[8][8] = 0;
  wavetable[8][9] = 65535;
  wavetable[8][10] = 0;
  wavetable[8][11] = 0;
  wavetable[8][12] = 65535;
  wavetable[8][13] = 0;
  wavetable[8][14] = 0;
  wavetable[8][15] = 0;

  // Somewhat random?
  wavetable[9][0] = 8345;
  wavetable[9][1] = 50000;
  wavetable[9][2] = 7643;
  wavetable[9][3] = 65535;
  wavetable[9][4] = 52000;
  wavetable[9][5] = 10000;
  wavetable[9][6] = 20000;
  wavetable[9][7] = 40000;
  wavetable[9][8] = 300;
  wavetable[9][9] = 5120;
  wavetable[9][10] = 60240;
  wavetable[9][11] = 2048;
  wavetable[9][12] = 65535;
  wavetable[9][13] = 0;
  wavetable[9][14] = 58755;
  wavetable[9][15] = 36289;

  // Sawtooth
  wavetable[16][0] = 0x0000;
  wavetable[16][1] = 0x1000;
  wavetable[16][2] = 0x2000;
  wavetable[16][3] = 0x3000;
  wavetable[16][4] = 0x4000;
  wavetable[16][5] = 0x5000;
  wavetable[16][6] = 0x6000;
  wavetable[16][7] = 0x7000;
  wavetable[16][8] = 0x8000;
  wavetable[16][9] = 0x9000;
  wavetable[16][10] = 0xa000;
  wavetable[16][11] = 0xb000;
  wavetable[16][12] = 0xc000;
  wavetable[16][13] = 0xd000;
  wavetable[16][14] = 0xe000;
  wavetable[16][15] = 0xf000;

  // Sine
  wavetable[24][0] = 128 << 8;
  wavetable[24][1] = 176 << 8;
  wavetable[24][2] = 218 << 8;
  wavetable[24][3] = 246 << 8;
  wavetable[24][4] = 255 << 8;
  wavetable[24][5] = 246 << 8;
  wavetable[24][6] = 218 << 8;
  wavetable[24][7] = 176 << 8;
  wavetable[24][8] = 128 << 8;
  wavetable[24][9] = 79 << 8;
  wavetable[24][10] = 37 << 8;
  wavetable[24][11] = 9 << 8;
  wavetable[24][12] = 0 << 8;
  wavetable[24][13] = 9 << 8;
  wavetable[24][14] = 37 << 8;
  wavetable[24][15] = 79 << 8;

  wavetableStep = 0;
}

void loop() {
  // Get CV in and convert it to the phase accumulator
  int pwmv = analogRead(FREQUENCY) + analogRead(FREQUENCY_OFFSET);
  if (pwmv > 1023) pwmv = 1023;
  if (pwmv < 0) pwmv = 0;
  syncPhaseInc = mapFreq(pwmv);

  // Read position of sweep
  sweepPosition = analogRead(SWEEP);

  // Read current wavetable and set up wavetables to morph between
  uint8_t readWavetable = analogRead(WAVETABLE_SELECT) >> WT_POT_SCALING;
  wavetableA = readWavetable;
  wavetableB = (readWavetable + 1) & 0x1f;
}

SIGNAL(PWM_INTERRUPT) {
  uint16_t output;
  uint16_t waveA;
  uint16_t waveB;
  uint32_t delta;
  bool aLarger;

  // Phase accumulator
  syncPhaseAcc += syncPhaseInc;
  if (syncPhaseAcc < syncPhaseInc) {
    // Time to increase the wavetable step
    wavetableStep++;
    wavetableStep &= WT_LENGTH - 1;
    LED_PORT ^= 1 << LED_BIT;  // Faster than using digitalWrite
  }

  // Calculate morphing between wavetables, keep delta value positive
  waveA = (wavetable[wavetableA][wavetableStep]);
  waveB = (wavetable[wavetableB][wavetableStep]);
  if (waveA >= waveB) {
    aLarger = true;
    delta = waveA - waveB;
  } else {
    aLarger = false;
    delta = waveB - waveA;
  }

  delta = (delta * sweepPosition) >> 10;
  output = aLarger ? waveA - delta : waveA + delta;

  // Output to PWM (this is faster than using analogWrite)
  // Scale down to 8 bit value
  PWM_VALUE = output >> 8;
}
