niektb/sluisbrinkie-eurorack-published/Sluisbrinkie Toepler/Software/ports_of_grains/roundhouse/roundhouse.ino

/*
"Roundhouse", a kickdrum synthesizer for Ginkosynthese's "grains" module.
	By Kassen Oud

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
DESCRIPION;
	An attempt to emulate the sound of the Roland TR909 kickdrum in an
	8bit module. For obvious reasons this won't be perfect. For obvious
	reasons this will be great fun. Tltle comes from a type of kick in
	martial arts.

MANUAL;
	Knob 1/ mod 1; Attack
		Increass the prominence of the start of the sound. In particular it
		adds a bit of noise at the start, sweeps the frequency and it also 
		affectsthe waveshaping slightly.
	Knob 2/ mod 2: Length
		The length of the sound and its decay.
	Knob 3 
		The base frequency of your kick. This is not callibrated to a Volt
		per octave as that wouldn't make the most practical use of the knob.
	Mod 3; Trigger
		Feed this a pulse or gate signal to trigger the drum. Only the
		postiteve edge of the signal is used; the sound's duration is set
		purely by knob 3.

*/

/* 11-01-2024 Adapted for the Toepler */



#include <avr/io.h>
#include <avr/interrupt.h>
#include <avr/pgmspace.h>
#include "kas-button.h"  //button debouncing

uint16_t phase_accumulator;  //keeps track of the phase
uint16_t phase_inc;          //phase increase per sample
uint16_t attack_val;         //prominence of the attack in the sound
uint8_t length_val = 127;    //length of the sound
uint8_t decay_counter = 0;   //counter to keep track of same
uint16_t pitch_env = 0;      //downramp that modulates pitch
uint16_t amp_val = 0;        //volume envelope
uint8_t sustain = 255;       //value of the sounds sustain
uint8_t noise_env = 255;     //enveloppe of the innial noise burst
uint16_t drive = 32;         //ratio betwen a triangle and a square.
uint16_t drive_sus = 64;     //minimal amount of drive during the sustain stage
uint16_t output = 127;       //the value we write out
uint16_t last_out = 127;     //last value we wrote out
Button trig;                 //debouncing for the trigger input

#define PF7 A0
#define PF6 A1
#define PF5 A2
#define PF4 A3
#define PF1 A4
#define PF0 A5

// Actual pin mappings
#define CV4_PIN PF7
#define CV3_PIN PF6
#define CV2_PIN PF5
#define CV1_PIN PF4
#define TR1_PIN PE6
#define PE6 7


// Map inputs
#define LENGTH_CONTROL  CV2_PIN
#define ATTACK_CONTROL  CV1_PIN
#define PITCH_CONTROL   CV3_PIN
#define TRIGGER         TR1_PIN

// status LED defines
#define LED_PIN 13
#define LED_PORT PORTC
#define LED_BIT 5
// PWM defines
#define PWM_PIN 9
#define PWM_VALUE OCR4B
#define PWM_INTERRUPT TIMER4_OVF_vect

//maps cv to samples of phase increase each time we output a new value
//this might need tuning in the future
const uint16_t freqTable[] PROGMEM = {
  69, 69, 69, 69, 70, 70, 70, 70, 70, 71,                      //   0 to 9
  71, 71, 71, 72, 72, 72, 72, 73, 73, 73,                      //
  73, 74, 74, 74, 74, 75, 75, 75, 75, 76,                      //
  76, 76, 76, 77, 77, 77, 77, 78, 78, 78,                      //
  78, 79, 79, 79, 79, 80, 80, 80, 81, 81,                      //
  81, 81, 82, 82, 82, 82, 83, 83, 83, 84,                      //
  84, 84, 84, 85, 85, 85, 86, 86, 86, 86,                      //
  87, 87, 87, 88, 88, 88, 88, 89, 89, 89,                      //
  90, 90, 90, 91, 91, 91, 91, 92, 92, 92,                      //
  93, 93, 93, 94, 94, 94, 95, 95, 95, 96,                      //
  96, 96, 97, 97, 97, 97, 98, 98, 98, 99,                      //  100 to 109
  99, 99, 100, 100, 100, 101, 101, 101, 102, 102,              //
  102, 103, 103, 104, 104, 104, 105, 105, 105, 106,            //
  106, 106, 107, 107, 107, 108, 108, 109, 109, 109,            //
  110, 110, 110, 111, 111, 111, 112, 112, 113, 113,            //
  113, 114, 114, 114, 115, 115, 116, 116, 116, 117,            //
  117, 118, 118, 118, 119, 119, 120, 120, 120, 121,            //
  121, 122, 122, 122, 123, 123, 124, 124, 124, 125,            //
  125, 126, 126, 127, 127, 127, 128, 128, 129, 129,            //
  130, 130, 130, 131, 131, 132, 132, 133, 133, 134,            //
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
  1069, 1072, 1076, 1079, 1083, 1087, 1090, 1094, 1098, 1101,  //
  1105, 1109, 1112, 1116, 1120, 1124, 1127, 1131, 1135, 1139,  //
  1143, 1146, 1150, 1154, 1158, 1162, 1166, 1170, 1174, 1178,  //
  1182, 1186, 1189, 1193, 1197, 1201, 1206, 1210, 1214, 1218,  //
  1222, 1226, 1230, 1234, 1238, 1242, 1247, 1251, 1255, 1259,  //
  1263, 1268, 1272, 1276, 1280, 1285, 1289, 1293, 1298, 1302,  //
  1306, 1311, 1315, 1320, 1324, 1328, 1333, 1337, 1342, 1346,  //
  1351, 1355, 1360, 1365, 1369, 1374, 1378, 1383, 1388, 1392,  //
  1397, 1402, 1406, 1411, 1416, 1421, 1425, 1430, 1435, 1440,  //  900 to 909
  1444, 1449, 1454, 1459, 1464, 1469, 1474, 1479, 1484, 1489,  //
  1494, 1499, 1504, 1509, 1514, 1519, 1524, 1529, 1534, 1539,  //
  1545, 1550, 1555, 1560, 1565, 1571, 1576, 1581, 1587, 1592,  //
  1597, 1603, 1608, 1613, 1619, 1624, 1630, 1635, 1641, 1646,  //
  1652, 1657, 1663, 1668, 1674, 1679, 1685, 1691, 1696, 1702,  //
  1708, 1714, 1719, 1725, 1731, 1737, 1742, 1748, 1754, 1760,  //
  1766, 1772, 1778, 1784, 1790, 1796, 1802, 1808, 1814, 1820,  //
  1826, 1832, 1838, 1845, 1851, 1857, 1863, 1869, 1876, 1882,  //
  1888, 1895, 1901, 1907, 1914, 1920, 1927, 1933, 1940, 1946,  //
  1953, 1959, 1966, 1972, 1979, 1986, 1992, 1999, 2006, 2012,  //  1000 to 1009
  2019, 2026, 2033, 2040, 2046, 2053, 2060, 2067, 2074, 2081,  //  1010 to 1019
  2088, 2095, 2102, 2109,                                      //  1020 to 1023
};

uint16_t mapFreq(uint16_t input) {
  return pgm_read_word_near(freqTable + input);
}

//"xorshift" noise generator because "rand()" costs quite a bit of CPU
//borrowed from http://www.arklyffe.com/main/2010/08/29/xorshift-pseudorandom-number-generator/
uint16_t set_seed = 1;
uint16_t rand_seed = 1;
uint16_t rng(void) {
  rand_seed ^= (rand_seed << 13);
  rand_seed ^= (rand_seed >> 9);
  return rand_seed ^= (rand_seed << 7);
}

//sets up pins and configures the samplerate and frequency of the PWM output
void setup() {
  pinMode(TR1_PIN, INPUT_PULLUP);
  trig.pin = TRIGGER;
  // included in code sketch for ATMega32u4
  TCCR4A = _BV(COM4B0) | _BV(PWM4B);
  TCCR4B = _BV(CS40);
  TCCR4C = _BV(COM4B0S);
  TCCR4D = _BV(WGM40);
  TIMSK4 = _BV(TOIE4);
  pinMode(PWM_PIN, OUTPUT);
  PWM_VALUE = 127;
}

void onTrig() {
  //reset the phase of the osc for more consistent results. if you want
  //variations there are modulation inputs (or comment out the line below)
  phase_accumulator = 0;

  sustain = 255;
  amp_val = 255;
  drive = 255;
  attack_val = analogRead(ATTACK_CONTROL);
  //		the noise primarily covers the first 3rd of the "attack" setting,
  //		after which the pitch-sweep takes over.
  noise_env = min(180, (attack_val >> 1));
  drive_sus = attack_val >> 3;
  pitch_env = attack_val;
}

//reads modulation inputs
void loop() {
  //We deal witht the pitch-sweep here so we can keep the progmem read
  //out of the interupt that generates the sound
  int pwmv = min(1023, (analogRead(PITCH_CONTROL) >> 2) + pitch_env);
  phase_inc = mapFreq(pwmv);


  length_val = analogRead(LENGTH_CONTROL) >> 4;

  if (updateButton(&trig) && trig.state) onTrig();
}

//actual work happens here, triggered by an interupt for each output value
//This is meant to be an explanation of what I'm trying to do, not an alternative
//to the ATMEL datasheet, C/C++ specifaction or general DSP knowledge. However,
//with a serach enigne at hand and some dedication the below should be intelligible.
SIGNAL(PWM_INTERRUPT) {
  //start by increasing the phase
  phase_accumulator += phase_inc;

  //The pases-accumulator is basically just a saw-wave, going up, over 16 bits.


  //by discarding the two most signifficant bits we turn that into 4 upward ramps,
  //each covering 14 bits.
  output = (phase_accumulator & 0b0011111111111111);

  //This signal we reduce to 7bits. Our final result will be 8 bit, but we reserve
  //one bit for the polarity
  output = output >> 7;

  //We now invert every second of the 4 up-ramps, which gives us 2 triangle-waves,
  //at double the speed of the saw-wave we started with. Later we'll invert the 2nd
  //triangle, to get a single triangle, back at the original frequency, bu tby not
  //doing that yet we can do symetrical clipping using unsigned integers.
  if (phase_accumulator & 0b0100000000000000) output = 127 - output;

  //We add the bit of noise of the attack before we deal with the clipping
  if (noise_env) {
    output = (((rng() >> 8) * noise_env) >> 8);
    noise_env--;
  }

  //We multiply the signal by the "drive" factor, which amplifies our triangles
  //before they get clipped. The end result is a sort of morph between a triangle
  //and a square wave. A drive of 32, here, would come down to a non-clipped triangle
  //anything above that will start the clipping.
  output *= drive;
  output = output >> 5;
  if (output > 127) output = 127;

  //Then we apply the actual amplitude enveloppe. We do this before making the signal
  //bipolar and suitable for sending to the output because at this point it's way faster
  //to do so as we can avoid using signed integers.
  output = (output * amp_val) >> 8;

  //We detect whether we are in the 2nd half of our waveform's cycle by looking at
  //the most signifficant bit of the phase accumulator. Note that the PWM output
  //takes an unsigned 8bit value, and so 127 is actually what we'd call "0" or
  //"the centre" of our output. So; we invert around that.
  if (phase_accumulator & 0b1000000000000000)
    output = 127 - output;
  else
    output += 127;

  //Finally we apply a first order lowpass filter by adding one part of the signal
  //we just generated to 3 parts of the last value we calculated and dividing by 4.
  //This takes the rough edges off the hard-clipping we just performed.
  output = (output + last_out + last_out + last_out) >> 2;

  //done! We send the result out.
  PWM_VALUE = output;

  //we store the value we just generated so we can use it next round for that
  //lowpass filter we just applied
  last_out = output;


  //Time to take care of our modulation signals. Mostly these are just linear
  //ramps going down
  if (amp_val) {
    //this counter and the variable scale the systain, decay and contour of
    //the drive effect to the sound's length.
    if (decay_counter >= length_val) {
      if (sustain) {
        sustain--;
        if (drive > drive_sus) drive--;
      } else {
        //non-linear amplitude decay
        amp_val = (amp_val * 254) >> 8;
        //as the note dies out it'll also lose harmonics
        if (drive > 32) drive--;
      }
      decay_counter = 0;
    } else decay_counter++;
  }
  //note that the pitch-sweep in the attack of the sound is not scaled by
  //the note's length
  if (pitch_env) pitch_env--;
}
