niektb/sluisbrinkie-eurorack-published/Sluisbrinkie Braun/Software/pins_arduino.h

#pragma once

// Pin definitions taken from:
//    https://learn.adafruit.com/assets/100337

// Serial
#define PIN_SERIAL1_TX (31u)
#define PIN_SERIAL1_RX (31u)

// Not pinned out
#define PIN_SERIAL2_TX (31u)
#define PIN_SERIAL2_RX (31u)

// Not pinned out
#define PIN_SPI0_MISO  (31u)
#define PIN_SPI0_MOSI  (31u)
#define PIN_SPI0_SCK   (31u)
#define PIN_SPI0_SS    (31u)

// Not pinned out
#define PIN_SPI1_MISO  (31u)
#define PIN_SPI1_MOSI  (11u)
#define PIN_SPI1_SCK   (10u)
#define PIN_SPI1_SS    (9u)

// Wire
#define __WIRE0_DEVICE i2c1
#define PIN_WIRE0_SDA  (31u)
#define PIN_WIRE0_SCL  (31u)
#define __WIRE1_DEVICE i2c0
#define PIN_WIRE1_SDA  (31u)
#define PIN_WIRE1_SCL  (31u)

#define SERIAL_HOWMANY (0u)
#define SPI_HOWMANY    (1u)
#define WIRE_HOWMANY   (0u)

// Braun pins
#define OUT1 (0u)
#define OUT2 (1u)
#define SW1 (8u)
#define CV1 (26u)
#define CV2 (27u)
#define CV3 (28u)
#define CV4 (29u)
#define DC (8u)
#define ENCA (24u)
#define ENCB (25u)


#include "../generic/common.h"
