niektb/sluisbrinkie-eurorack-published/Sluisbrinkie Toepler/Software/ports_of_grains/jgb-RZ1-drums-V2-2/jgb-RZ1-drums-V2-2.ino

// amplegrains V1.0
//
// based on the Auduino code by Peter Knight, revised and finetuned by Ginkosynthese for use with cv inputs.
// Change to a sample player by Janne G:son Berg (jgb @ muffwiggler)
//
// inputs
// Analog in 3: Trigger
// Analog in 2: Pitch CV 0-5 V
// Analog in 1: Select sample to play
// output
// Digital 11: Audio out (PWM)


#include <avr/io.h>
#include <avr/interrupt.h>
#include <avr/pgmspace.h>

uint16_t syncPhaseAcc;
uint16_t syncPhaseInc;
uint16_t sampleStep;

uint8_t selectedSample;
uint16_t output;
bool play;

boolean clockHigh;
boolean previousClockHigh;
uint8_t trigger;
uint8_t bitmask;

#define PF7 A0
#define PF6 A1
#define PF5 A2
#define PF4 A3
#define PF1 A4
#define PF0 A5

// Actual pin mappings
#define CV4_PIN PF7
#define CV3_PIN PF6
#define CV2_PIN PF5
#define CV1_PIN PF4
#define TR1_PIN PE6
#define PE6 7

// Map Analogue channels
#define TRIGGER CV4_PIN
#define FREQUENCY CV3_PIN
#define BITRATE CV1_PIN
#define SAMPLE_SELECT CV2_PIN

// status LED defines
#define LED_PIN 13
#define LED_PORT PORTC
#define LED_BIT 5
// PWM defines
#define PWM_PIN 9
#define PWM_VALUE OCR4B
#define PWM_INTERRUPT TIMER4_OVF_vect

// For converting incoming CV to pitch

const uint16_t freqTable[] = {
  549,
  552,
  556,
  559,
  563,
  566,
  570,
  574,
  577,
  581,
  585,
  588,
  592,
  596,
  600,
  603,
  607,
  611,
  615,
  619,
  623,
  627,
  631,
  635,
  639,
  643,
  647,
  651,
  655,
  659,
  663,
  668,
  672,
  676,
  680,
  685,
  689,
  693,
  698,
  702,
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
};

#define KICK 734
#define SNARE 1295
#define LOWTOM 1528
#define MIDTOM 1549
#define HITOM 1656
#define CLAP 979
#define COWBELL 757
#define CHH 582
#define OHH 4852
#define CRASH 5420


// Define sample parameters
#define MAX_SAMPLES KICK + SNARE + LOWTOM + MIDTOM + HITOM + CLAP + CHH + OHH + CRASH + 4
// Samples to play
const uint8_t sample[MAX_SAMPLES] PROGMEM = {
  // Kick
  // 128, 128, 128, 128, 128, 128, 128, 128, 128, 128, 128, 128, 127, 127, 127, 127, 127, 127, 127, 127, 127, 127, 127, 127, 127, 127, 128, 128, 128, 128, 128, 128, 128, 128, 127, 127, 128, 127, 128, 128, 128, 128, 128, 128, 128, 128, 128, 128, 128, 128, 128, 128, 128, 127, 127, 127, 127, 127, 128, 128, 128, 128, 128, 128, 128, 128, 128, 127, 128, 127, 127, 127, 127, 127, 128, 128, 128, 128, 128, 128, 128, 128, 127, 127, 127, 127, 127, 127, 128, 128, 128, 128, 128, 128, 127, 127, 127, 127, 127, 127, 127, 127, 128, 128, 128, 128, 128, 128, 128, 127, 127, 127, 127, 127, 127, 127, 127, 127, 127, 127, 127, 127, 127, 127, 127, 127, 126, 126, 125, 125, 124, 124, 123, 123, 122, 122, 122, 121, 121, 121, 120, 120, 120, 119, 118, 118, 117, 116, 116, 115, 114, 113, 112, 111, 110, 109, 108, 107, 106, 105, 104, 103, 101, 100, 99, 98, 96, 95, 95, 94, 95, 96, 98, 101, 106, 110, 115, 120, 123, 126, 128, 128, 127, 125, 121, 117, 113, 109, 105, 101, 99, 96, 97, 99, 101, 103, 104, 102, 101, 103, 107, 112, 117, 117, 110, 100, 88, 78, 74, 78, 87, 101, 119, 137, 155, 171, 183, 190, 193, 193, 191, 188, 185, 179, 172, 163, 153, 144, 139, 136, 137, 142, 148, 156, 167, 178, 187, 192, 191, 183, 170, 157, 144, 137, 135, 137, 142, 149, 157, 166, 176, 187, 195, 202, 207, 208, 208, 207, 205, 204, 204, 204, 205, 206, 206, 203, 199, 195, 190, 188, 188, 190, 194, 200, 207, 214, 221, 226, 229, 230, 229, 226, 222, 218, 211, 205, 198, 190, 183, 179, 177, 180, 188, 198, 208, 216, 222, 223, 222, 219, 212, 204, 193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
, 126, 127, 127, 126, 127, 128, 128, 128, 127, 127, 128, 127, 128, 129, 129, 129, 129, 129, 129, 128, 129, 128, 128, 128, 128, 128, 128, 128, 128, 127, 128, 127, 127, 127, 127, 126, 127, 127, 126, 126, 126, 126, 126, 126, 125, 125, 125, 125, 125, 125, 125, 125, 125, 124, 124, 124, 124, 124, 124, 124, 124, 124, 124, 124, 124, 124, 124, 124, 124, 124, 124, 124, 124, 124, 124, 124, 124, 125, 125, 125, 125, 125, 125, 125, 125, 125, 125, 125, 126, 126, 126, 126, 126, 126, 126, 126, 127, 127, 127, 127, 127, 127, 127,

  // Snare
  126, 130, 125, 130, 125, 128, 126, 127, 123, 130, 122, 131, 122, 134, 128, 133, 132, 64, 110, 90, 84, 96, 99, 91, 134, 145, 129, 186, 125, 136, 196, 144, 171, 205, 194, 201, 202, 165, 150, 121, 137, 131, 105, 162, 27, 119, 163, 156, 176, 141, 165, 124, 148, 88, 86, 48, 19, 34, 32, 26, 36, 43, 63, 65, 67, 61, 53, 68, 89, 92, 77, 105, 80, 135, 155, 173, 150, 130, 172, 191, 195, 211, 214, 206, 238, 225, 235, 229, 227, 220, 219, 207, 194, 174, 153, 138, 127, 143, 104, 110, 81, 62, 99, 58, 58, 48, 35, 29, 22, 38, 52, 81, 86, 84, 93, 88, 71, 107, 116, 103, 104, 113, 130, 167, 164, 167, 188, 192, 223, 195, 194, 197, 209, 202, 176, 180, 170, 172, 161, 161, 153, 151, 143, 118, 108, 109, 110, 114, 115, 100, 111, 103, 104, 110, 98, 116, 98, 87, 89, 80, 74, 64, 83, 76, 82, 92, 80, 94, 99, 99, 106, 120, 133, 135, 145, 144, 148, 163, 184, 177, 169, 180, 177, 191, 195, 198, 181, 181, 183, 165, 167, 144, 128, 141, 144, 127, 122, 125, 104, 104, 100, 100, 100, 96, 89, 76, 87, 77, 78, 77, 58, 64, 63, 63, 69, 67, 90, 91, 97, 120, 130, 145, 149, 153, 171, 167, 179, 173, 185, 198, 182, 195, 190, 187, 191, 180, 162, 157, 144, 138, 116, 109, 107, 114, 126, 108, 117, 130, 113, 122, 121, 108, 113, 111, 104, 87, 91, 71, 89, 93, 86, 92, 92, 99, 91, 108, 104, 100, 107, 104, 115, 127, 136, 144, 143, 160, 152, 165, 165, 150, 157, 162, 176, 176, 171, 177, 178, 175, 169, 160, 164, 154, 156, 141, 135, 130, 123, 104, 114, 113, 93, 95, 116, 103, 90, 99, 81, 87, 71, 68, 63, 77, 66, 75, 78, 95, 103, 86, 122, 11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
, 127, 127, 128, 128, 127, 128, 127, 127, 127, 127, 127, 127, 128, 128, 127, 128, 128, 128, 128, 128, 128, 128, 128, 128, 128, 127, 127, 127, 127, 127, 127, 128, 128, 128, 128, 128, 128, 128, 128, 128, 128, 128, 128, 128, 128, 128, 128, 128, 128, 127, 127, 127, 127, 127, 126, 126, 126, 126, 126, 126, 126, 126, 126, 127, 127, 127, 128, 127, 128,

  // Low tom
  127, 127, 127, 128, 127, 128, 126, 127, 126, 129, 125, 129, 126, 166, 213, 190, 162, 136, 136, 152, 126, 54, 2, 27, 57, 71, 85, 24, 61, 138, 124, 92, 117, 179, 174, 164, 144, 140, 164, 167, 169, 167, 142, 153, 171, 153, 145, 153, 153, 153, 158, 155, 141, 144, 165, 156, 125, 132, 133, 110, 126, 123, 109, 107, 85, 77, 83, 89, 90, 72, 60, 71, 79, 93, 113, 126, 127, 121, 136, 134, 140, 149, 147, 133, 140, 168, 163, 156, 152, 166, 178, 185, 170, 158, 157, 159, 151, 132, 130, 126, 113, 106, 104, 100, 111, 116, 108, 106, 116, 115, 110, 105, 89, 81, 89, 100, 95, 89, 92, 92, 101, 102, 103, 138, 150, 144, 148, 144, 147, 156, 156, 158, 154, 149, 160, 168, 173, 166, 166, 168, 170, 163, 144, 126, 114, 116, 109, 107, 107, 111, 118, 113, 111, 119, 110, 99, 99, 95, 93, 87, 80, 85, 93, 101, 123, 136, 130, 131, 148, 152, 139, 138, 138, 131, 135, 146, 149, 138, 128, 133, 139, 146, 150, 151, 162, 171, 165, 164, 160, 154, 153, 134, 118, 121, 112, 102, 110, 119, 112, 105, 117, 122, 118, 113, 103, 100, 92, 91, 92, 85, 88, 95, 105, 107, 107, 121, 132, 145, 151, 149, 148, 142, 144, 152, 155, 158, 157, 156, 153, 149, 152, 155, 151, 147, 147, 147, 141, 144, 142, 129, 121, 115, 102, 97, 109, 118, 119, 120, 118, 115, 119, 127, 123, 110, 111, 111, 101, 104, 102, 92, 97, 104, 107, 116, 123, 125, 130, 134, 134, 135, 138, 135, 138, 155, 157, 150, 151, 151, 141, 139, 146, 142, 144, 150, 152, 152, 145, 146, 146, 141, 132, 123, 121, 114, 105, 106, 116, 112, 107, 114, 115, 116, 122, 120, 109, 106, 108, 107, 10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

  // Mid tom
  127, 127, 127, 127, 127, 127, 127, 127, 127, 126, 126, 128, 127, 127, 126, 126, 126, 127, 128, 127, 125, 132, 187, 204, 180, 160, 130, 118, 149, 167, 65, 24, 73, 82, 98, 53, 38, 59, 53, 29, 20, 91, 132, 134, 149, 157, 156, 128, 155, 202, 201, 205, 197, 194, 178, 171, 172, 177, 165, 145, 139, 142, 154, 142, 125, 153, 189, 164, 115, 84, 91, 109, 127, 118, 108, 113, 109, 116, 117, 99, 97, 97, 104, 129, 137, 122, 91, 86, 99, 94, 55, 41, 40, 75, 116, 101, 125, 142, 128, 123, 125, 141, 158, 167, 167, 177, 187, 184, 180, 170, 181, 184, 170, 166, 167, 164, 158, 148, 133, 125, 122, 122, 114, 97, 95, 104, 111, 108, 94, 87, 83, 90, 97, 98, 109, 119, 117, 115, 121, 119, 110, 99, 97, 111, 120, 128, 130, 126, 129, 124, 120, 124, 125, 128, 138, 136, 129, 145, 161, 164, 158, 139, 133, 143, 150, 155, 164, 164, 155, 153, 162, 170, 161, 144, 126, 117, 124, 123, 117, 117, 119, 122, 117, 106, 94, 88, 93, 97, 99, 103, 109, 108, 107, 112, 108, 98, 93, 93, 97, 108, 120, 125, 122, 126, 131, 132, 136, 136, 138, 144, 149, 157, 161, 164, 160, 150, 148, 142, 140, 147, 147, 147, 150, 147, 139, 135, 128, 126, 128, 122, 121, 128, 139, 141, 136, 135, 130, 126, 122, 112, 105, 103, 103, 107, 120, 123, 118, 116, 104, 96, 95, 96, 101, 104, 108, 106, 107, 115, 115, 115, 116, 117, 120, 127, 133, 132, 138, 155, 166, 163, 159, 156, 149, 150, 155, 151, 151, 153, 148, 143, 135, 128, 129, 135, 132, 134, 138, 135, 131, 131, 132, 131, 127, 125, 123, 123, 118, 115, 111, 110, 113, 102, 98, 104, 105, 108, 114, 121, 128, 1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

  // Hi tom
  127, 127, 127, 127, 127, 128, 127, 127, 127, 127, 126, 127, 128, 127, 128, 128, 126, 126, 128, 127, 127, 128, 128, 127, 129, 128, 127, 137, 188, 197, 167, 148, 135, 125, 123, 128, 104, 83, 109, 152, 123, 102, 95, 76, 21, 21, 34, 29, 95, 104, 107, 121, 121, 114, 128, 144, 140, 152, 165, 173, 178, 191, 196, 199, 178, 161, 161, 159, 176, 165, 150, 150, 157, 157, 147, 146, 138, 140, 138, 129, 124, 118, 112, 108, 114, 123, 116, 121, 127, 114, 112, 117, 117, 123, 126, 114, 110, 116, 122, 115, 113, 118, 115, 115, 105, 102, 109, 107, 109, 109, 106, 106, 111, 105, 100, 109, 113, 100, 95, 86, 85, 98, 98, 104, 110, 128, 123, 109, 115, 139, 142, 124, 133, 146, 154, 154, 162, 164, 171, 175, 169, 171, 170, 173, 168, 163, 156, 159, 169, 165, 160, 158, 154, 145, 145, 146, 139, 133, 123, 109, 110, 111, 111, 119, 120, 115, 106, 102, 93, 90, 99, 102, 100, 98, 99, 93, 98, 106, 113, 117, 111, 112, 113, 113, 116, 120, 122, 121, 124, 126, 129, 129, 129, 124, 124, 128, 128, 126, 127, 131, 132, 125, 120, 116, 116, 121, 123, 120, 116, 129, 134, 127, 131, 142, 148, 152, 151, 143, 145, 146, 148, 148, 145, 151, 161, 170, 171, 166, 164, 158, 155, 158, 162, 161, 154, 145, 144, 140, 129, 127, 127, 118, 112, 110, 103, 95, 95, 95, 94, 96, 95, 94, 90, 91, 95, 96, 97, 99, 101, 98, 98, 104, 115, 120, 121, 120, 119, 127, 130, 130, 131, 132, 133, 131, 133, 137, 136, 133, 135, 135, 134, 136, 136, 137, 137, 135, 131, 129, 127, 126, 127, 128, 126, 125, 130, 133, 133, 130, 131, 128, 127, 134, 140, 144, 143, 141, 138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

  // Handclap
  128, 128, 128, 127, 128, 127, 127, 128, 127, 127, 129, 126, 127, 133, 129, 130, 134, 119, 103, 111, 126, 142, 159, 138, 109, 115, 131, 122, 122, 136, 130, 130, 130, 122, 139, 140, 108, 105, 130, 136, 128, 125, 130, 127, 127, 135, 141, 143, 147, 154, 81, 13, 0, 70, 231, 249, 255, 206, 41, 0, 17, 141, 218, 178, 157, 191, 206, 99, 29, 78, 130, 118, 119, 161, 148, 98, 80, 117, 173, 194, 176, 123, 65, 95, 133, 114, 102, 118, 143, 151, 154, 116, 114, 157, 122, 87, 133, 128, 120, 180, 164, 119, 119, 99, 82, 125, 138, 124, 132, 136, 152, 150, 90, 63, 139, 170, 141, 138, 76, 88, 206, 167, 108, 134, 131, 108, 110, 123, 106, 131, 158, 128, 106, 144, 156, 124, 153, 148, 128, 119, 62, 84, 164, 148, 81, 67, 112, 191, 219, 214, 130, 39, 72, 82, 70, 144, 203, 161, 150, 191, 129, 82, 127, 112, 75, 101, 135, 164, 177, 166, 130, 54, 30, 94, 151, 177, 199, 189, 106, 51, 125, 146, 113, 158, 153, 99, 128, 153, 105, 79, 122, 162, 157, 134, 124, 121, 110, 108, 108, 138, 152, 121, 131, 171, 155, 91, 82, 132, 151, 133, 125, 140, 129, 101, 117, 125, 142, 154, 138, 133, 110, 103, 120, 122, 136, 129, 125, 133, 128, 146, 151, 132, 95, 103, 151, 137, 122, 135, 115, 105, 128, 144, 129, 125, 138, 127, 112, 130, 146, 131, 123, 132, 139, 128, 113, 110, 113, 132, 142, 129, 130, 160, 143, 87, 94, 131, 150, 148, 118, 113, 125, 128, 140, 136, 126, 124, 149, 133, 85, 119, 136, 113, 135, 145, 127, 129, 131, 128, 130, 121, 111, 124, 130, 125, 130, 145, 148, 128, 110, 119, 120, 125, 144, 124, 112, 123, 139, 148, 131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
126, 128, 128, 127, 127, 127, 127, 127, 127, 127, 127, 127, 128, 127, 127, 127, 128, 127, 127, 126, 128, 128, 126, 128, 128, 127, 126, 128, 128, 126, 127, 128, 127, 127, 127, 128, 127, 126, 129, 127, 126, 128,

  // Crash cymbal
  128, 127, 128, 127, 128, 127, 128, 127, 128, 129, 126, 127, 128, 129, 125, 129, 127, 126, 128, 124, 126, 131, 127, 132, 129, 128, 125, 123, 125, 128, 129, 128, 129, 124, 127, 122, 125, 124, 130, 133, 130, 126, 131, 129, 130, 120, 122, 132, 124, 129, 127, 131, 139, 133, 121, 119, 104, 121, 146, 152, 145, 130, 112, 98, 90, 104, 130, 166, 178, 165, 141, 110, 107, 104, 105, 102, 121, 117, 132, 140, 144, 155, 139, 136, 129, 113, 108, 121, 123, 136, 144, 143, 141, 123, 104, 108, 106, 113, 130, 137, 144, 150, 152, 133, 120, 107, 110, 134, 131, 124, 126, 120, 125, 133, 131, 129, 135, 126, 126, 123, 119, 135, 140, 134, 128, 117, 114, 120, 132, 148, 146, 137, 122, 101, 97, 117, 140, 146, 144, 136, 136, 132, 123, 117, 117, 114, 109, 125, 121, 136, 144, 140, 162, 151, 131, 124, 117, 89, 105, 112, 108, 142, 136, 143, 146, 142, 144, 142, 114, 111, 103, 92, 103, 127, 154, 134, 165, 155, 144, 125, 103, 114, 120, 120, 111, 136, 125, 130, 131, 133, 146, 140, 128, 136, 120, 98, 112, 115, 125, 137, 141, 130, 151, 132, 127, 134, 122, 118, 109, 128, 131, 135, 117, 126, 127, 122, 125, 133, 139, 129, 144, 141, 134, 115, 108, 119, 115, 121, 120, 130, 137, 135, 141, 146, 131, 125, 118, 112, 136, 115, 130, 136, 117, 103, 127, 137, 136, 142, 136, 138, 123, 127, 123, 134, 112, 116, 99, 130, 136, 134, 141, 160, 155, 111, 128, 89, 114, 116, 134, 128, 145, 131, 135, 150, 119, 127, 95, 103, 125, 143, 126, 138, 120, 152, 140, 134, 139, 127, 117, 121, 122, 94, 128, 100, 140, 142, 146, 138, 144, 128, 124, 108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
8, 127, 128, 126, 127, 127, 128, 127, 127,

  // Additional
  127, 127, 127, 127
};

const uint16_t sampleStart[] = {
  0,
  KICK,
  KICK + SNARE,
  KICK + SNARE + LOWTOM,
  KICK + SNARE + LOWTOM + MIDTOM,
  KICK + SNARE + LOWTOM + MIDTOM + HITOM,
  KICK + SNARE + LOWTOM + MIDTOM + HITOM + CLAP,
  KICK + SNARE + LOWTOM + MIDTOM + HITOM + CLAP + CHH,
  KICK + SNARE + LOWTOM + MIDTOM + HITOM + CLAP + CHH + OHH,
  0                                                                                     // Silent
};

const uint16_t sampleLength[] = {
  KICK,
  SNARE,
  LOWTOM,
  MIDTOM,
  HITOM,
  CLAP,
  CHH,
  OHH,
  CRASH
};

const int num_samples = sizeof(sampleLength) / sizeof(uint16_t);

void audioOn() {
  // Set up PWM to 31.25kHz, phase accurate

  TCCR4A = _BV(COM4B0) | _BV(PWM4B);
  TCCR4B = _BV(CS40);
  TCCR4C = _BV(COM4B0S);
  TCCR4D = _BV(WGM40);
  TIMSK4 = _BV(TOIE4);
}


void setup() {
  pinMode(PWM_PIN, OUTPUT);
  audioOn();
  pinMode(LED_PIN, OUTPUT);
  pinMode(TR1_PIN, INPUT_PULLUP);


  bitmask = 0;
  sampleStep = 0;
  play = false;
  clockHigh = false;
  previousClockHigh = false;
}

void loop() {
  syncPhaseInc = (freqTable[(analogRead(FREQUENCY)) >> 1] << 2);

  selectedSample = map(analogRead(SAMPLE_SELECT), 0, 1023, 0, 17);

  // Get triggers and rate values
  trigger = analogRead(TRIGGER);

  // Going from low to high, ie incoming clock pulse
  if ((trigger > 128) && !clockHigh) {
    clockHigh = true;
    sampleStep = 0;
    play = true;
    digitalWrite(LED_PIN, 1);
  }

  // Going from high to low, end of incoming clock pulse
  if ((trigger <= 128) && clockHigh) {
    clockHigh = false;
    digitalWrite(LED_PIN, 0);
  }
  bitmask = ~(255-((analogRead(BITRATE)) >> 2)) >> 3;

  //bitmask = ~((analogRead(BITRATE)) >> 3);
}

SIGNAL(PWM_INTERRUPT) {

  syncPhaseAcc += syncPhaseInc;
  if ((syncPhaseAcc < syncPhaseInc) && play) {
    // Time to increase the sample step
    if (++sampleStep >= sampleLength[selectedSample % num_samples]) {
      play = false;
      output = 128;
    } else {
      output = pgm_read_byte(&sample[sampleStart[selectedSample % num_samples] + sampleStep]);
      output ^= bitmask;
    }
  }
  // Output to PWM (this is faster than using analogWrite)
  PWM_VALUE = output;
}
