niektb/sluisbrinkie-eurorack-published/Sluisbrinkie Toepler/Software/ports_of_grains/Grains-Scheveningen/Grains-Scheveningen.ino

/*
###
2024 - 02 - 21: Port for Sluisbrinkie Toepler. Port is released under the same license as the original software.
CV 1: Base Pitch
CV 2: Amount of Wavefolding
CV 3: Pitch of second oscillator
CV 4: CV Input (for Base Pitch)
###

	"West Coast Osc" / "Scheveningen"; an oscillator for the Ginko Synthese "Grains" module,
	by Kassen Oud. This is based on the "West Coast" style of synthesis, where
	we build up sounds starting with a simple waveform and adding harmonics, as
	opposed to starting with a harmonically rich sound and filtering that down.
	All synthesis bits written by Kassen Oud, using infrastructure borrowed from
	Peter Knight's work, which was adapted by Jan Willem before I got my hands on
	it.

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
DESCRIPTION:
	We use two sine waves, the first we'll call the "master", the second the
	"slave". The master just tracks the pitch CV. The slave is some set
	interval above the master. In addition the slave is hard-synced to the
	master. These two are ring-modulating each other. This is followed by a
	wave-folder; a classical "West Coast" style effect which is a bit like a
	clip, except once the wave hits the maximum excursion it "folds" back
	towards the centre. Of these two effects, the ring-modulator and the
	wave-wrapper, the first is more mellow and smooth, while the second tends
	to be more up-front. By combining those, and modulating them, we can get a
	rich pallet of timbres from a relatively simple module like the Grains.

	I tried to comment all of this so people who'd like to can learn from it or
	borrow ideas. However, because we're also trying to do fairly advanced 
	stuff on a modest CPU, there is some trickery going on that may be hard to
	understand for people who aren't yet familiar with the intricacies of 
	digital integer math and bitwise operations. If that's you then perhaps the
	"PWM-SAW" code would be a better place to start your journey.

MANUAL:
	Knob 1 / mod 1:
		Offset of the slave oscillator's pitch, relative to the master's.
	Knob 2 / mod 2:
		Amount of wave-folding.
	Knob 3: Base Tuning.
		Sets the base pitch.
	Mod 3; Pitch Modulation
		This CV gets added to the value set by Knob 3.

CHANGELOG:
	Oct 2 2020; initial release
*/

//libraries used
#include <avr/io.h>
#include <avr/interrupt.h>
#include <avr/pgmspace.h>

//variables
bool master_polarity = 0;
bool slave_polarity = 0;
uint8_t output = 0;
uint16_t master_phase = 0;
uint16_t phase_inc = 1;
uint16_t slave_offset_current = 1;
uint16_t slave_offset_measured = 1;
uint16_t wrap_factor = 64;
uint16_t neg_wrap_factor = 64;
uint16_t slave_phase = 0;
uint16_t master_value = 0;
uint16_t slave_value = 0;
uint32_t accumulator = 0;  //I want a hardware accumulator :-(


#define CV4_PIN PF7
#define CV3_PIN PF6
#define CV2_PIN PF5
#define CV1_PIN PF4
#define PF7 A0
#define PF6 A1
#define PF5 A2
#define PF4 A3
#define PF1 A4
#define PF0 A5
// Map inputs
#define SLAVE_KNOB CV3_PIN
#define WRAP_KNOB CV2_PIN
#define PITCH_KNOB CV1_PIN
#define PITCH_CV CV4_PIN

// Changing these will also requires rewriting audioOn()
// PWM defines
#define PWM_PIN 9
#define PWM_VALUE OCR4B
#define PWM_INTERRUPT TIMER4_OVF_vect

//table mapping CV values measured to phase increase per sample
const uint16_t freqTable[] PROGMEM = {
  69, 69, 69, 69, 70, 70, 70, 70, 70, 71, 71, 71, 71, 72, 72,
  72, 72, 73, 73, 73, 73, 74, 74, 74, 74, 75, 75, 75, 75, 76,
  76, 76, 76, 77, 77, 77, 77, 78, 78, 78, 79, 79, 79, 79, 80,
  80, 80, 80, 81, 81, 81, 82, 82, 82, 82, 83, 83, 83, 83, 84,
  84, 84, 85, 85, 85, 85, 86, 86, 86, 87, 87, 87, 88, 88, 88,
  88, 89, 89, 89, 90, 90, 90, 91, 91, 91, 91, 92, 92, 92, 93,
  93, 93, 94, 94, 94, 95, 95, 95, 96, 96, 96, 97, 97, 97, 98,
  98, 98, 99, 99, 99, 100, 100, 100, 101, 101, 101, 102, 102, 102, 103,
  103, 103, 104, 104, 104, 105, 105, 105, 106, 106, 107, 107, 107, 108, 108,
  108, 109, 109, 109, 110, 110, 111, 111, 111, 112, 112, 112, 113, 113, 114,
  114, 114, 115, 115, 116, 116, 116, 117, 117, 117, 118, 118, 119, 119, 119,
  120, 120, 121, 121, 122, 122, 122, 123, 123, 124, 124, 124, 125, 125, 126,
  126, 127, 127, 127, 128, 128, 129, 129, 130, 130, 130, 131, 131, 132, 132,
  133, 133, 134, 134, 135, 135, 135, 136, 136, 137, 137, 138, 138, 139, 139,
  140, 140, 141, 141, 142, 142, 142, 143, 143, 144, 144, 145, 145, 146, 146,
  147, 147, 148, 148, 149, 149, 150, 150, 151, 151, 152, 152, 153, 154, 154,
  155, 155, 156, 156, 157, 157, 158, 158, 159, 159, 160, 160, 161, 161, 162,
  163, 163, 164, 164, 165, 165, 166, 166, 167, 168, 168, 169, 169, 170, 170,
  171, 172, 172, 173, 173, 174, 175, 175, 176, 176, 177, 178, 178, 179, 179,
  180, 181, 181, 182, 182, 183, 184, 184, 185, 186, 186, 187, 187, 188, 189,
  189, 190, 191, 191, 192, 193, 193, 194, 195, 195, 196, 197, 197, 198, 199,
  199, 200, 201, 201, 202, 203, 203, 204, 205, 205, 206, 207, 207, 208, 209,
  210, 210, 211, 212, 212, 213, 214, 215, 215, 216, 217, 218, 218, 219, 220,
  220, 221, 222, 223, 223, 224, 225, 226, 227, 227, 228, 229, 230, 230, 231,
  232, 233, 234, 234, 235, 236, 237, 238, 238, 239, 240, 241, 242, 242, 243,
  244, 245, 246, 247, 247, 248, 249, 250, 251, 252, 252, 253, 254, 255, 256,
  257, 258, 259, 259, 260, 261, 262, 263, 264, 265, 266, 267, 267, 268, 269,
  270, 271, 272, 273, 274, 275, 276, 277, 278, 278, 279, 280, 281, 282, 283,
  284, 285, 286, 287, 288, 289, 290, 291, 292, 293, 294, 295, 296, 297, 298,
  299, 300, 301, 302, 303, 304, 305, 306, 307, 308, 309, 310, 311, 312, 314,
  315, 316, 317, 318, 319, 320, 321, 322, 323, 324, 325, 327, 328, 329, 330,
  331, 332, 333, 334, 335, 337, 338, 339, 340, 341, 342, 344, 345, 346, 347,
  348, 349, 351, 352, 353, 354, 355, 357, 358, 359, 360, 361, 363, 364, 365,
  366, 368, 369, 370, 371, 373, 374, 375, 376, 378, 379, 380, 382, 383, 384,
  385, 387, 388, 389, 391, 392, 393, 395, 396, 397, 399, 400, 401, 403, 404,
  405, 407, 408, 410, 411, 412, 414, 415, 417, 418, 419, 421, 422, 424, 425,
  427, 428, 429, 431, 432, 434, 435, 437, 438, 440, 441, 443, 444, 446, 447,
  449, 450, 452, 453, 455, 456, 458, 460, 461, 463, 464, 466, 467, 469, 471,
  472, 474, 475, 477, 479, 480, 482, 484, 485, 487, 488, 490, 492, 493, 495,
  497, 498, 500, 502, 504, 505, 507, 509, 510, 512, 514, 516, 517, 519, 521,
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
};

uint16_t mapFreq(uint16_t input) {
  return pgm_read_word_near(freqTable + input);
}

void audioOn() {
  // Set up PWM to 31.25kHz, phase accurate

  TCCR4A = _BV(COM4B0) | _BV(PWM4B);
  TCCR4B = _BV(CS40);
  TCCR4C = _BV(COM4B0S);
  TCCR4D = _BV(WGM40);
  TIMSK4 = _BV(TOIE4);
}


void setup() {
  pinMode(PWM_PIN, OUTPUT);
  audioOn();
}


void loop() {
  //calculate the pitch
  int pwmv = min(1023, analogRead(PITCH_CV) + analogRead(PITCH_KNOB));
  //look up the phase increase per sample
  phase_inc = mapFreq(pwmv);
  //Measure the slave osc's frequency offset
  //we later smooth this to avoid unintended clicks in the sound
  slave_offset_measured = analogRead(SLAVE_KNOB);
  //Measure the amoun of wave-folding needed. This actually results in 2
  //values as we use asymmetrical wave-folding to preserve more of the fundamental
  wrap_factor = min(64 + (analogRead(WRAP_KNOB) >> 1), 511);
  neg_wrap_factor = max(wrap_factor >> 1, 64);
}


SIGNAL(PWM_INTERRUPT) {
  //increase the master phase
  master_phase += phase_inc;

  //slave osc pitch offset smoothing. Without this we'd get undesired clicks in the sound
  if (slave_offset_current < slave_offset_measured) slave_offset_current++;
  else if (slave_offset_current > slave_offset_measured) slave_offset_current--;

  //turn master into a sine, or rather; a close approximation. The proper sine function
  //is slow and practical tables are lo-fi and/or slow as progmem is so slow
  master_value = master_phase;
  master_value <<= 1;
  master_value >>= 8;
  master_value *= (~master_value) & 255;
  master_value <<= 2;
  master_value >>= 8;
  master_polarity = master_phase & 0b1000000000000000;

  //calculate the slave phase in 32bit resolution
  //multiply the phase by a 10 bit number, then go down 8 bits again
  //the result will be a 2 octave increase max.
  //On top of that we say that we want the slave to at least run at
  //the master's phase's rate.
  //Finally we truncate back into 16 bit, as though the slave phase flowed over
  accumulator = master_phase;
  accumulator *= slave_offset_current;
  accumulator >>= 8;
  accumulator += master_phase;
  accumulator &= 65535;  //max 16 bit int

  slave_phase = accumulator;

  //turn slave into a sine too, like we did with the master.
  slave_value = slave_phase;
  slave_value <<= 1;
  slave_value >>= 8;
  slave_value *= (~slave_value) & 255;
  slave_value <<= 2;
  slave_value >>= 8;
  slave_polarity = slave_phase & 0b1000000000000000;

  //multiply master and slave for the ring-mod,
  //taking care to invert the phase where needed
  master_value *= slave_value;
  master_value >>= 8;
  master_polarity ^= slave_polarity;

  master_value = master_value >> 1;

  //wave-wrapping can result in frequency doubling, and we want to preserve bass
  //so we use asymmetrical wave-wrapping
  master_value *= master_polarity ? wrap_factor : neg_wrap_factor;

  //bit-shifting by 8 bits is way faster than by other amounts
  //so this is faster than >>= 6, as we know the topmost bits are 0
  master_value <<= 2;
  master_value >>= 8;

  //detect whether folding will be more involved than inverting the range
  //from 128 to 254
  if (master_value & 0b1111111100000000) {
    //values between 255 and 511 fold back past the "0" line
    if (master_value & 0b0000000100000000) master_polarity = !master_polarity;
    //mask out bits beyond which the process just repeats
    master_value &= 0b0000000011111111;
  }
  //actual folding
  if (master_value > (uint16_t)127) {
    master_value = 127 - (master_value & 0b0000000001111111);
  }

  //only now do we make a bipolar signal
  if (master_polarity) output = 127 - master_value;
  else output = 128 + master_value;
  PWM_VALUE = output;
}
