niektb/sluisbrinkie-eurorack-published/Sluisbrinkie Toepler/Software/hagiwo_fm/hagiwo_fm.ino

#include <MozziGuts.h>
#include <Oscil.h>
#include <tables/cos2048_int8.h> // table for Oscils to play
#include <mozzi_fixmath.h>

#include "PinDef.h"

#define CONTROL_RATE 256 // Hz, powers of 2 are most reliable

Oscil<COS2048_NUM_CELLS, AUDIO_RATE> aCarrier(COS2048_DATA);
Oscil<COS2048_NUM_CELLS, AUDIO_RATE> aModulator(COS2048_DATA);
Oscil<COS2048_NUM_CELLS, CONTROL_RATE> kModIndex(COS2048_DATA);

int voct = 500;

const static float voctpow[1024] PROGMEM = {
 0,  0.004882, 0.009765, 0.014648, 0.019531, 0.024414, 0.029296, 0.034179, 0.039062, 0.043945, 0.048828, 0.05371,  0.058593, 0.063476, 0.068359, 0.073242, 0.078125, 0.083007, 0.08789,  0.092773, 0.097656, 0.102539, 0.107421, 0.112304, 0.117187, 0.12207,  0.126953, 0.131835, 0.136718, 0.141601, 0.146484, 0.151367, 0.15625,  0.161132, 0.166015, 0.170898, 0.175781, 0.180664, 0.185546, 0.190429, 0.195312, 0.200195, 0.205078, 0.20996,  0.214843, 0.219726, 0.224609, 0.229492, 0.234375, 0.239257, 0.24414,  0.249023, 0.253906, 0.258789, 0.263671, 0.268554, 0.273437, 0.27832,  0.283203, 0.288085, 0.292968, 0.297851, 0.302734, 0.307617, 0.3125, 0.317382, 0.322265, 0.327148, 0.332031, 0.336914, 0.341796, 0.346679, 0.351562, 0.356445, 0.361328, 0.36621,  0.371093, 0.375976, 0.380859, 0.385742, 0.390625, 0.395507, 0.40039,  0.405273, 0.410156, 0.415039, 0.419921, 0.424804, 0.429687, 0.43457,  0.439453, 0.444335, 0.449218, 0.454101, 0.458984, 0.463867, 0.46875,  0.473632, 0.478515, 0.483398, 0.488281, 0.493164, 0.498046, 0.502929, 0.507812, 0.512695, 0.517578, 0.52246,  0.527343, 0.532226, 0.537109, 0.541992, 0.546875, 0.551757, 0.55664,  0.561523, 0.566406, 0.571289, 0.576171, 0.581054, 0.585937, 0.59082,  0.595703, 0.600585, 0.605468, 0.610351, 0.615234, 0.620117, 0.625,  0.629882, 0.634765, 0.639648, 0.644531, 0.649414, 0.654296, 0.659179, 0.664062, 0.668945, 0.673828, 0.67871,  0.683593, 0.688476, 0.693359, 0.698242, 0.703125, 0.708007, 0.71289,  0.717773, 0.722656, 0.727539, 0.732421,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
}

AudioOutput_t updateAudio() {
 Q15n16 modulation = deviation * aModulator.next() >> 8;
 return MonoOutput::from8Bit(aCarrier.phMod(modulation)); // Internally still only 8 bits, will be shifted up to 14 bits in HIFI mode
}

void loop() {
 audioHook();
}
