niektb/sluisbrinkie-eurorack-published/Sluisbrinkie Toepler/Software/hagiwo_additive/tables.h

const static byte gain_table[8][256] PROGMEM = {
  { 255, 255, 254, 253, 251, 249, 247, 244, 242, 238, 235, 231, 227, 223, 218, 213, 208, 203, 197, 192, 186, 180, 173, 167, 161, 154, 148, 141, 134, 128, 121, 114, 108, 101, 94, 88, 82, 76, 70, 64, 58, 52, 47, 42, 37, 32, 28, 24, 20, 17, 14, 11, 8, 6, 4, 2, 1, 0, 0, 0, 0, 0, 1, 2, 4, 6, 8, 10, 13, 17, 20, 24, 28, 32, 37, 42, 47, 52, 58, 63, 69, 75, 81, 88, 94, 101, 107, 114, 120, 127, 134, 141, 147, 154, 160, 167, 173, 179, 185, 191, 197, 202, 208, 213, 218, 222, 227, 231, 235, 238, 241, 244, 247, 249, 251, 253, 254, 255, 255, 255, 255, 255, 254, 253, 251, 249, 247, 245, 242, 239, 235, 231, 227, 223, 218, 213, 208, 203, 198, 192, 186, 180, 174, 168, 161, 155, 148, 141, 135, 128, 121, 115, 108, 101, 95, 88, 82, 76, 70, 64, 58, 53, 47, 42, 37, 33, 28, 24, 20, 17, 14, 11, 8, 6, 4, 2, 1, 0, 0, 0, 0, 0, 1, 2, 4, 6, 8, 10, 13, 16, 20, 24, 28, 32, 37, 41, 46, 52, 57, 63, 69, 75, 81, 87, 94, 100, 107, 113, 120, 127, 133, 140, 147, 153, 160, 166, 173, 179, 185, 191, 197, 202, 207, 213, 217, 222, 226, 231, 234, 238, 241, 244, 247, 249, 251, 253, 254, 255, 255, 255, 255, 255, 254, 253, 251, 249, 247, 245, 242, 239, 235, 232, 228, 223, 219, 214 },
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
};
