niektb/sluisbrinkie-eurorack-published/Sluisbrinkie Toepler+/Software/CircuitPython/Firmware/Config/pins.c

// This file is part of the CircuitPython project: https://circuitpython.org
//
// SPDX-FileCopyrightText: Copyright (c) 2021 Scott Shawcroft for Adafruit Industries
//
// SPDX-License-Identifier: MIT

#include "shared-bindings/board/__init__.h"

static const mp_rom_map_elem_t board_module_globals_table[] = {
    CIRCUITPYTHON_BOARD_DICT_STANDARD_ITEMS

    { MP_ROM_QSTR(MP_QSTR_CV1), MP_ROM_PTR(&pin_GPIO26) },
    { MP_ROM_QSTR(MP_QSTR_CV2), MP_ROM_PTR(&pin_GPIO27) },
    { MP_ROM_QSTR(MP_QSTR_CV3), MP_ROM_PTR(&pin_GPIO28) },
    { MP_ROM_QSTR(MP_QSTR_OUT2), MP_ROM_PTR(&pin_GPIO1) },
    { MP_ROM_QSTR(MP_QSTR_OUT1), MP_ROM_PTR(&pin_GPIO0) },
    { MP_ROM_QSTR(MP_QSTR_TX), MP_ROM_PTR(&pin_GPIO12) },
    { MP_ROM_QSTR(MP_QSTR_RX), MP_ROM_PTR(&pin_GPIO13) },
    { MP_ROM_QSTR(MP_QSTR_SW1), MP_ROM_PTR(&pin_GPIO8) },
    { MP_ROM_QSTR(MP_QSTR_LED), MP_ROM_PTR(&pin_GPIO14) },
    { MP_ROM_QSTR(MP_QSTR_D13), MP_ROM_PTR(&pin_GPIO14) },
    { MP_ROM_QSTR(MP_QSTR_BUTTON), MP_ROM_PTR(&pin_GPIO4) },
    { MP_ROM_QSTR(MP_QSTR_BOOT), MP_ROM_PTR(&pin_GPIO4) },
    { MP_ROM_QSTR(MP_QSTR_NEOPIXEL), MP_ROM_PTR(&pin_GPIO16) },
    { MP_ROM_QSTR(MP_QSTR_UART), MP_ROM_PTR(&board_uart_obj) },
};
MP_DEFINE_CONST_DICT(board_module_globals, board_module_globals_table);
