niektb/sluisbrinkie-eurorack-published/Sluisbrinkie Toepler/Software/Hardware Test/MidiInTest/MidiInTest.ino

/*  Example of a sound being triggered by MIDI input.

    Demonstrates playing notes with Mozzi in response to MIDI input,
    using  Arduino MIDI library v4.2
    (https://github.com/FortySevenEffects/arduino_midi_library/releases/tag/4.2)

    Circuit:
      MIDI input circuit as per http://arduino.cc/en/Tutorial/Midi
      Note: midi input on rx pin, not tx as in the illustration on the above page.
      Midi has to be disconnected from rx for sketch to upload.
      Audio output on digital pin 9 on a Uno or similar.

		Mozzi documentation/API
		https://sensorium.github.io/Mozzi/doc/html/index.html

		Mozzi help/discussion/announcements:
    https://groups.google.com/forum/#!forum/mozzi-users

    Tim Barrass 2013-14, CC by-nc-sa.
*/

#include <MIDI.h>
#include <MozziGuts.h>
#include <Oscil.h>                // oscillator template
#include <tables/sin2048_int8.h>  // sine table for oscillator
#include <mozzi_midi.h>
#include <ADSR.h>


MIDI_CREATE_DEFAULT_INSTANCE();

// use #define for CONTROL_RATE, not a constant
#define CONTROL_RATE 128  // Hz, powers of 2 are most reliable

// audio sinewave oscillator
Oscil<SIN2048_NUM_CELLS, AUDIO_RATE> aSin(SIN2048_DATA);

// envelope generator
ADSR<CONTROL_RATE, AUDIO_RATE> envelope;

#define LED 13  // shows if MIDI is being recieved

void HandleNoteOn(byte channel, byte note, byte velocity) {
  Serial.println("Note received");
  aSin.setFreq(mtof(float(note)));
  envelope.noteOn();
  digitalWrite(LED, HIGH);
}

void HandleNoteOff(byte channel, byte note, byte velocity) {
  envelope.noteOff();
  digitalWrite(LED, LOW);
}

void setup() {
  delay(2000);

  pinMode(LED, OUTPUT);
  Serial.begin(9600);
  Serial.println("Hello world!");


  // Connect the HandleNoteOn function to the library, so it is called upon reception of a NoteOn.
  MIDI.setHandleNoteOn(HandleNoteOn);    // Put only the name of the function
  MIDI.setHandleNoteOff(HandleNoteOff);  // Put only the name of the function
  // Initiate MIDI communications, listen to all channels (not needed with Teensy usbMIDI)
  MIDI.begin();

  envelope.setADLevels(255, 64);
  envelope.setTimes(50, 200, 10000, 200);  // 10000 is so the note will sustain 10 seconds unless a noteOff comes

  aSin.setFreq(440);  // default frequency
  startMozzi(CONTROL_RATE);
}


void updateControl() {
  MIDI.read();
  envelope.update();
}


AudioOutput_t updateAudio() {
  return MonoOutput::from16Bit(envelope.next() * aSin.next());
}


void loop() {
  audioHook();  // required here
}
