niektb/sluisbrinkie-eurorack-published/(commit log)

2024-01-06 Add copies of ARP software, add Schematic PDF, add README's
2024-01-27 Now with both schematic pages
2024-02-20 Port Mozzi-Grains-Krachmacher to Toepler (and improve the routing mode selection by using buttons)
2024-02-21 Simple Eurorack Busboard project
    [kirchhoff.brd, kirchhoff.sch]
2024-03-02 Backup in case Rebel Technology Patch library goes down again
2024-05-24 Add pictures of Gauss PCB
2024-05-24 Add pictures of Oppitz Mini PCB
2024-05-27 Improve pitch tracking
2024-09-14 First schematic version of Beaks Pro (Beaks with CV inputs)
    [ain.kicad_sch, analog_in.kicad_sch, beaks_pro.kicad_pcb, beaks_pro.kicad_sch, beaks_pro.sch, front.kicad_sch, input.kicad_sch, main.kicad_sch]
2024-09-14 Add step files for Bluepill, pots and jacks. Add BOM entries for bluepill headers
    [RK09D1130-F20.STEP, RK09K1130-20.STEP, STM32F103C8T6_Blue_Pill v6.step, Thonkicon.obj, Thonkiconn - PJ398SM.step, beaks_pro.kicad_pcb, front.kicad_sch, stm32.kicad_sch]
2024-09-14 Change trigger switches into the illuminated ones
    [LP4xx1PxCxx.stp, front.kicad_sch]
2024-09-16 Add output attenuverters, mounting hole footprints
    [beaks_pro.kicad_sch, front.kicad_sch, out.kicad_sch]
2024-09-16 Update PCB from schematics
    [beaks_pro.kicad_pcb]
2024-09-16 Pre-placement on layout, 8HP version
    [beaks_pro.kicad_pcb]
2024-09-16 fix mirrored B2B connector
    [front.kicad_sch, out.kicad_sch]
2024-09-16 10HP Version
    Initial commit with populated PCB for 10HP ver.
    [beaks_pro_10HP.kicad_pcb, beaks_pro_10HP.kicad_sch, input.kicad_sch, out.kicad_sch, power.kicad_sch]
2024-09-17 Back PCB Done
    [beaks_pro_10HP.kicad_pcb]
2024-09-17 Increased via spacing to a minimum of 0.25mm
    [beaks_pro_10HP.kicad_pcb]
2024-09-17 Add Asrafiel's layout in separate folder (10HP)
    [LP4xx1PxCxx.stp, RK09D1130-F20.STEP, RK09K1130-20.STEP, STM32F103C8T6_Blue_Pill v6.step, Thonkicon.obj, Thonkiconn - PJ398SM.step, ain.kicad_sch, analog_in.kicad_sch]
2024-09-18 V0.1 Alpha
    [beaks_pro_10HP.kicad_pcb, beaks_pro_10HPFront.dsn]
2024-09-18 Layout done on 8HP SMT version
    [ain.kicad_sch, beaks_pro.kicad_pcb, beaks_pro.kicad_sch, front.kicad_sch, input.kicad_sch, out.kicad_sch, power.kicad_sch, stm32.kicad_sch]
2024-09-18 Split 8HP design up in separate files, for SMT export. Add step file export
    [LP4xx1PxCxx.stp, RK09D1130-F20.STEP, RK09K1130-20.STEP, STM32F103C8T6_Blue_Pill v6.step, Thonkicon.obj, Thonkiconn - PJ398SM.step, beaks_pro.kicad_pcb, beaks_pro.kicad_sch]
2024-09-19 rename 8HP to Andes, add 3D files for mechanical checking, restore refdes on frontpcb
    [LP4xx1PxCxx.stp, RK09D1130-F20.STEP, RK09K1130-20.STEP, STM32F103C8T6_Blue_Pill v6.step, Thonkicon.obj, Thonkiconn - PJ398SM.step, analog_in.kicad_sch, andes.kicad_pcb]
2024-09-19 Properly delete
    [frontpanel.kicad_pcb]
2024-09-19 Version 0.1 UNTESTED
    [beaks_pro_10HP.kicad_pcb]
2024-09-20 Create production files for 8HP version
    [andes.kicad_pcb, bom.csv, designators.csv, front_pcb.kicad_pcb, positions.csv]
2024-09-20 Prepare KiCad project for 12HP version
    [LP4xx1PxCxx.stp, RK09D1130-F20.STEP, RK09K1130-20.STEP, STM32F103C8T6_Blue_Pill v6.step, Thonkicon.obj, Thonkiconn - PJ398SM.step, andes_12hp.kicad_pcb, andes_12hp.kicad_sch]
2024-09-20 v0.1 Andes 10HP UNTESTED
    [LP4xx1PxCxx.stp, RK09D1130-F20.STEP, RK09K1130-20.STEP, STM32F103C8T6_Blue_Pill v6.step, Thonkicon.obj, Thonkiconn - PJ398SM.step, andes_10HP.kicad_pcb, andes_10HP.kicad_sch]
2024-09-20 Small updates.
    [andes_10HP.kicad_pcb]
2024-09-20 Rename Beaks Pro folder into Andes
    [LP4xx1PxCxx.stp, RK09D1130-F20.STEP, RK09K1130-20.STEP, STM32F103C8T6_Blue_Pill v6.step, Thonkicon.obj, Thonkiconn - PJ398SM.step, andes.kicad_pcb, andes.kicad_sch]
2024-10-03 [Andes 8HP] Fix floating copper, swap some LEDs and potmeter
    [designators.csv, front_pcb.kicad_pcb, front_pcb.kicad_sch, positions.csv]
2024-10-06 Fix attenuverter inversion, generate new gerber, update .gitignore
    [front_pcb.kicad_pcb, front_pcb.kicad_sch]
2024-11-04 Publish USB-C PSU
    [USB_C_PD_PSU.kicad_pcb, USB_C_PD_PSU.kicad_sch, bom.csv, designators.csv, positions.csv]
2024-11-06 Generate iBOM for Andes 8HP
    [andes.csv, andes.kicad_pcb, andes.kicad_sch]
2024-12-30 Add new step files, new symbols and footprints (used in Toepler+)
    [1900h-bk-T-D.stp, Black - With Line (D-Shaft).stp, KNUT-PJ398SM.stp, R0904N-L-20KQ.stp]
2025-01-05 Rearrange files, add Monosynth and Wavetable Synth firmware. Add Readme. Add PDF export of schematic
2025-01-24 Add new schematic PDF for Andes 8HP
2025-01-30 Update Andes 8HP with fixes
    [andes.kicad_pcb, bom.csv, positions.csv, power.kicad_sch]
2025-02-02 Sync changes in 8HP Andes to 12HP Andes
    [andes_12hp.kicad_pcb, front.kicad_sch, out.kicad_sch, power.kicad_sch]
2025-02-02 Sluisbrinkie Jacquard
    [bom.csv, designators.csv, frontpanel.kicad_pcb, frontpanel.kicad_sch, positions.csv]
2025-02-23 Update footprints
2025-04-03 Update KiCad project files
    [USB-C PCB vertical.stp, bom.csv, designators.csv, files_SMC.STEP, positions.csv, toepler_plus.kicad_pcb, toepler_plus.kicad_sch, toepler_plus.step]
2025-04-17 Introducing the Braun
    [1900h-bk-T-D.stp, Black - With Line (D-Shaft).stp, GMT020-02 TFT SPI 240x320.STEP, KNUT-PJ398SM.stp, LP4xx1PxCxx.stp, Nut M7x075.stp, PI_SCOPE.kicad_pcb, PI_SCOPE.kicad_sch]
2025-04-17 New grains ports. TODO: pitch and CV input scaling
2025-04-24 Introducing Herford
    [1900h-bk-T-D.stp, 200-MSP-1-T3-B1-M2-PE-rev2.step, Black - With Line (D-Shaft).stp, KNUT-PJ398SM.stp, LP4xx1PxCxx.stp, R0904N-L-20KQ.stp, RK09D1130-F20.STEP, RK09K1130-20.STEP]
2025-04-24 Update schematic and readme
    [herford.kicad_sch]
2025-05-22 Add new parts to library (I should really clean this up)
    [OLED_0.91_128x32.stp]
2025-05-23 [Braun] Several hardware fixes, move display from SPI1 to SPI0
    [PI_SCOPE.kicad_pcb, PI_SCOPE.kicad_sch, bom.csv, designators.csv, positions.csv]
2025-05-27 Small silkscreen fixes
    [PI_SCOPE.kicad_pcb]
2025-06-12 First HW version of MMM
    [MMM_main.kicad_pcb, MMM_main.kicad_sch, bom.csv, designators.csv, mmm_frontpanel.kicad_pcb, mmm_frontpanel.kicad_sch, positions.csv]
2025-06-12 Generate Schematic PDF, rearrange folder structure
    [MMM_main.kicad_pcb, MMM_main.kicad_sch, bom.csv, designators.csv, mmm_frontpanel.kicad_pcb, mmm_frontpanel.kicad_sch, positions.csv]
2025-06-18 Add Arduino Board definition to MMM
2025-11-06 Initial versions of iCERack and FV-1 module (untested!)
    [1900h-bk-T-D.stp, 200-MSP-1-T3-B1-M2-PE-rev2.step, Black - With Line (D-Shaft).stp, KNUT-PJ398SM.stp, LP4xx1PxCxx.stp, OLED_0.91_128x32.stp, R0904N-L-20KQ.stp, RK09D1130-F20.STEP]
2025-11-10 Delete ADAU1701/adau1701 directory
    Not finished yet
    [adau1701.kicad_pcb]
2025-12-26 [USB-C PD] Fix LED indication, convert HW from KiCad 8 to 9
    [pin_def.h, usb_c_pd.ino]
2025-12-26 Update README with library info and board status
    Added library prerequisite and modified I2C address instructions. Updated the status of board functionality.
2026-03-01 Remove iCERack due to some fundamental issues
    [1900h-bk-T-D.stp, 200-MSP-1-T3-B1-M2-PE-rev2.step, Black - With Line (D-Shaft).stp, KNUT-PJ398SM.stp, LP4xx1PxCxx.stp, OLED_0.91_128x32.stp, R0904N-L-20KQ.stp, RK09D1130-F20.STEP]
2026-04-09 Rename to actual module name
    [1900h-bk-T-D.stp, 200-MSP-1-T3-B1-M2-PE-rev2.step, Black - With Line (D-Shaft).stp, KNUT-PJ398SM.stp, LP4xx1PxCxx.stp, OLED_0.91_128x32.stp, R0904N-L-20KQ.stp, RK09D1130-F20.STEP]
2026-05-27 Add Müller
    [bom.csv, designators.csv, muller.kicad_pcb, muller.kicad_sch, muller_frontplate.kicad_pcb, muller_frontplate.kicad_sch, positions.csv]
2026-05-29 Generate production files
    [bom.csv, designators.csv, herford.kicad_pcb, herford.kicad_sch, positions.csv]
2026-06-30 First Divide By N version
    [divn.kicad_pcb, divn.kicad_sch]
2026-06-30 Also commit PDF of schematic
