niektb/sluisbrinkie-eurorack-published/(notices)

Notices in the files:
Sluisbrinkie Toepler/Software/ports_of_grains/Grains-Scheveningen/Grains-Scheveningen.ino:
This program is free software: you can redistribute it and/or modify
it under the terms of the GNU General Public License as published by
the Free Software Foundation, either version 2 of the License, or
(at your option) any later version.
Sluisbrinkie Toepler/Software/ports_of_grains/roundhouse/kas-button.h:
Copyright (C) 2017 Kassen Oud
modify it under the terms of the GNU General Public License
Sluisbrinkie Shannon/kicad/fv1_module/STEP/Thonkiconn - PJ398SM.step:
description */ ('Thonkiconn (PJ398SM). License: CC BY-SA 4.0.'),
